pablomattos/projeto-tcc-2026/AD5941/comparative-anaysis/comparative-analysis.md

Aqui está a documentação técnica estruturada e formatada de forma limpa em **Markdown**, seguida pelo código Python integrado para gerar automaticamente o arquivo correspondente em **Microsoft Word (.docx)** para download imediato.

---

# Documentação Técnica: Análise Comparativa — AD5940/AD5941 vs. ADuCM355

**Autor:** Engenharia de Desenvolvimento

**Contexto:** Avaliação de arquitetura para o desenvolvimento de sensores analógicos de precisão, espectroscopia de bioimpedância (EIS) e medições eletroquímicas.

---

## 1. Introdução

A escolha entre o arranjo AD5940/AD5941 (Front-End Analógico integrado operando com microcontrolador host externo via SPI) e o ADuCM355 (Microcontrolador analógico integrado de chip único) dita as diretrizes de custo, tamanho e complexidade de desenvolvimento de um sensor eletrônico. Ambas as plataformas são desenvolvidas pela Analog Devices e oferecem blocos analógicos avançados equivalentes para medições na faixa de 0.016 Hz a 200 kHz. Esta documentação estabelece os critérios técnicos e financeiros para a tomada de decisão de engenharia.

---

## 2. Especificações Técnicas e Comparativo Direto

Abaixo encontra-se a tabela comparativa estruturada com os parâmetros fundamentais de cada plataforma:

| Parâmetro Técnico | Plataforma AD5940 / AD5941 | Plataforma ADuCM355 |
| --- | --- | --- |
| **Tipo de Arquitetura** | Analog Front-End (AFE) Puro. Requer MCU externo. | System-on-Chip (SoC) Analógico + Digital Completo. |
| **Processador Integrado** | Não possui (Depende de Host externo via SPI). | ARM Cortex-M3 (32 bits) operando até 26 MHz. |
| **Memória Interna** | Apenas FIFO de dados de 6 kB. | 128 kB de Memória Flash / 32 kB de SRAM. |
| **Encapsulamento / Pins** | **AD5940:** WLCSP (56 esferas)<br>

<br>**AD5941:** LFCSP (48 terminais, 7mm x 7mm). | LGA (72 terminais, 6mm x 5mm). |
| **Conversor Analógico-Digital (ADC)** | 16 bits, SAR ADC progressivo até 800 kSPS / 1.6 MSPS. | 16 bits, SAR ADC progressivo até 400 kSPS. |
| **Canais Eletroquímicos (TIAs)** | 1x TIA de Alta Velocidade (Impedância)<br>

<br>1x Potenciostato/TIA de Baixa Potência. | 1x TIA de Alta Velocidade (Impedância)<br>

<br>2x Potenciostatos/TIAs de Baixa Potência dedicados. |
| **Periféricos Digitais** | SPI (Slave), GPIOs limitados, saídas de interrupção. | I2C, SPI, UART, PWM, Timers, GPIOs configuráveis. |

---

## 3. Análise de Complexidade de Hardware (Layout da PCB)

O impacto do encapsulamento no design físico da placa de circuito impresso é um fator crítico para o custo de fabricação industrial:

* **AD5941 (LFCSP-48):** Possui pinos expostos nas laterais do chip (passo de 0.5 mm). Permite o desenvolvimento de placas de circuito impresso de 2 ou 4 camadas comuns, com vias padrão. É totalmente viável para soldadura manual em ambiente de laboratório usando estações de ar quente convencionais.
* **ADuCM355 (LGA-72):** Possui uma matriz de pinos oculta sob o encapsulamento, concentrada em uma área de apenas 6mm x 5mm. Exige estritamente placas de circuito impresso de alta densidade (mínimo de 4 a 6 camadas), com trilhas de isolamento ultra-finas e vias metalizadas microscópicas. A soldadura exige precisão industrial por forno de refluxo e aplicação automatizada de pasta de solda por stencil.

---

## 4. Análise de Arquitetura e Complexidade de Software

O modelo de desenvolvimento de firmware divide-se entre soluções modulares e de chip único:

### Abordagem AD5941 + MCU Externo (Ex: ESP32)

O desenvolvedor programa o microcontrolador host principal (utilizando ecossistemas amigáveis como Arduino IDE ou ESP-IDF para o ESP32). A Analog Devices fornece a biblioteca de firmware em C chamada `AD5940-BIFH`, encarregada de empacotar os comandos de registradores analógicos enviados via barramento SPI. A curva de aprendizado é menor, visto que as tarefas de conectividade (Wi-Fi/Bluetooth do ESP32) e o processamento analógico rodam em núcleos isolados, reduzindo interferências mútuas de temporização.

### Abordagem ADuCM355 Autónoma

O desenvolvedor programa diretamente o núcleo ARM Cortex-M3 interno usando ferramentas profissionais como Keil MDK ou IAR Embedded Workbench. Toda a gestão de registros, buffers internos de medição, calibração matemática de fase por DFT e tratamento de protocolos de comunicação externa precisam compartilhar os recursos internos de memória do chip. A arquitetura de software é altamente integrada, exigindo sólidos conhecimentos em sistemas embarçados ARM puros.

---

## 5. Avaliação Financeira e de Implementação (BOM)

Em termos de custo de componentes e insumos secundários:

1. **Produção em Baixa Escala / Protótipos:** A solução AD5941 combinada com um DevKit comercial (ESP32) apresenta custos muito inferiores. O DevKit elimina custos com reguladores chaveados e circuitos de gravação USB-UART. Os componentes periféricos (resistores de precisão de 0.1% e capacitores C0G/NP0 para o cristal externo) são baratos e fáceis de dispor em layouts LFCSP menos restritivos.
2. **Produção em Massa:** Custo unitário do circuito integrado AD5941 isolado é consideravelmente menor que o do ADuCM355. Mesmo adicionando um microcontrolador externo de baixo custo na placa, o preço do conjunto de silício costuma manter-se mais competitivo no modelo AFE + MCU separado. O ADuCM355 apenas se torna financeiramente justificável se o custo de miniaturização extrema for o principal requisito comercial do produto.

---

## 6. Diretrizes de Decisão (Veredicto)

Com base nos dados analisados, as recomendações de engenharia para o projeto são:

* **Escolha o AD5941 se:** O objetivo for flexibilidade de processamento, facilidade de soldadura e prototipagem rápida, menor custo de fabricação de PCB e se for necessária conectividade sem fios nativa através do uso conjunto com o ESP32.
* **Escolha o ADuCM355 se:** O espaço físico final do dispositivo for o parâmetro mais crítico (dispositivos médicos implantáveis ou vestíveis minúsculos - *wearables*) onde não há espaço mecânico para acomodar dois circuitos integrados na mesma face da placa.

---
