pablomattos/projeto-tcc-2026/AD5933/AD5933-projects/docs-TCC/inicio-TCC.md

---

# ANÁLISE DE PROJETOS BASEADOS NO CI AD5933 E A NECESSIDADE DE CIRCUITOS DE FRONT-END ANALÓGICO

## 1. Introdução

O circuito integrado AD5933, desenvolvido pela Analog Devices, é amplamente utilizado em sistemas de medição de impedância devido à sua alta integração, baixo custo e capacidade de realizar análise espectral por meio da Transformada Discreta de Fourier (DFT). Apesar dessas vantagens, diversos estudos demonstram que o uso direto desse componente apresenta limitações significativas, tornando necessário o desenvolvimento de circuitos auxiliares, conhecidos como front-end analógico (AFE).

Este trabalho tem como objetivo analisar diferentes projetos baseados no AD5933, destacando seus principais aspectos e, sobretudo, justificando a necessidade da utilização de circuitos de front-end analógico.

---

## 2. Revisão dos Projetos

### 2.1 Projeto AD5933-based spectrometer for electrical bioimpedance

Este projeto tem como objetivo o desenvolvimento de um espectrômetro de bioimpedância elétrica voltado a aplicações biomédicas, incluindo monitoramento fisiológico e dispositivos vestíveis. O sistema realiza medições de impedância em tecidos biológicos utilizando modelos equivalentes do tipo 2R1C, com varredura em frequência e análise dos parâmetros resistivos e capacitivos.

**Principais parâmetros:**

* **Faixa de frequência:** 5 kHz a 100 kHz
* **Modelo elétrico:** 2R1C (Re, Ri, Cm)
* **Número de medições:** 100 por ensaio

Entretanto, o AD5933 apresenta limitações relevantes nesse contexto, como a possibilidade de medição apenas em configuração de dois eletrodos, elevada sensibilidade à impedância de contato, restrições de frequência e menor acurácia quando comparado a equipamentos comerciais.
Diante disso, o front-end analógico foi desenvolvido para implementar a técnica de quatro eletrodos, eliminando a influência da impedância de contato entre eletrodo e pele. Essa adaptação possibilitou medições mais precisas e confiáveis, adequadas para aplicações biomédicas.

### 2.2 Projeto FruitMeter (Agricultura Inteligente)

O projeto Design and Validation of a Portable AD5933–Based Impedance Analyzer for Smart Agriculture propõe o desenvolvimento de um analisador portátil de impedância para monitoramento da qualidade de frutas ao longo da cadeia produtiva. O sistema realiza medições em diferentes frequências, com controle por microcontrolador e comunicação sem fio, permitindo análises diretamente em campo.

**Principais parâmetros:**

* **Faixa de frequência:** 10 Hz a 100 kHz
* **Ajustes:** Tensão de excitação, ganho e resistor de feedback (RFB)
* **Erro:** Aproximadamente 7% em amostras reais

As limitações observadas no AD5933 incluem faixa limitada de impedância, necessidade de calibração específica, sensibilidade a variações de ganho e dificuldades na medição de impedâncias muito baixas.
Nesse contexto, o front-end foi desenvolvido para adaptar o sistema às diferentes impedâncias das frutas, permitindo ajuste de ganho, controle da excitação e melhoria da relação sinal-ruído, o que garante medições mais estáveis em condições variáveis.

### 2.3 Projeto de Monitoramento Estrutural

O estudo Development of an AD5933-based impedance calibration and measurement technology tem como objetivo aplicar a técnica de impedância eletromecânica (EMI) para detecção de danos estruturais. O sistema utiliza sensores piezoelétricos excitados eletricamente, cujas respostas em frequência são analisadas para identificar alterações estruturais.

**Principais parâmetros:**

* **Ajuste do resistor de feedback (RFB)**
* **Fator de ganho (GF)**
* **Análise por DFT**
* **Faixa de frequência:** Até 100 kHz

As limitações do AD5933 nesse caso envolvem dependência crítica de calibração, necessidade de escolha adequada de parâmetros, sensibilidade a ruídos e variações, além da dependência de equipamentos externos.
O front-end analógico foi desenvolvido para permitir ajuste dinâmico de ganho e aprimorar a calibração, garantindo que pequenas variações de impedância, essenciais para a detecção de falhas estruturais, sejam corretamente capturadas.

### 2.4 Projeto Simple-Z

O projeto Simple-Z: A Low-Cost Portable Impedance Analyzer tem como objetivo a criação de um analisador de impedância portátil de baixo custo, com desempenho comparável ao de equipamentos comerciais. O sistema utiliza o AD5933 em conjunto com circuitos externos de amplificação e controle de sinal, além de uma interface gráfica para operação.

**Principais parâmetros:**

* **Faixa de impedância:** 100 Ω a 1MΩ
* **Frequência:** Até 100 kHz
* **Ajuste de amplitude:** 10 mV a 1 V

As limitações do AD5933 incluem amplitude de excitação limitada, presença de offset DC, faixa de impedância restrita e limitações do conversor analógico-digital (ADC) interno.
Nesse projeto, o front-end foi desenvolvido para expandir as capacidades do circuito, permitindo controle da amplitude do sinal, remoção de offset e ampliação da faixa de medição, transformando o sistema em um instrumento mais completo.

### 2.5 Projeto de Tomografia por Impedância

O projeto Portable impedance tomography system based on AD5933 tem como objetivo o desenvolvimento de um sistema de tomografia por impedância elétrica (EIT) para obtenção de imagens internas. O sistema realiza medições sequenciais entre múltiplos eletrodos e utiliza os dados coletados para reconstrução de imagens.

**Principais parâmetros:**

* **Sistema:** Multicanal
* **Operação:** Varredura em frequência e matrizes de impedância

As limitações do AD5933 nesse contexto incluem a capacidade de medir apenas um canal por vez, baixa velocidade para aplicações multicanais e sensibilidade a ruídos.
O front-end foi desenvolvido para implementar a multiplexação de canais, permitindo a aquisição das múltiplas medições necessárias para a reconstrução das imagens.

---

## 3. Discussão Geral

A análise dos projetos demonstra que, embora o AD5933 seja um componente versátil, ele não é suficiente para aplicações práticas sem suporte adicional. O front-end analógico atua como um elemento essencial de adaptação entre o sistema de medição e o ambiente físico.

**As principais funções do front-end incluem:**

1. Ajuste de ganho e da faixa de medição.
2. Controle da excitação do sinal.
3. Redução de ruído e aumento da precisão.
4. Adaptação a diferentes tipos de sensores.
5. Implementação de arquiteturas específicas (quatro eletrodos, multicanais, etc.).

---

## 4. Conclusão

Conclui-se que o desenvolvimento de circuitos de front-end analógico é indispensável em sistemas baseados no AD5933. Esses circuitos não apenas compensam as limitações do componente, mas também ampliam significativamente suas capacidades, viabilizando sua aplicação em diferentes áreas, como biomédica, agrícola, estrutural e de imageamento.
Em síntese, o front-end analógico não deve ser considerado um complemento opcional, mas sim um elemento fundamental para garantir medições confiáveis, precisas e compatíveis com condições reais de operação.
