pablomattos/projeto-tcc-2026/AD5933/AD5933-projects/AD933-projects-docs/AD5933-projects-table/tabela-projetos.md

| Artigo / Aplicação | Objetivo do Projeto | Modo de Operação | Parâmetros Utilizados | Limitações do AD5933 |
| --- | --- | --- | --- | --- |
| **AD5933-based spectrometer for electrical bioimpedance applications** | Desenvolver espectrômetro de bioimpedância com front-end de 4 eletrodos | Medição em modelos biológicos (2R1C), comparação com equipamento comercial, análise espectral | Frequência: 5–100 kHz; parâmetros: Re, Ri, Cm; 100 medições por teste | Menor acurácia que equipamentos profissionais; distorções em alta frequência; depende de front-end externo; faixa de frequência limitada |
| **Design and Validation of a Portable AD5933–Based Impedance Analyzer for Smart Agriculture** | Criar analisador portátil para monitorar qualidade de frutas | Sistema embarcado com STM32, comunicação Bluetooth/USB, medições programadas e calibração por faixa | Frequência: 10 Hz–100 kHz; ajuste de tensão, ganho (PGA), RFB e settling time; erro: ~1–7% | Calibração complexa; necessidade de múltiplas faixas; ruído fora da faixa calibrada; limitação de impedâncias baixas |
| **Development of an AD5933-based impedance calibration and measurement technology** | Melhorar medição para monitoramento estrutural com auto-calibração | Técnica EMI com sensores piezoelétricos, seleção automática de parâmetros, análise por DFT | Ajuste automático de RFB, ganho e fator GF; uso de DFT interno; múltiplas frequências | Forte dependência de calibração; requer instrumento externo; sensível à escolha de parâmetros; descontinuidade de dados |
| **Simple-Z: A Low-Cost Portable Impedance Analyzer** | Desenvolver analisador portátil de baixo custo (~US$100) | AD5933 com circuitos externos (amplificação, multiplexação), GUI para controle, processamento digital | Frequência até ~100 kHz; impedância: ~100 Ω a 1MΩ; ajuste de amplitude (10 mV–1 V); múltiplos RFB | Limitações nativas (amplitude e faixa); necessidade de hardware adicional; limitação do ADC; calibração obrigatória |
| **Portable impedance tomography system based on AD5933** | Sistema de tomografia por impedância multicanal | Multiplexação de eletrodos, varredura de frequência, reconstrução de imagem | Sistema multi-canais (ex: 8); matrizes de impedância; aquisição sequencial | Não suporta multicanal nativo; baixa velocidade; sensível a ruído; resolução limitada para imagem |

---
