pablomattos/projeto-tcc-2026/AD5941/AD5941-projects/AD5941-projects-docs/AD5941-projects-table/tabelas-projetos.md

---

### Tabela Comparativa de Aplicações e Artigos com o AD5941

| Artigo / Aplicação Típica | Objetivo do Projeto | Modo de Operação | Parâmetros Utilizados | Limitações Críticas do AD5941 Identificadas |
| --- | --- | --- | --- | --- |
| **Espectroscopia de Bioimpedância Elétrica (EIS) Vestível** *(Ex: Patches de hidratação e wearables médicos)* | Monitorar parâmetros fisiológicos contínuos (edemas, composição tecidual ou variação volumétrica de fluidos) diretamente no corpo humano. | Excitação por corrente ou tensão senoidal multifrequencial utilizando a malha de 4 elétrodos para eliminar a impedância de contato pele-eletrodo. | • **Frequência:** 10 Hz a 200 kHz<br>

<br>• **Amostragem:** Até 800 kSPS<br>

<br>• **Processamento:** Motor interno de DFT (16-bit SAR ADC). | • **Limite de Frequência Superior (200 kHz):** Embora atenda à maioria das aplicações biológicas, é insuficiente para caracterizar fenômenos dielétricos celulares em frequências de MHz (frequências de transição de membrana). |
| **Biossensores de Afinidade e Dispositivos Point-of-Care** *(Ex: Diagnóstico rápido de vírus e patógenos)* | Detectar a hibridização de DNA ou ligações antígeno-anticorpo em microeletrodos através da variação da impedância da interface eletrodo-eletrólito. | Varredura ratiométrica de impedância combinada com técnicas eletroquímicas de pulso (Amperometria ou Voltametria Cíclica) para monitoramento de superfície. | • **Frequência:** 0.016 Hz a 200 kHz<br>

<br>• **Sinal:** Senoides de baixa amplitude (< 50 mV) para não danificar o biofilme. | • **Saturação do HSTIA em Altas Frequências:** O Amplificador de Transimpedância de Alta Velocidade (HSTIA) pode sofrer instabilidade ou saturação se a capacitância de dupla camada do sensor for muito elevada próximo ao limite de 200 kHz.<br>

<br>• Sensibilidade extrema a ruídos de layout na PCB devido à escala de nanoamperes medida. |
| **Espectroscopia de Impedância Eletroquímica (EIS) em Baterias** *(Ex: Sensores inteligentes de State of Health - SoH)* | Mapear a impedância complexa interna de células de íons de Lítio para prever o envelhecimento químico e variações térmicas. | Varredura de frequência ultrabaixa acoplada a uma malha de potência externa (visto que o chip opera em baixa potência), utilizando o gerador de ondas integrado. | • **Frequência:** 0.1 Hz a 10 kHz<br>

<br>• **Interface:** SPI síncrona com interrupção externa (IRQ). | • **Incapacidade de Corrente Direta (DC) Elevada:** O potenciostato interno do AD5941 é projetado para correntes na escala de miliamperes ($\pm6.5\text{ mA}$ máx). Para testar baterias reais sob carga, exige circuitos integrados de potência injetores e isoladores galvânicos externos robustos. |
| **Sensores de Gases Eletroquímicos e Amperométricos** *(Ex: Detectores industriais de CO, NOx ou O2)* | Monitorar a concentração de gases tóxicos através da corrente de oxirredução gerada em uma célula galvânica/potenciostática. | Modo Potenciostato de Baixa Potência (*Low Power Loop*). O circuito mantém o eletrodo de referência polarizado enquanto o amplificador lê correntes contínuas na escala de nanoamperes. | • **Modo:** Amperometria de Potência Ultra-Baixa<br>

<br>• **Consumo Local:** < 100 $\mu$A em modo de hibernação ativa. | • **Limitação de Canais Simultâneos:** O AD5941 possui apenas **um** canal completo de TIA de Alta Velocidade e uma malha de baixa potência. Se o projeto exigir um nariz eletrônico (matriz com múltiplos sensores de gases diferentes medindo ao mesmo tempo), é necessário duplicar os chips ou criar matrizes de chaveamento complexas. |

---

### Principais Desafios de Engenharia com o AD5941:

* **Gestão da FIFO em Firmware:** O barramento SPI precisa ser gerenciado via interrupções externas ($IRQ$) de forma ultra-rápida. Se a MCU host (como o ESP32) atrasar a leitura devido a tarefas prioritárias do Wi-Fi ou Bluetooth, a FIFO de 6 kB estoura (*overflow*) e corrompe os dados da varredura.
* **Layout Crítico da PCB:** O encapsulamento LFCSP-48 possui um *pitch* de 0.5 mm. Devido à alta sensibilidade analógica (escala de pico/nanoamperes), qualquer fuga de corrente ou capacitância parasita próxima às trilhas dos elétrodos degrada a precisão das leituras de fase.
