pablomattos/projeto-tcc-2026/AD5933/codes/esp-code/teoric/Bioimpedance_Firmware_Blueprints.pptx

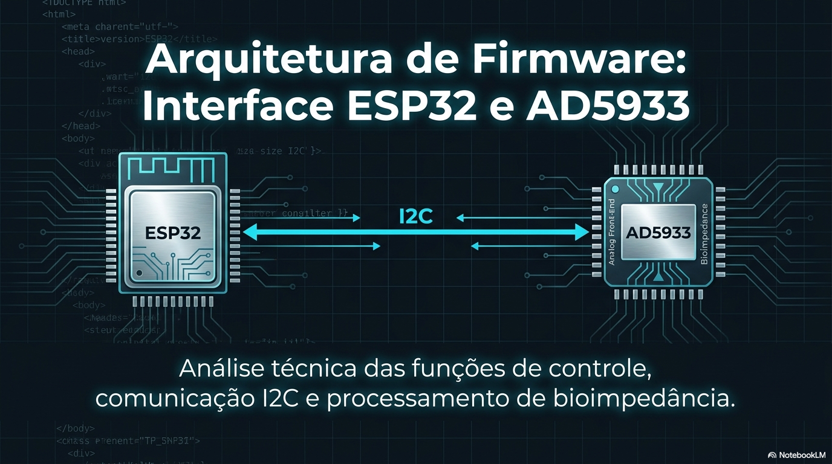
[picture p9: figure]

## Slide 2

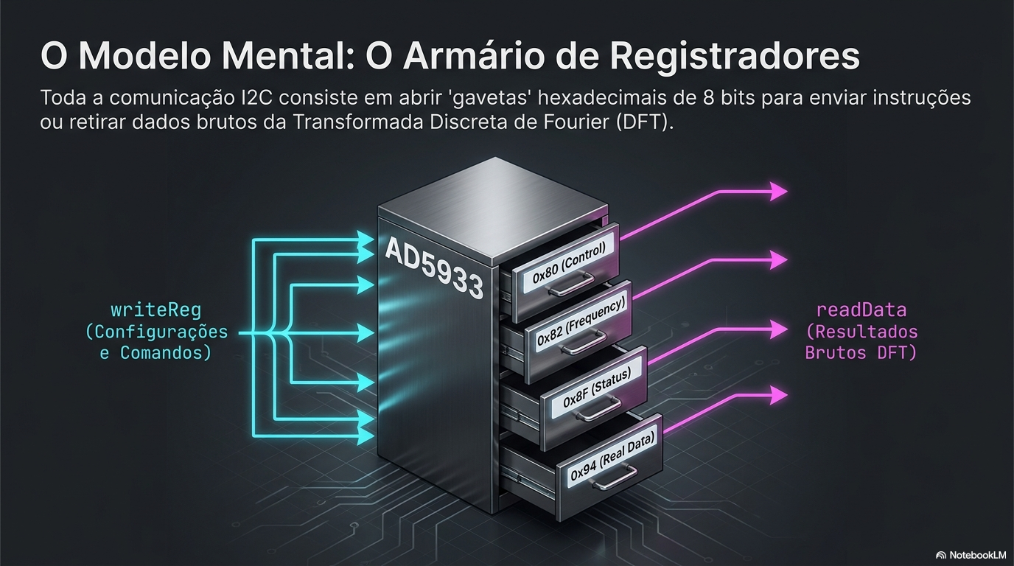
[picture p10: figure]

## Slide 3

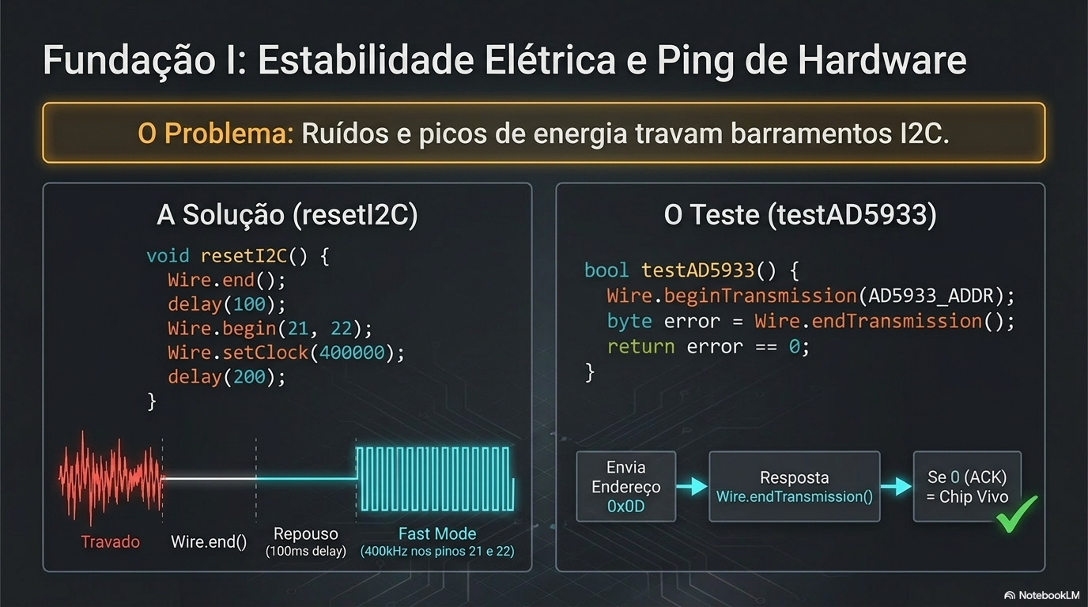
[picture p11: figure]

## Slide 4

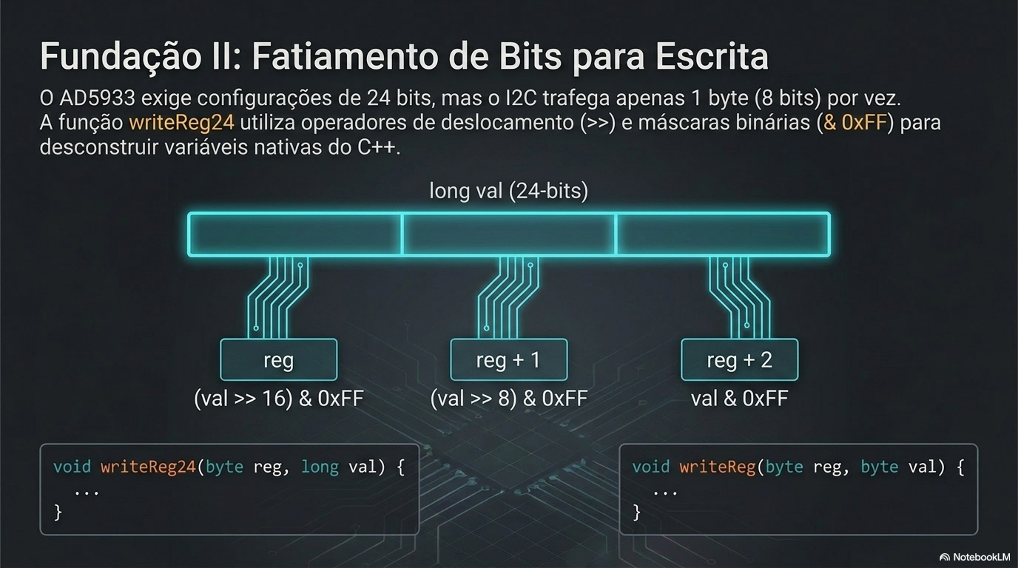
[picture p12: figure]

## Slide 5

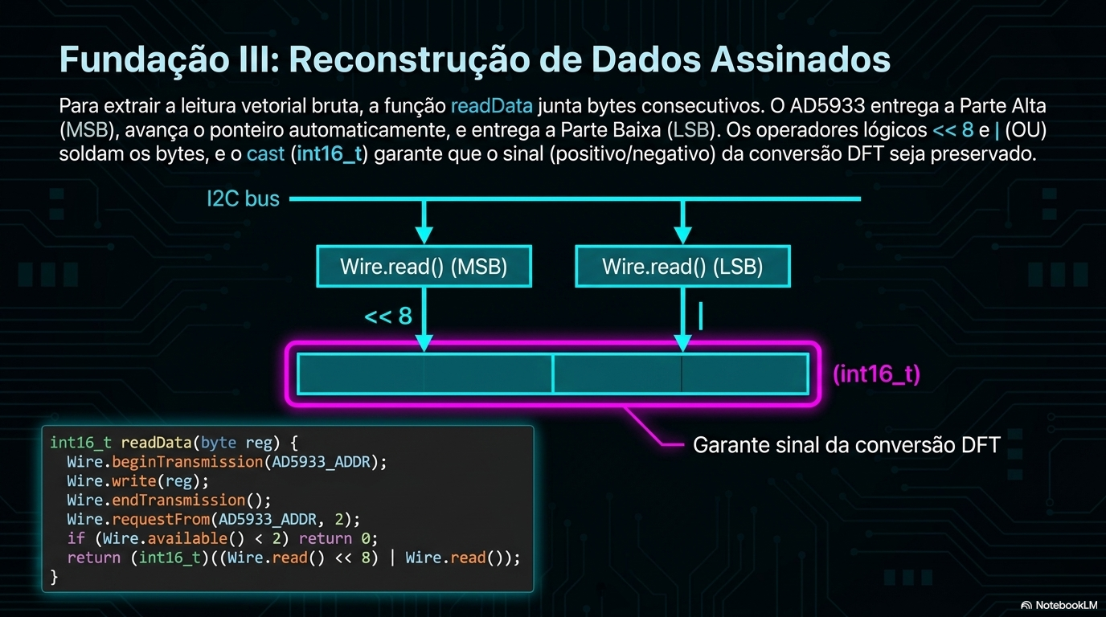
[picture p13: figure]

## Slide 6

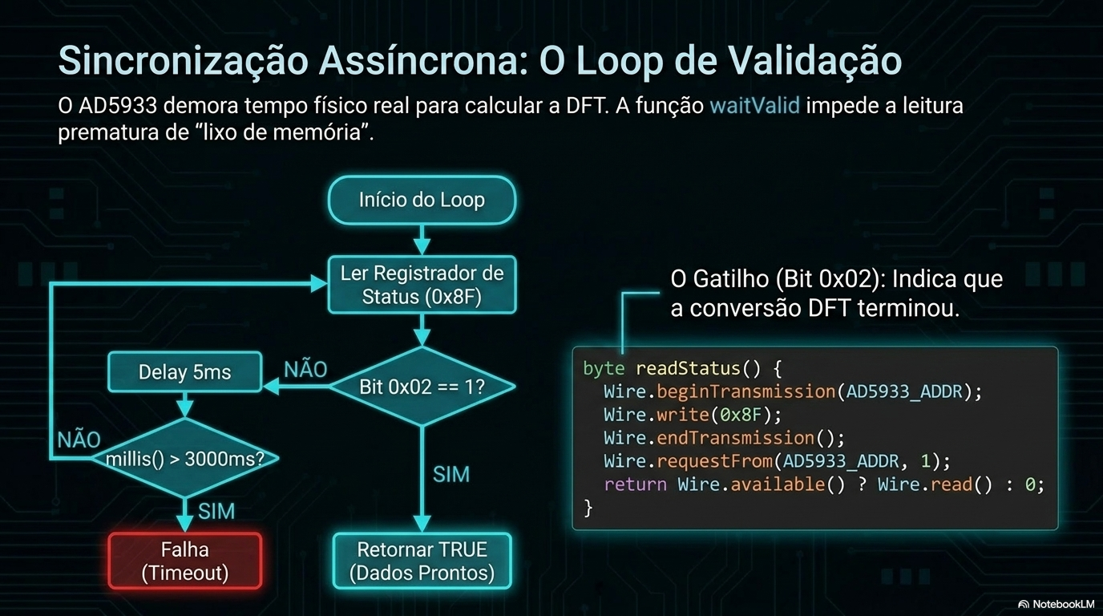
[picture p14: figure]

## Slide 7

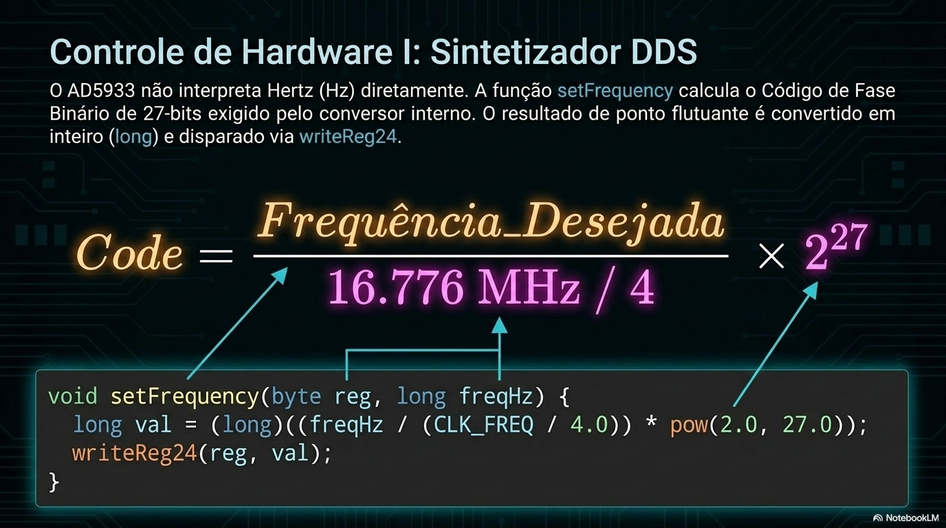
[picture p15: figure]

## Slide 8

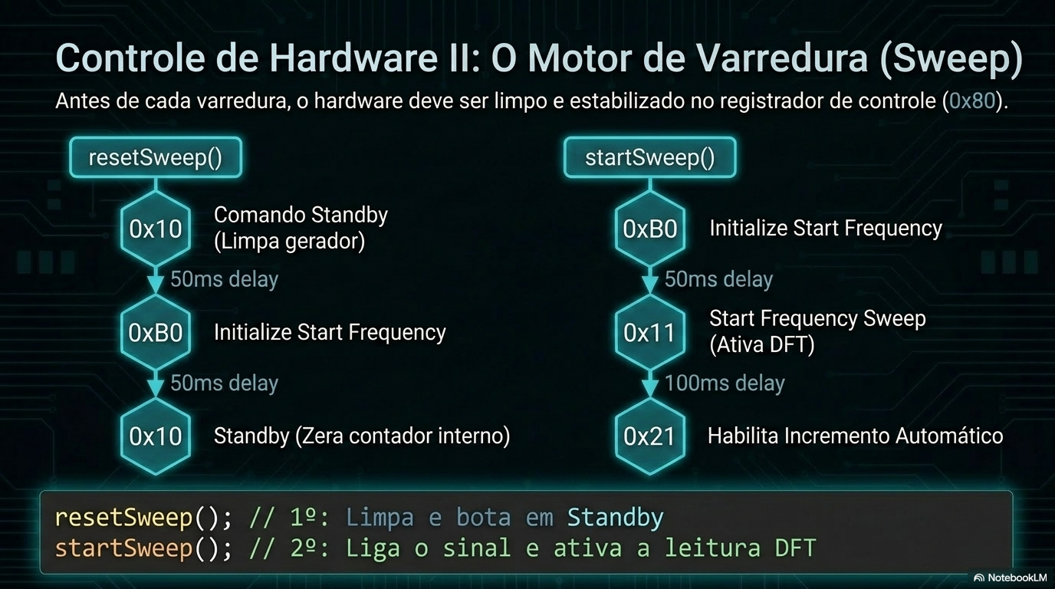
[picture p16: figure]

## Slide 9

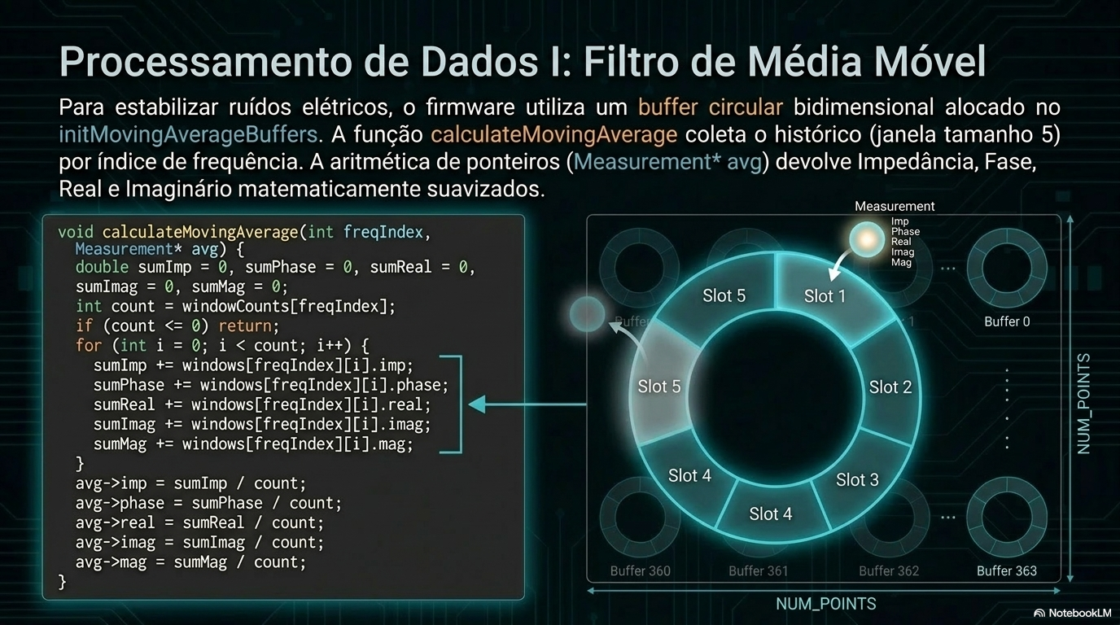
[picture p17: figure]

## Slide 10

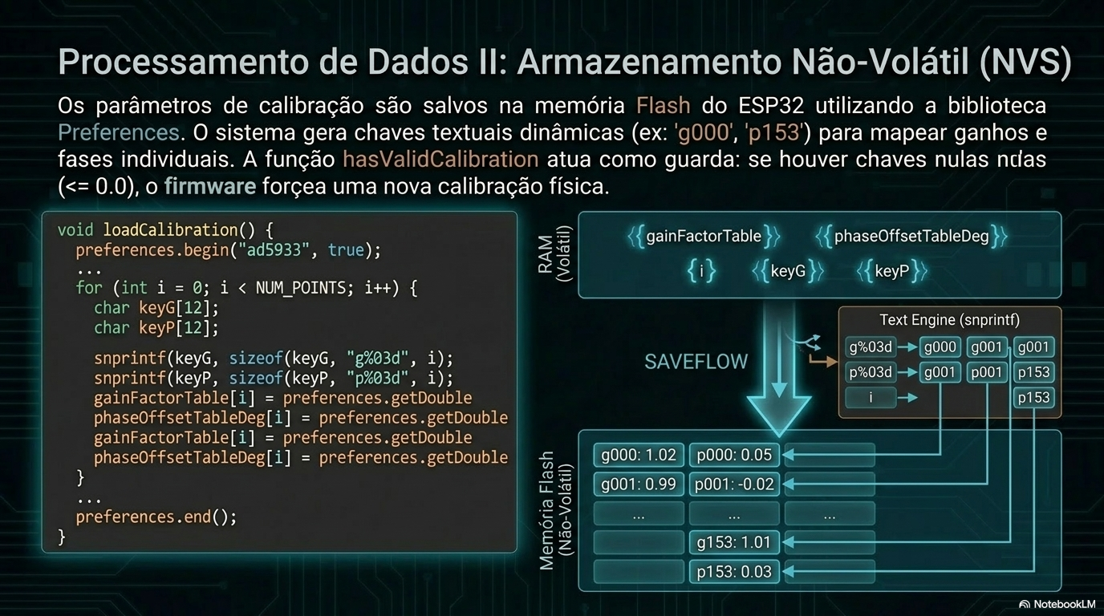
[picture p18: figure]

## Slide 11

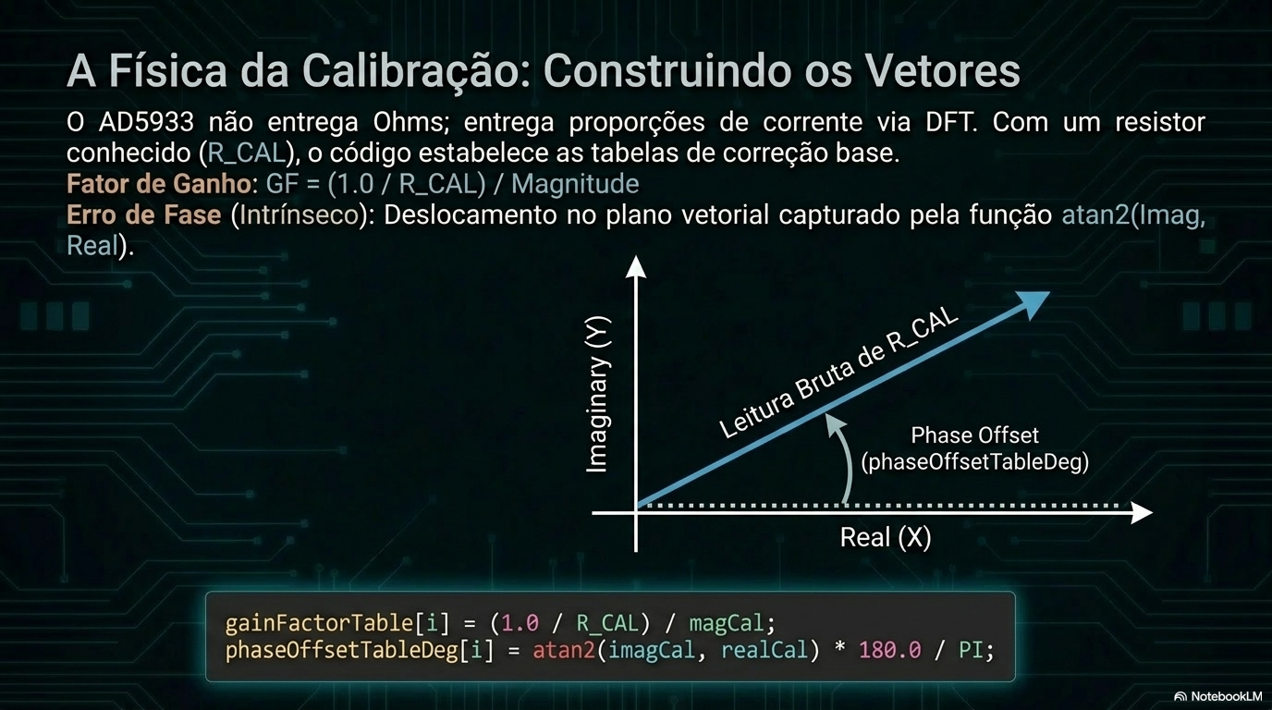
[picture p19: figure]

## Slide 12

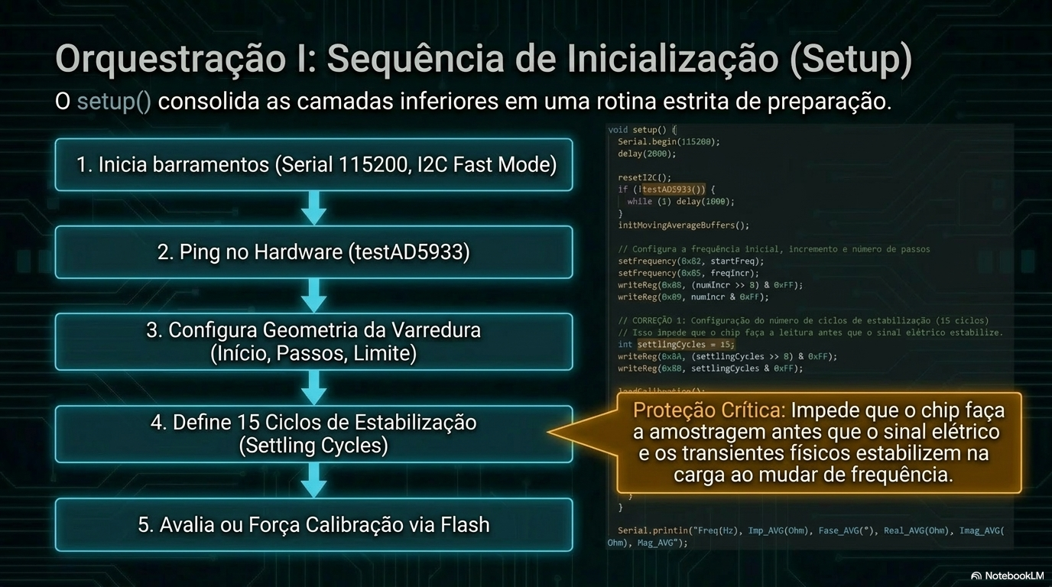
[picture p20: figure]

## Slide 13

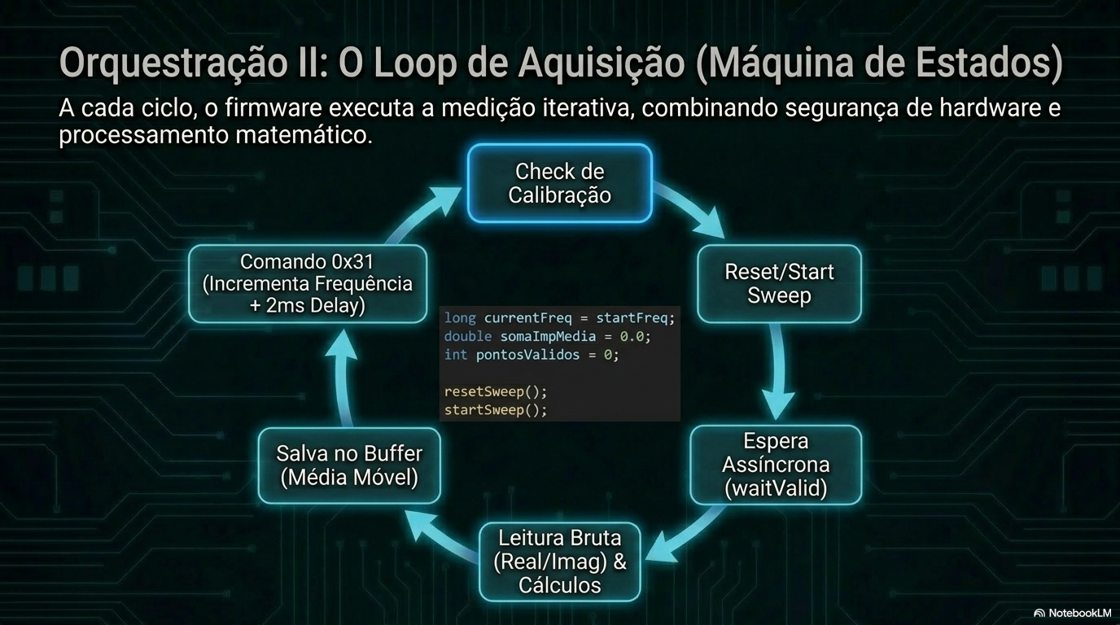
[picture p21: figure]

## Slide 14

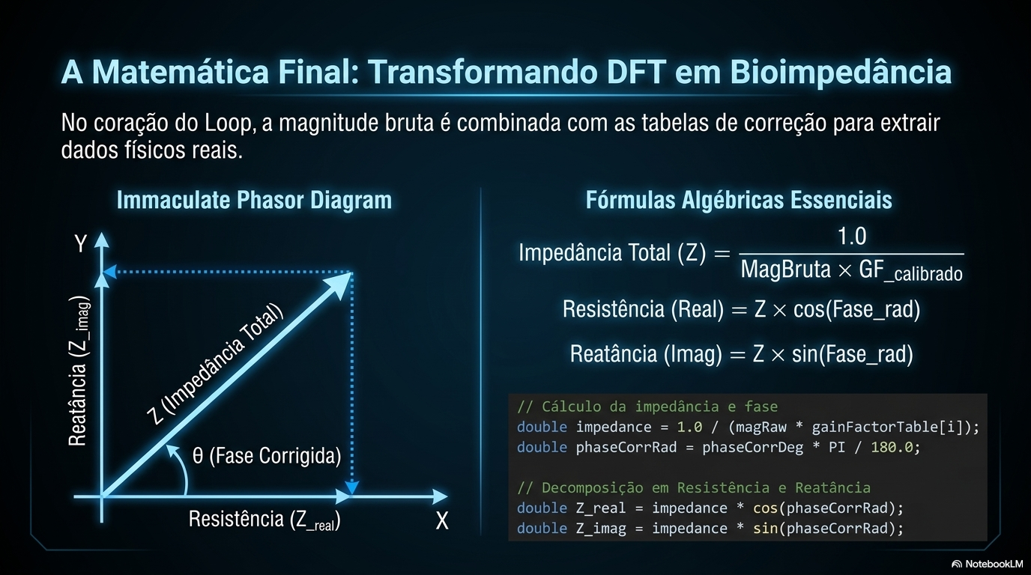
[picture p22: figure]
