pablomattos/projeto-tcc-2026/AD5933/electrical-diagrams/esquematico-com-front.pdf

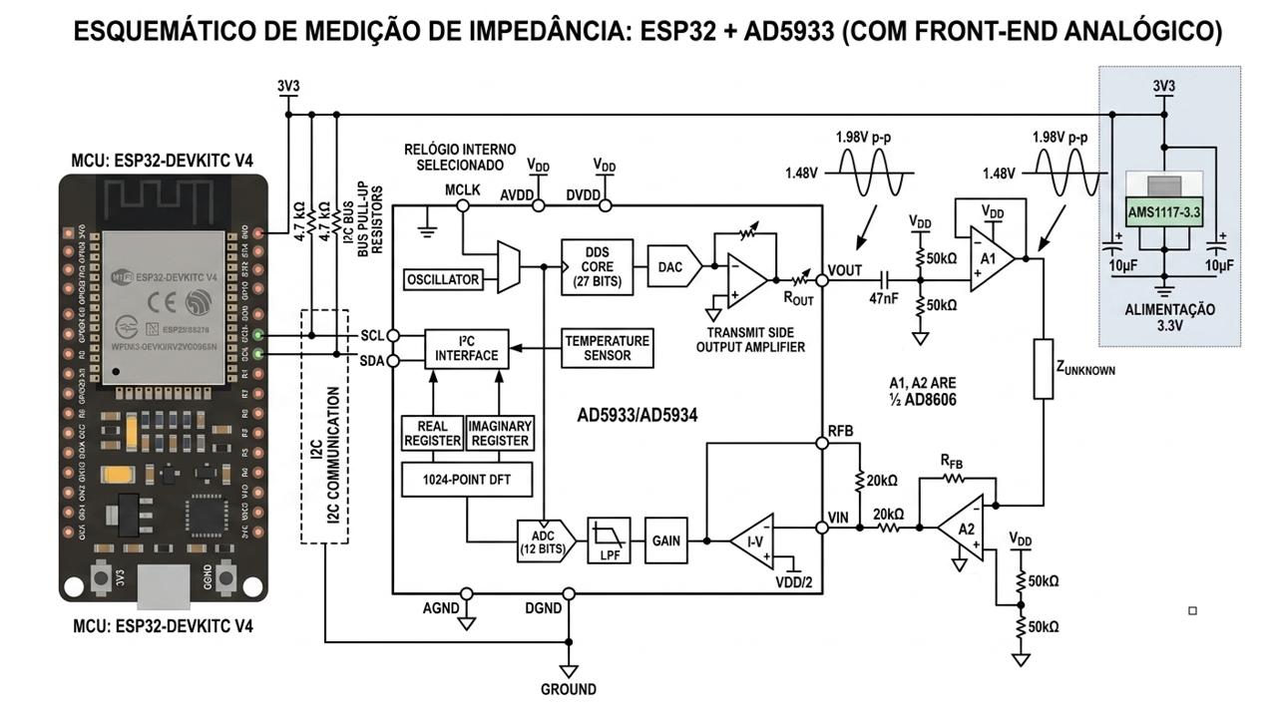
[picture p47: figure]
