pablomattos/projeto-tcc-2026/AD5933/AD5933-projects/AD933-projects-docs/AD5933-project-research/tomografia-8-canais/hardware/System_BIM/System_BIM/BIM_System_Desing/Instrumentation_amplifier.jpg

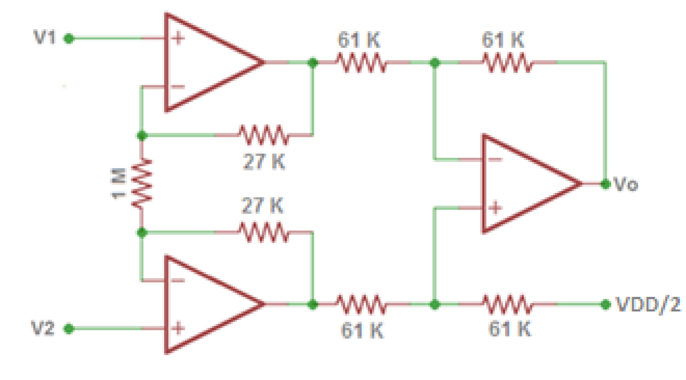
AD5933/AD5933-projects/AD933-projects-docs/AD5933-project-research/tomografia-8-canais/hardware/System_BIM/System_BIM/BIM_System_Desing/Instrumentation_amplifier.jpg
