pablomattos/projeto-tcc-2026/resumos-tcc/images/circuito-reativo.png

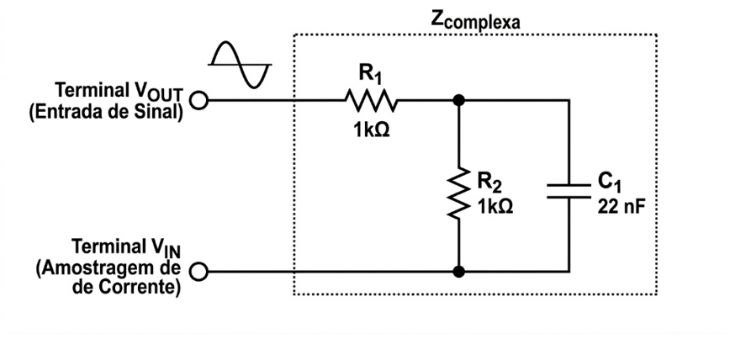
resumos-tcc/images/circuito-reativo.png
