pablomattos/projeto-tcc-2026/resumos-tcc/images/comparacao-teorico-versus-bancada-circuito-reativo.png

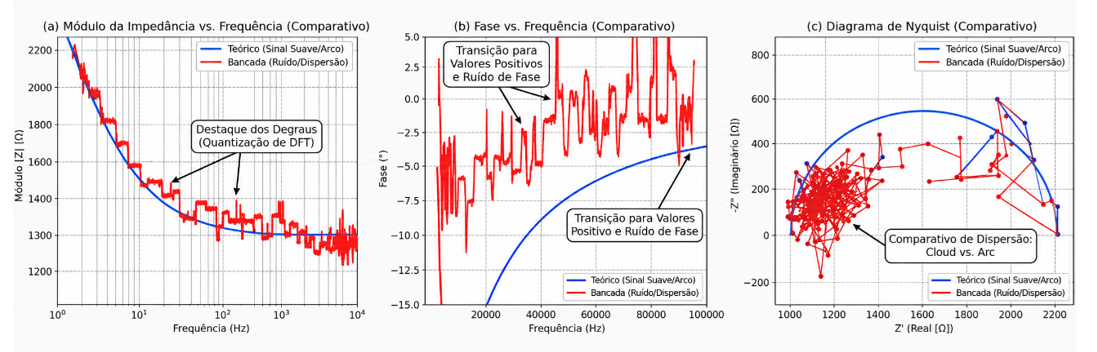
resumos-tcc/images/comparacao-teorico-versus-bancada-circuito-reativo.png
