pablomattos/projeto-tcc-2026/resumos-tcc/images/comparacao_impedancia_fase.png

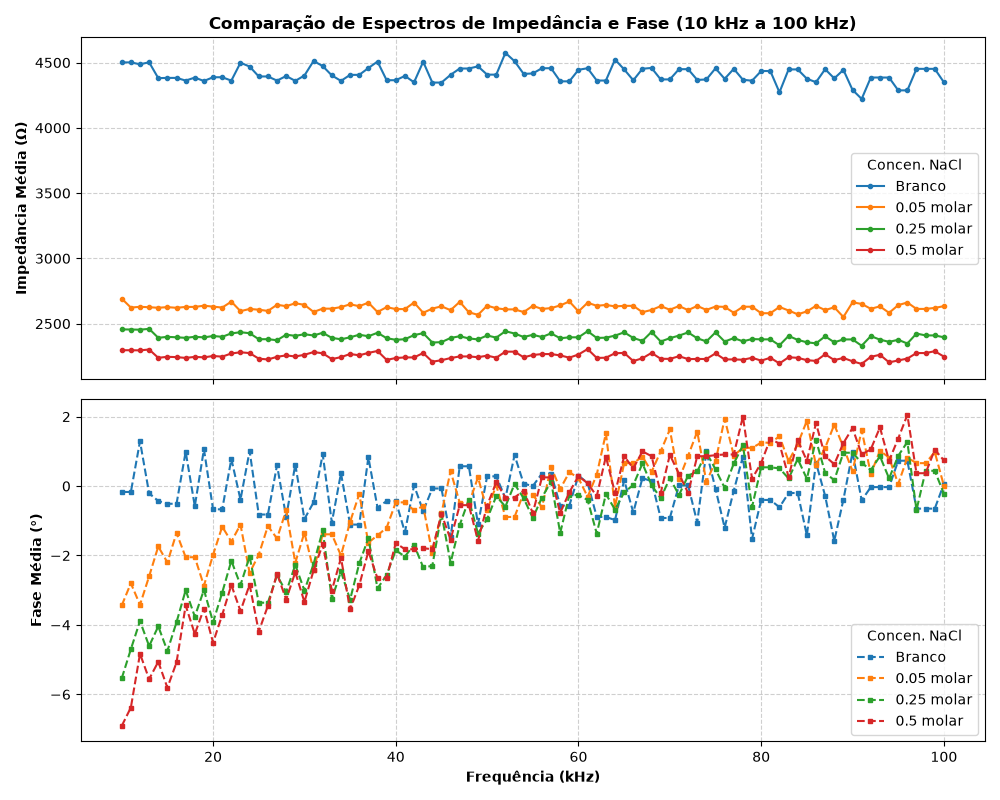
resumos-tcc/images/comparacao_impedancia_fase.png
