pablomattos/projeto-tcc-2026/AD5933/AD5933-projects/AD933-projects-docs/AD5933-project-research/tomografia-8-canais/hardware/System_BIM/System_BIM/BIM_System_Components/BIM_System_Components.xlsx

Designator | Component | Number | Cost per unit -currency | Total cost - | Source of materials | Material type
 |  |  |  | currency
Impedance converter | AD5933, 1MSPS, 12 bits | 1 | $35.96 USD | $35.96 USD | digikey | Other
Operational amplifier | TL084 JFET-Input | 1 | $0.64 USD | $0.64 USD | sigmaelectronica (https://www.sigmaelectronica.net/producto/tl084/) | Other
Multiplexer | 74HC4067, High-Speed CMOS Logic 16 Channel Analog Multiplexer-Demultiplexer | 4 | $1.09 USD | $4.36 USD | mercadolibre (https://articulo.mercadolibre.com.co/MCO-473185236-modulo-multiplexor-analogo-16-canales-cd74hc4067-arduino-_JM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) | Other
Arduino | Arduino Mega 2560, 16 MHz crystal oscillator | 1 | $12.07 USD | $12.07 USD | electrotekmega (http://electrotekmega.com/producto/arduino-mega-compatible/) | Other
Bluetooth | Module bluetooth HC-05 v2.0 | 1 | $4.83 USD | $4.83 USD | electrotekmega (http://electrotekmega.com/producto/arduino-mega-compatible/) | Other
Lithium battery | Battery LiPo Turnigy Nano-Tech 7.4 V (2S) 300 mAh 35-70C | 1 | $9.12 USD | $9.12 USD | demosspro (https://demosspro.com/cb/busqueda?s=bateria+lipo+7.4v) | Compound
Dual source DC | Source DC-DC output +/- 5V 300 mA | 1 | $13.52 USD | $13.52 USD | digikey | Other
