pablomattos/projeto-tcc-2026/AD5933/codes/graphics/bode/teste-01-005molar.csv

Timestamp,Sweep_ID,Freq(Hz),Imp_AVG(Ohm),Fase_AVG(°),Real_AVG(Ohm),Imag_AVG(Ohm),Mag_AVG
2026-09-24 16:55:48.274,16,10000,2691.81,-3.44,2686.9598456048593,-161.51738051092326,2691.81
2026-09-24 16:55:48.274,16,11000,2623.39,-2.8,2620.258032640145,-128.15199758411384,2623.39
2026-09-24 16:55:48.275,16,12000,2629.08,-3.42,2624.397780141641,-156.83729782046998,2629.08
2026-09-24 16:55:48.275,16,13000,2625.87,-2.6,2623.166850096344,-119.11730963896362,2625.87
2026-09-24 16:55:48.393,16,14000,2621.88,-1.74,2620.671065785584,-79.61092484233866,2621.88
2026-09-24 16:55:48.394,16,15000,2626.64,-2.2,2624.7039467607938,-100.83095486164338,2626.64
2026-09-24 16:55:48.394,16,16000,2621.49,-1.35,2620.762353592186,-61.76168791366067,2621.49
2026-09-24 16:55:48.395,16,17000,2628.29,-2.05,2626.6078705533387,-94.01818147175307,2628.29
2026-09-24 16:55:48.395,16,18000,2628.29,-2.05,2626.6078705533387,-94.01818147175307,2628.29
2026-09-24 16:55:48.503,16,19000,2637.71,-2.87,2634.401548523456,-132.07015271142402,2637.71
2026-09-24 16:55:48.503,16,20000,2630.47,-1.98,2628.8994735593055,-90.88442561630808,2630.47
2026-09-24 16:55:48.504,16,21000,2623.35,-1.17,2622.8030626168947,-53.566008134244775,2623.35
2026-09-24 16:55:48.504,16,22000,2668.68,-1.6,2667.639521805893,-74.5139188288138,2668.68
2026-09-24 16:55:48.609,16,23000,2595.74,-1.11,2595.2528998050575,-50.284526978383234,2595.74
2026-09-24 16:55:48.610,16,24000,2612.67,-2.5,2610.1833170802724,-113.9630647877924,2612.67
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
2026-09-24 16:55:50.083,16,99000,2620.66,0.98,2620.2766663159787,44.822177100421214,2620.66
2026-09-24 16:55:50.083,16,100000,2634.26,0.01,2634.259959877926,0.45976510120165065,2634.26
 | Timestamp,Sweep_ID,Freq(Hz),Imp_AVG(Ohm),Fase_AVG(°),Real_AVG(Ohm),Imag_AVG(Ohm),Mag_AVG
