pablomattos/projeto-tcc-2026/AD5933/codes/graphics/bode/teste-01-025molar.csv

Timestamp | Sweep_ID | Freq(Hz) | Imp_AVG(Ohm) | Fase_AVG(°) | Real_AVG(Ohm) | Imag_AVG(Ohm) | Mag_AVG
2026-09-24 17:21:24.556 | 28 | 10000 | 2456.19 | -5.54 | 2444.7172417390393 | -237.1221711351863 | 2456.19
2026-09-24 17:21:24.557 | 28 | 11000 | 2455.24 | -4.7 | 2446.9839776111157 | -201.17870392882168 | 2455.24
2026-09-24 17:21:24.672 | 28 | 12000 | 2453.82 | -3.89 | 2448.1667288755493 | -166.46999737728507 | 2453.82
2026-09-24 17:21:24.672 | 28 | 13000 | 2460.29 | -4.61 | 2452.3306319783683 | -197.74062698539265 | 2460.29
2026-09-24 17:21:24.672 | 28 | 14000 | 2391.69 | -4.04 | 2385.7469085516473 | -168.50146716351512 | 2391.69
2026-09-24 17:21:24.672 | 28 | 15000 | 2399.0 | -4.75 | 2390.76064049213 | -198.6568898217782 | 2399.0
2026-09-24 17:21:24.672 | 28 | 16000 | 2395.65 | -3.92 | 2390.0453199005465 | -163.77512424509325 | 2395.65
2026-09-24 17:21:24.781 | 28 | 17000 | 2391.36 | -3.0 | 2388.0827242306977 | -125.15411232112618 | 2391.36
2026-09-24 17:21:24.781 | 28 | 18000 | 2399.42 | -3.76 | 2394.2552317522905 | -157.34745510107888 | 2399.42
2026-09-24 17:21:24.782 | 28 | 19000 | 2394.85 | -2.99 | 2391.5897802734144 | -124.91935555293561 | 2394.85
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
