pablomattos/projeto-tcc-2026/AD5933/codes/graphics/bode/teste-01-050molar.csv

Timestamp,Sweep_ID,Freq(Hz),Imp_AVG(Ohm),Fase_AVG(°),Real_AVG(Ohm),Imag_AVG(Ohm),Mag_AVG
2026-09-24 17:31:47.174,13,10000,2296.57,-6.91,2279.888539931416,-276.3005797847667,2296.57
2026-09-24 17:31:47.174,13,11000,2296.57,-6.38,2282.3468105949737,-255.19953187055887,2296.57
2026-09-24 17:31:47.174,13,12000,2295.45,-4.83,2287.2986482515253,-193.27595868794316,2295.45
2026-09-24 17:31:47.174,13,13000,2302.04,-5.56,2291.209553648415,-223.04022702246326,2302.04
2026-09-24 17:31:47.284,13,14000,2238.54,-5.06,2229.8161468226417,-197.4367822089542,2238.54
2026-09-24 17:31:47.284,13,15000,2246.04,-5.81,2234.5022183539886,-227.3664833943283,2246.04
2026-09-24 17:31:47.285,13,16000,2243.83,-5.08,2235.0163136011092,-198.6835343880015,2243.83
2026-09-24 17:31:47.285,13,17000,2237.57,-3.44,2233.538303866196,-134.2614988092869,2237.57
2026-09-24 17:31:47.385,13,18000,2245.62,-4.26,2239.415880871059,-166.81036209570166,2245.62
2026-09-24 17:31:47.385,13,19000,2241.87,-3.53,2237.6164925625376,-138.03452145071327,2241.87
2026-09-24 17:31:47.385,13,20000,2252.37,-4.51,2245.395817511936,-177.1108116403493,2252.37
2026-09-24 17:31:47.385,13,21000,2247.37,-3.71,2242.660276721952,-145.41939386965183,2247.37
2026-09-24 17:31:47.386,13,22000,2271.67,-2.85,2268.860233992391,-112.95055337621399,2271.67
2026-09-24 17:31:47.495,13,23000,2280.82,-3.6,2276.3193227337706,-143.21387275284854,2280.82
2026-09-24 17:31:47.496,13,24000,2274.68,-2.84,2271.886216115066,-112.70369748312838,2274.68
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
2026-09-24 17:31:48.919,13,99000,2288.93,1.05,2288.545652823991,41.94448522048157,2288.93
2026-09-24 17:31:48.920,13,100000,2247.73,0.74,2247.5425323721415,29.02960692503072,2247.73
 | Timestamp,Sweep_ID,Freq(Hz),Imp_AVG(Ohm),Fase_AVG(°),Real_AVG(Ohm),Imag_AVG(Ohm),Mag_AVG
