pablomattos/projeto-tcc-2026/AD5933/codes/graphics/bode/teste-01-branco.csv

Timestamp | Sweep_ID | Freq(Hz) | Imp_AVG(Ohm) | Fase_AVG(°) | Real_AVG(Ohm) | Imag_AVG(Ohm) | Mag_AVG
2026-09-24 16:41:51.137 | 27 | 10000 | 4501.4 | -0.17 | 4501.380186104404 | -13.355903065033386 | 4501.4
2026-09-24 16:41:51.137 | 27 | 11000 | 4501.4 | -0.17 | 4501.380186104404 | -13.355903065033386 | 4501.4
2026-09-24 16:41:51.137 | 27 | 12000 | 4487.01 | 1.29 | 4485.87278428726 | 101.01536165781836 | 4487.01
2026-09-24 16:41:51.256 | 27 | 13000 | 4502.15 | -0.21 | 4502.119759929224 | -16.50120464768655 | 4502.15
2026-09-24 16:41:51.257 | 27 | 14000 | 4380.79 | -0.43 | 4380.666629294763 | -32.877151386033134 | 4380.79
2026-09-24 16:41:51.257 | 27 | 15000 | 4382.61 | -0.51 | 4382.436381879847 | -39.00988177202971 | 4382.61
2026-09-24 16:41:51.257 | 27 | 16000 | 4382.61 | -0.51 | 4382.436381879847 | -39.00988177202971 | 4382.61
2026-09-24 16:41:51.257 | 27 | 17000 | 4362.24 | 0.99 | 4361.588830756663 | 75.37034575164729 | 4362.24
2026-09-24 16:41:51.364 | 27 | 18000 | 4384.85 | -0.58 | 4384.62533689372 | -44.38668234549005 | 4384.85
2026-09-24 16:41:51.364 | 27 | 19000 | 4358.99 | 1.06 | 4358.244049592364 | 80.63885101334462 | 4358.99
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
