pablomattos/projeto-tcc-2026/AD5933/codes/graphics/bode/teste-02-branco.csv

Timestamp | Sweep_ID | Freq(Hz) | Imp_AVG(Ohm) | Fase_AVG(°) | Real_AVG(Ohm) | Imag_AVG(Ohm) | Mag_AVG
2026-09-25 08:50:31.640 | 1 | 10000 | 4618.0 | 0.0 | 4618.0 | 0.0 | 4618.0
2026-09-25 08:50:31.743 | 1 | 11000 | 4618.0 | 0.0 | 4618.0 | 0.0 | 4618.0
2026-09-25 08:50:31.744 | 1 | 12000 | 4618.0 | 0.0 | 4618.0 | 0.0 | 4618.0
2026-09-25 08:50:31.744 | 1 | 13000 | 4618.0 | 0.0 | 4618.0 | 0.0 | 4618.0
2026-09-25 08:50:31.744 | 1 | 14000 | 4618.0 | 0.0 | 4618.0 | 0.0 | 4618.0
2026-09-25 08:50:31.853 | 1 | 15000 | 4618.0 | 0.0 | 4618.0 | 0.0 | 4618.0
2026-09-25 08:50:31.853 | 1 | 16000 | 4618.0 | 0.0 | 4618.0 | 0.0 | 4618.0
2026-09-25 08:50:31.853 | 1 | 17000 | 4618.0 | 0.0 | 4618.0 | 0.0 | 4618.0
2026-09-25 08:50:31.854 | 1 | 18000 | 4618.0 | 0.0 | 4618.0 | 0.0 | 4618.0
2026-09-25 08:50:31.854 | 1 | 19000 | 4618.0 | 0.0 | 4618.0 | 0.0 | 4618.0
2026-09-25 08:50:31.972 | 1 | 20000 | 4618.0 | 0.0 | 4618.0 | 0.0 | 4618.0
2026-09-25 08:50:31.972 | 1 | 21000 | 4618.0 | 0.0 | 4618.0 | 0.0 | 4618.0
2026-09-25 08:50:31.973 | 1 | 22000 | 4618.0 | 0.0 | 4618.0 | 0.0 | 4618.0
2026-09-25 08:50:31.973 | 1 | 23000 | 4618.0 | 0.0 | 4618.0 | 0.0 | 4618.0
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
