pablomattos/projeto-tcc-2026/resumos-tcc/images/curva-erro-teste-resistivo.png

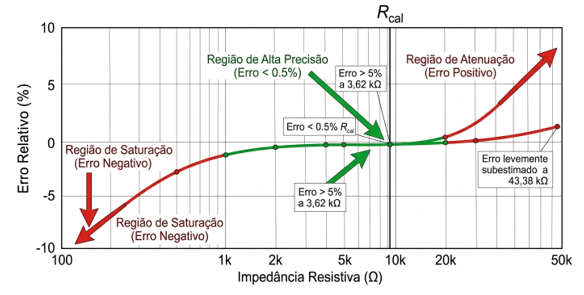
resumos-tcc/images/curva-erro-teste-resistivo.png
