pablomattos/projeto-tcc-2026/resumos-tcc/images/curvas-bancada-teste-circuito-reativo.png

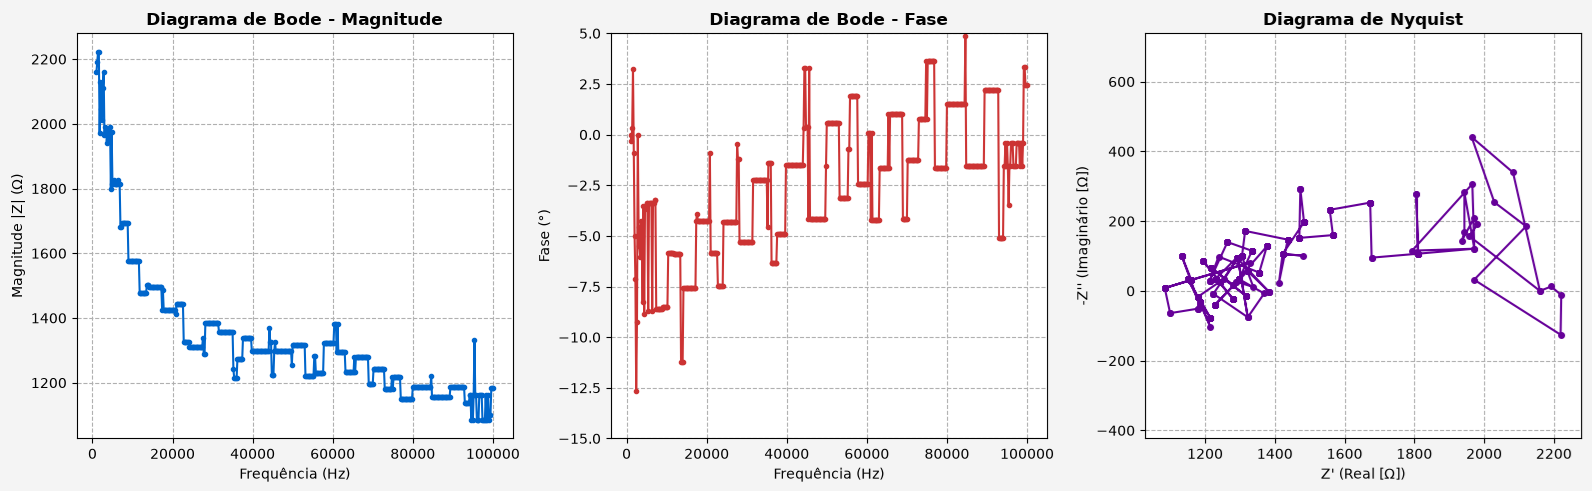
resumos-tcc/images/curvas-bancada-teste-circuito-reativo.png
