pablomattos/projeto-tcc-2026/resumos-tcc/images/curvas-teorico-teste-circuito-reativo.png

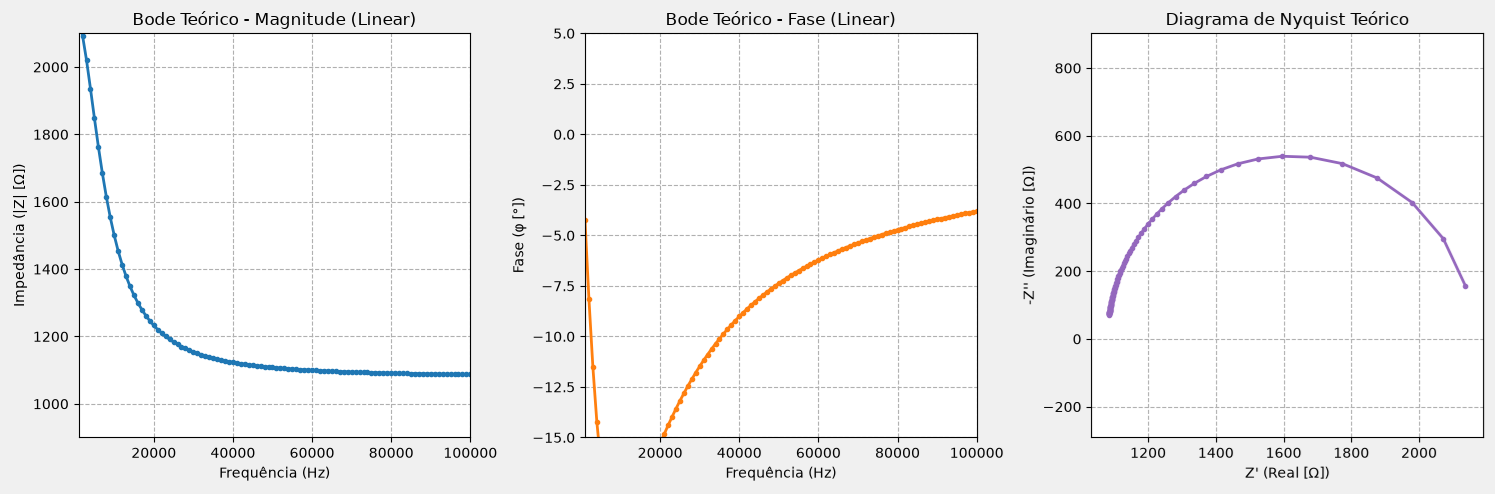
resumos-tcc/images/curvas-teorico-teste-circuito-reativo.png
