pablomattos/projeto-tcc-2026/AD5933/PCB/pcb-sensor-AD5933_2/pcb-sensor-AD5933_2/Project Outputs for pcb-sensor-AD5933_2/Job1.PDF

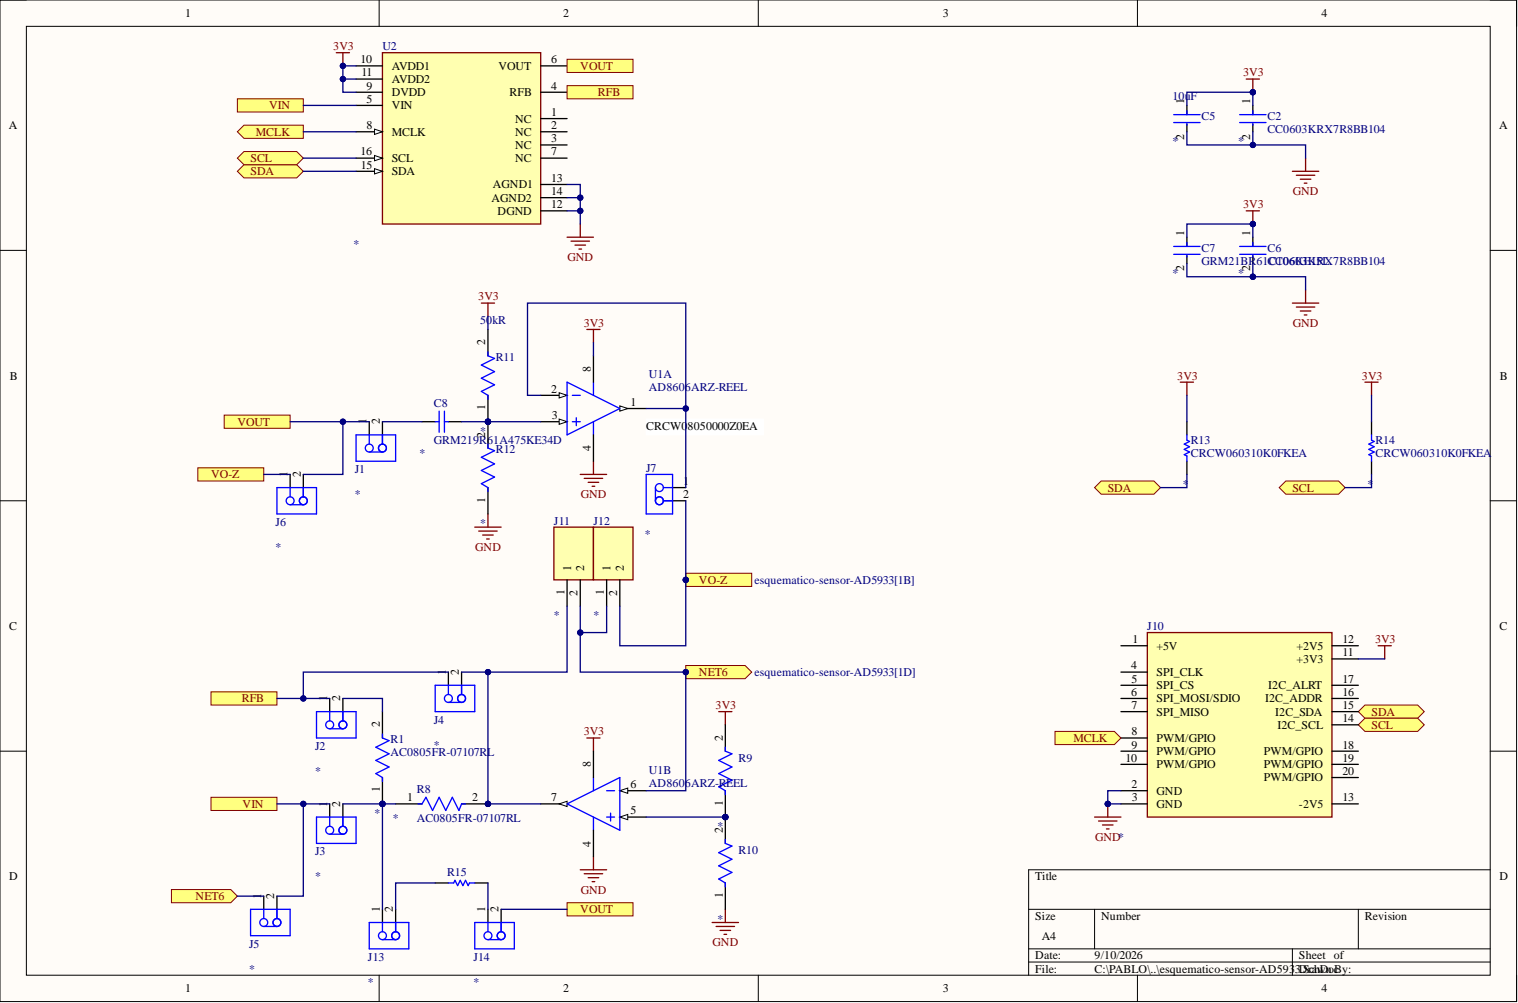
[picture p62: page 1]

1 1

1 4
1 2

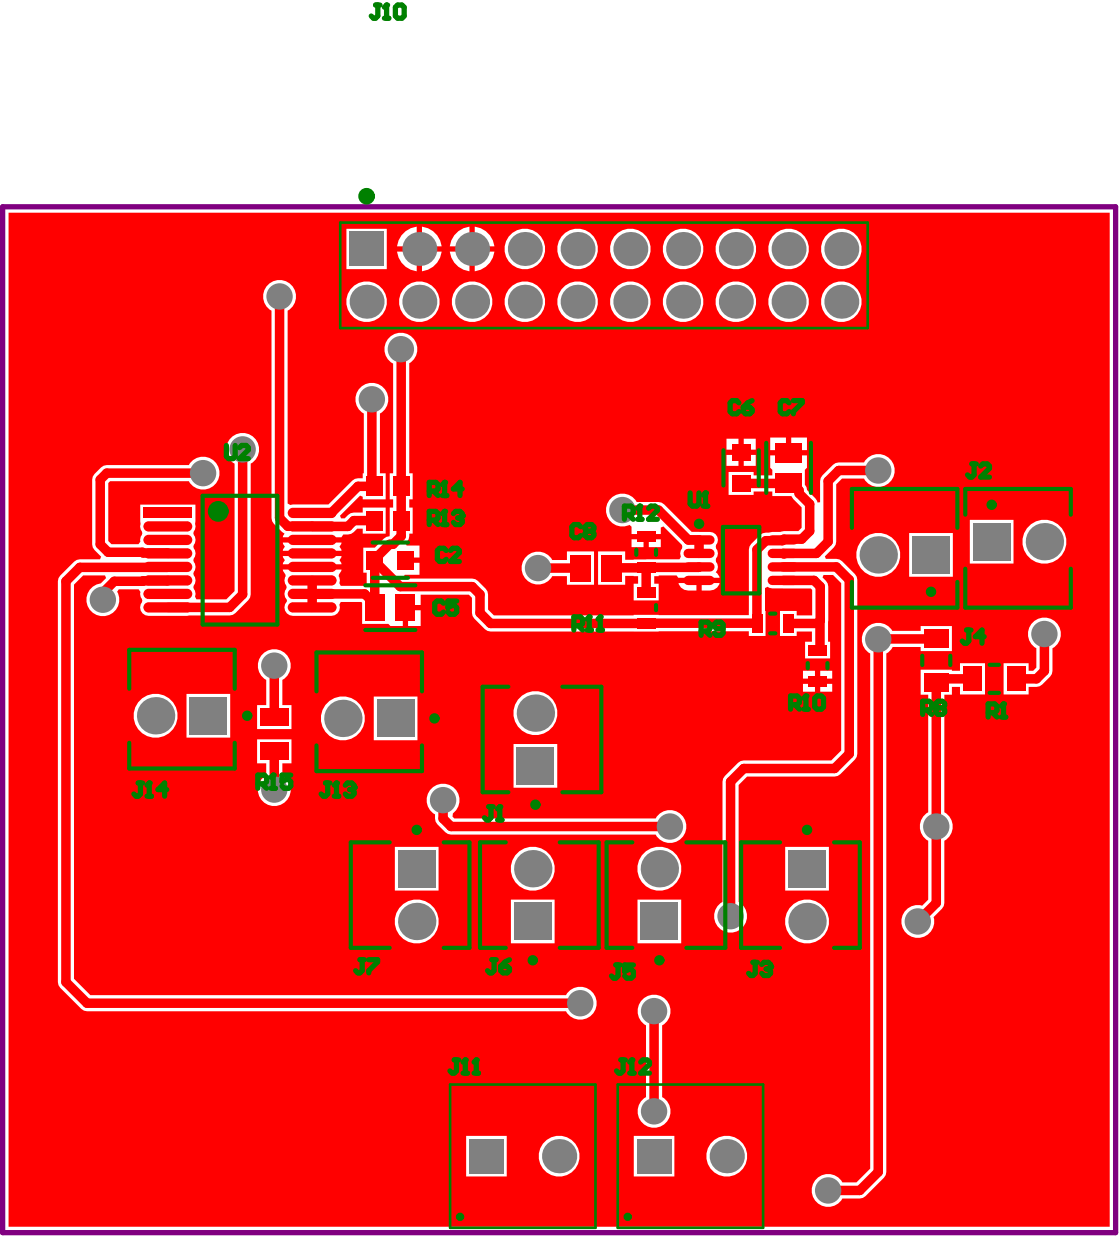
[picture p63: page 2]

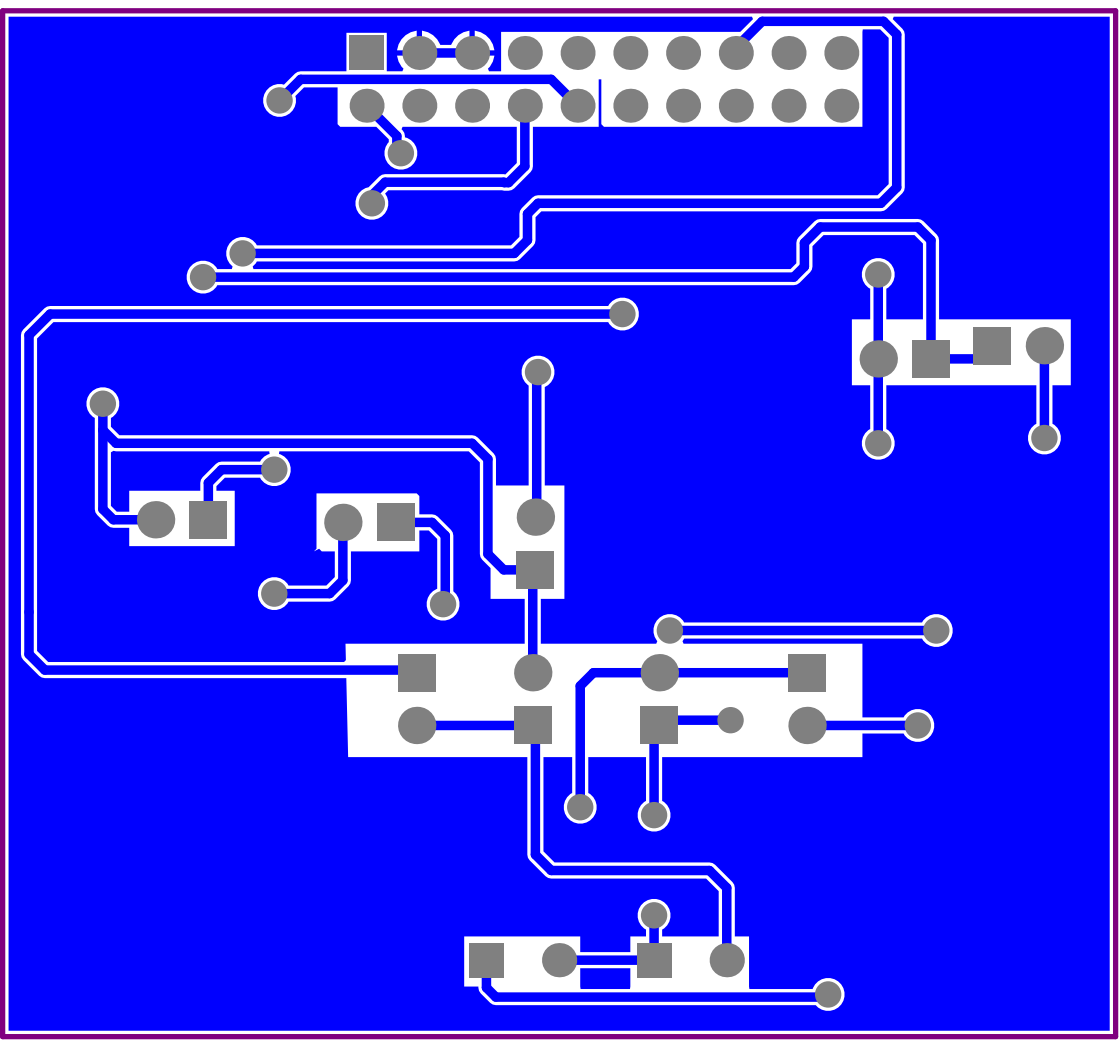
[picture p64: page 3]
