pablomattos/projeto-tcc-2026/AD5933/AD5933-projects/AD933-projects-docs/AD5933-project-research/tomografia-8-canais/docs/tomografia-8-canais.pdf

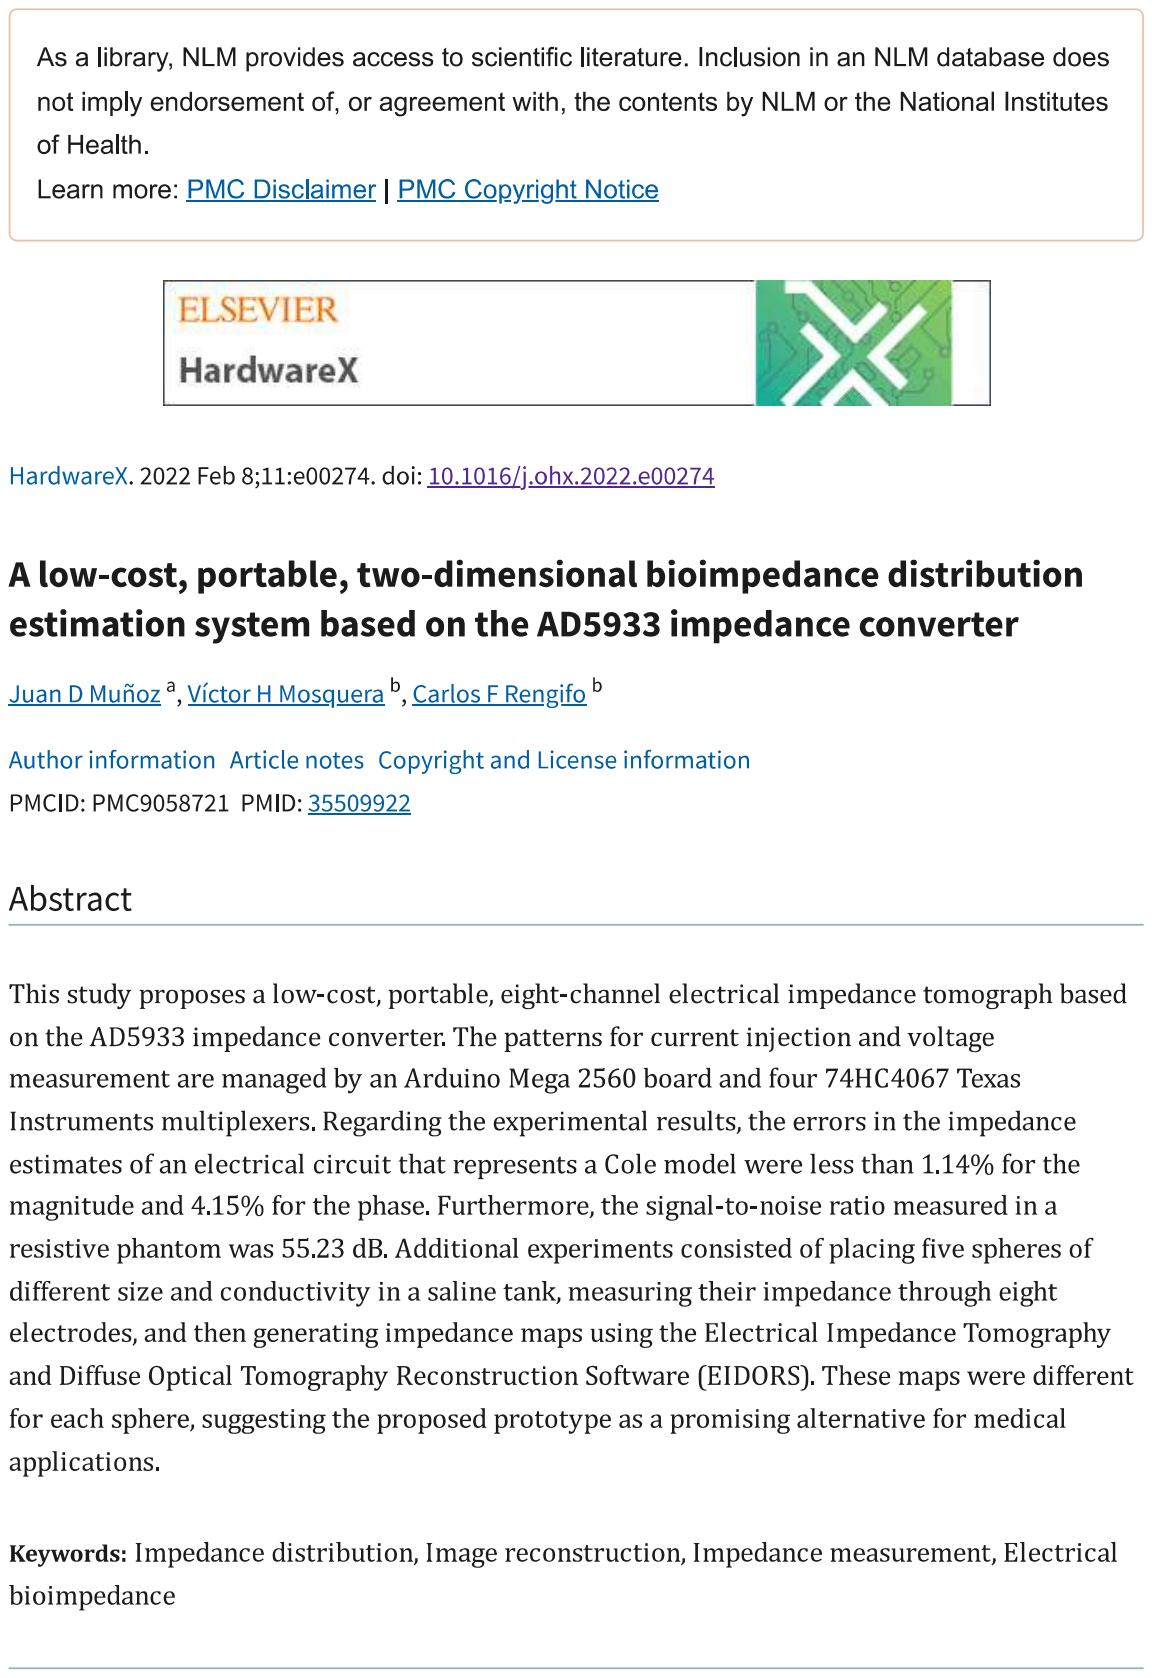
[picture p65: page 1]

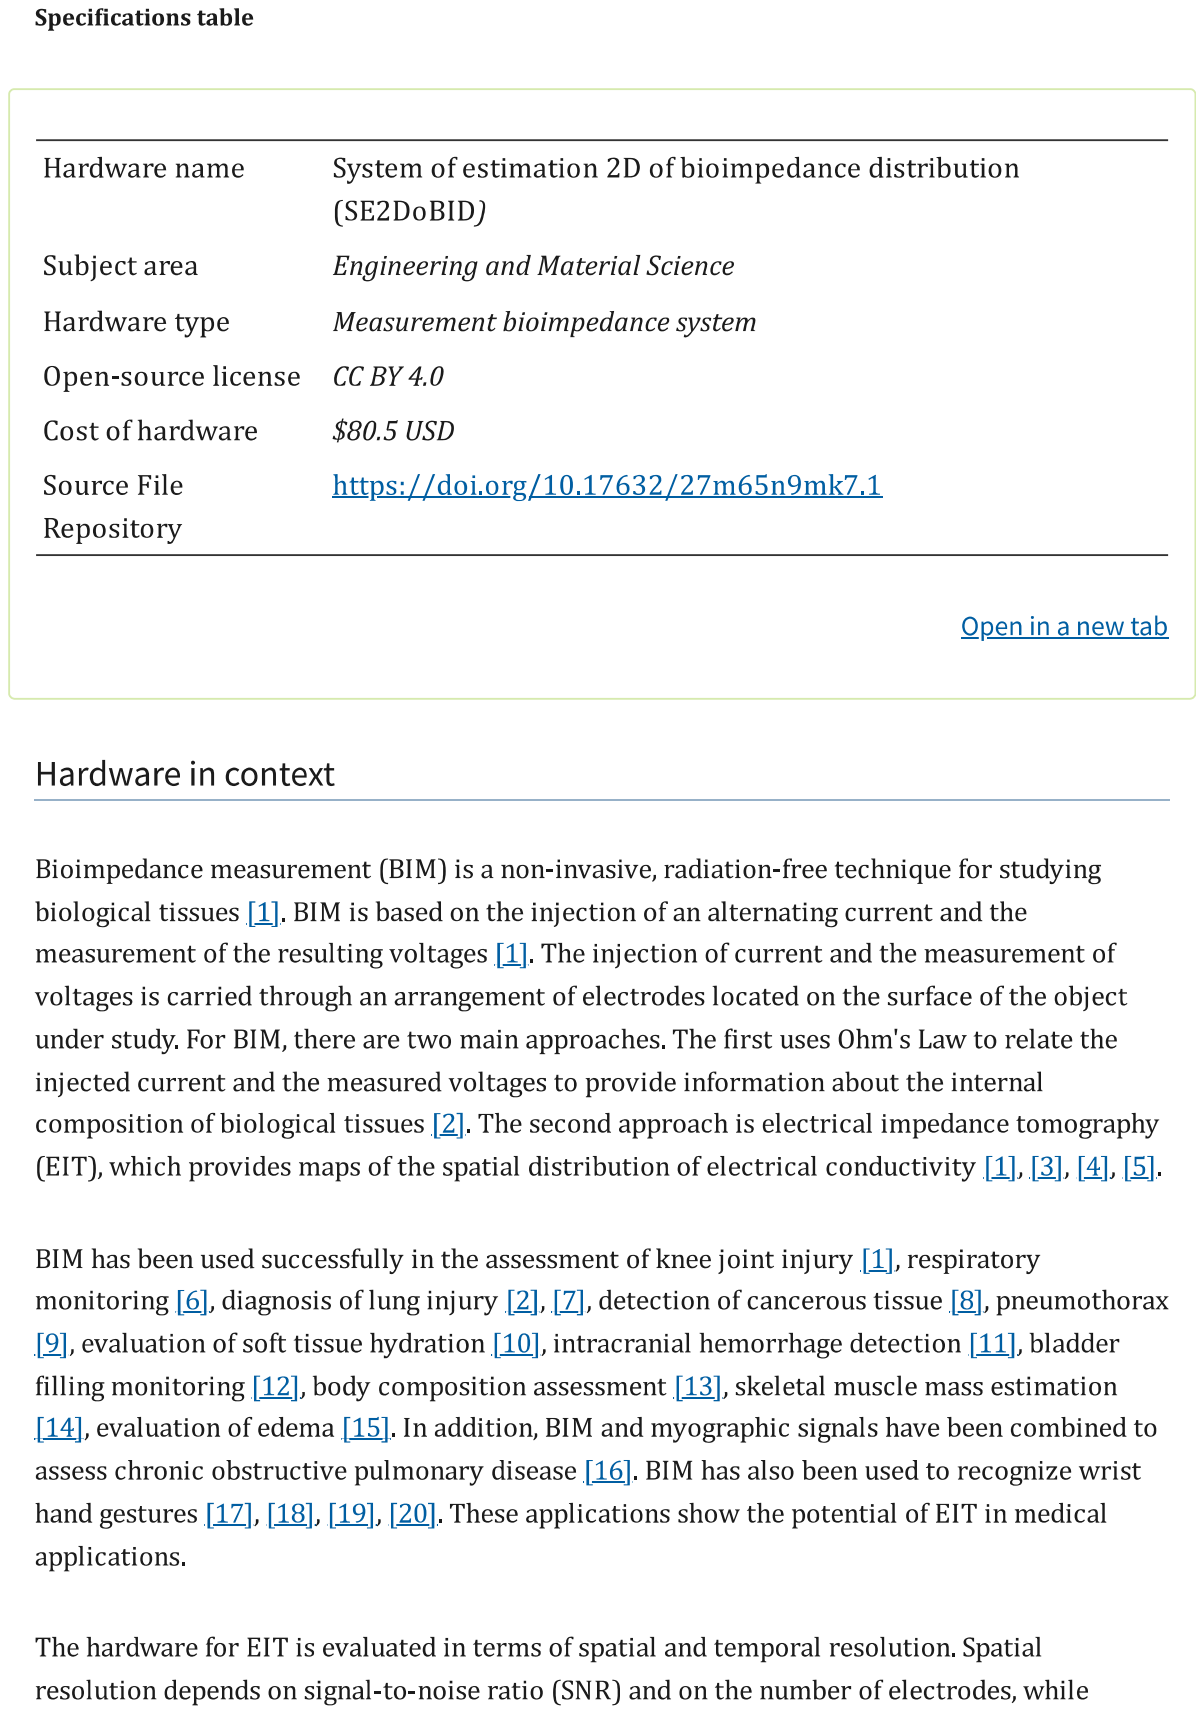
[picture p66: page 2]

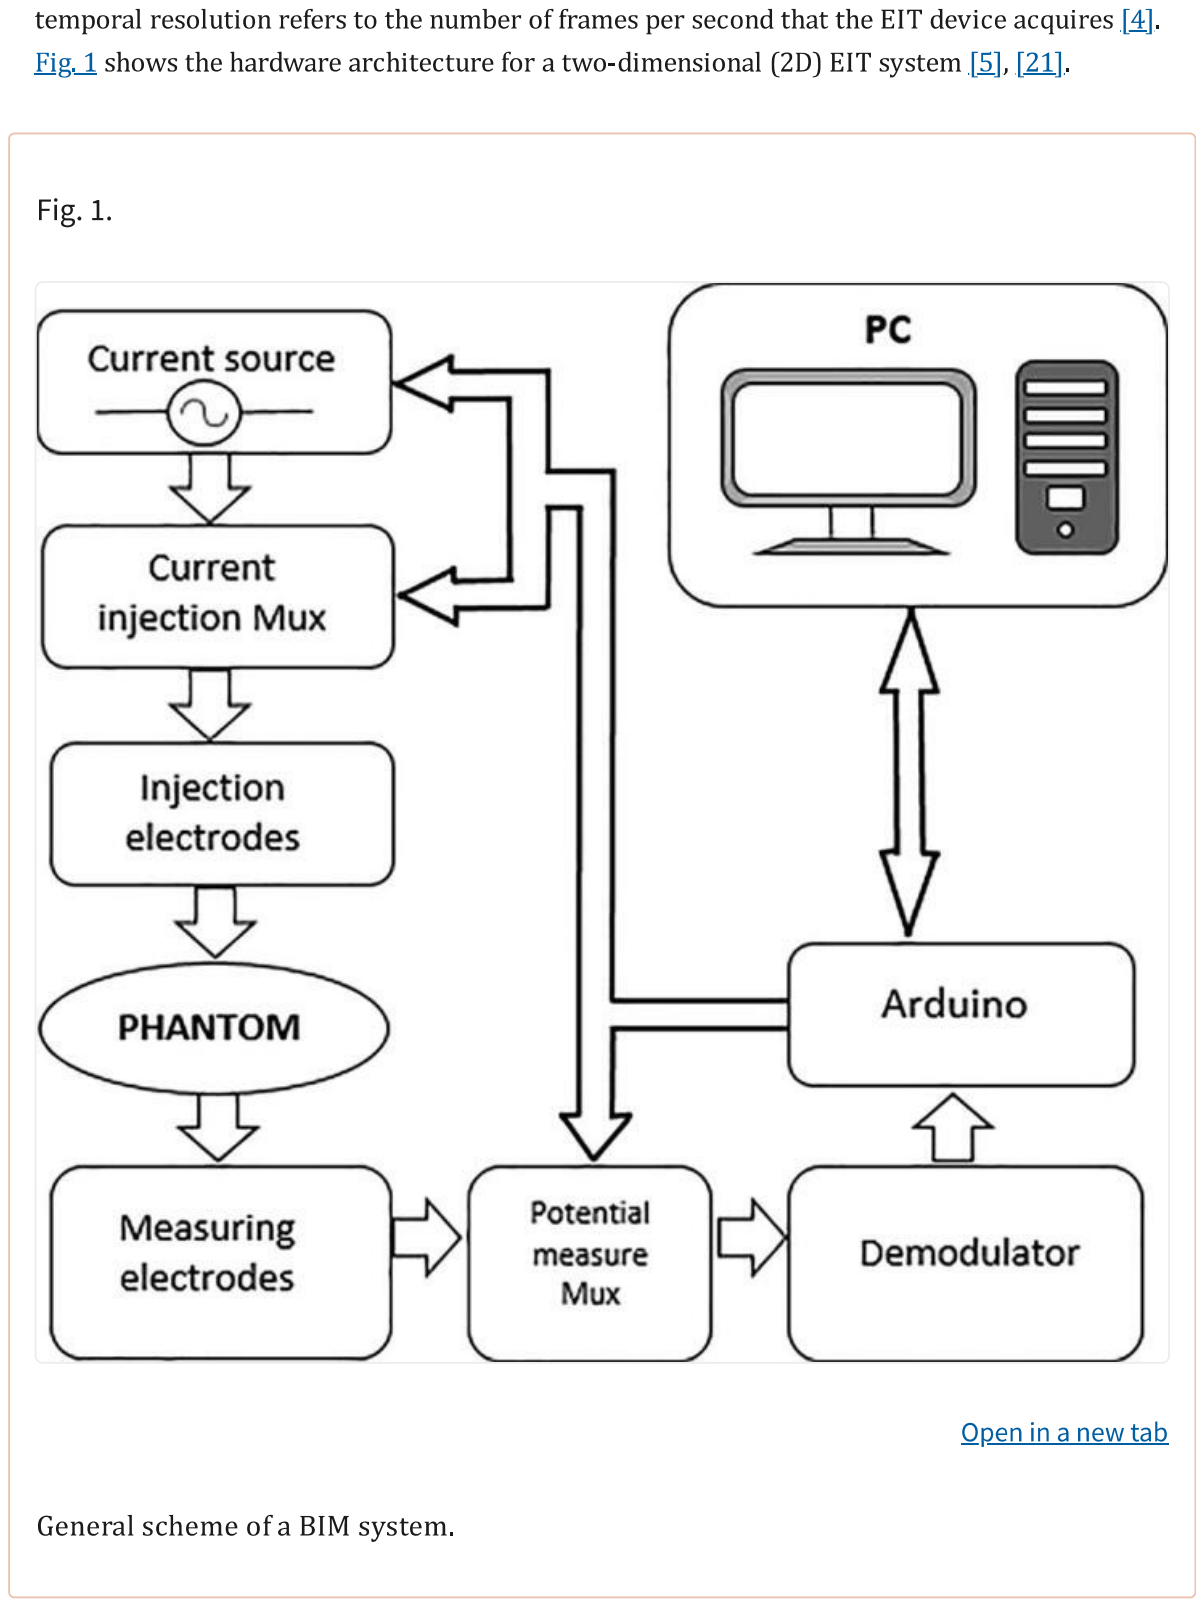
[picture p67: page 3]

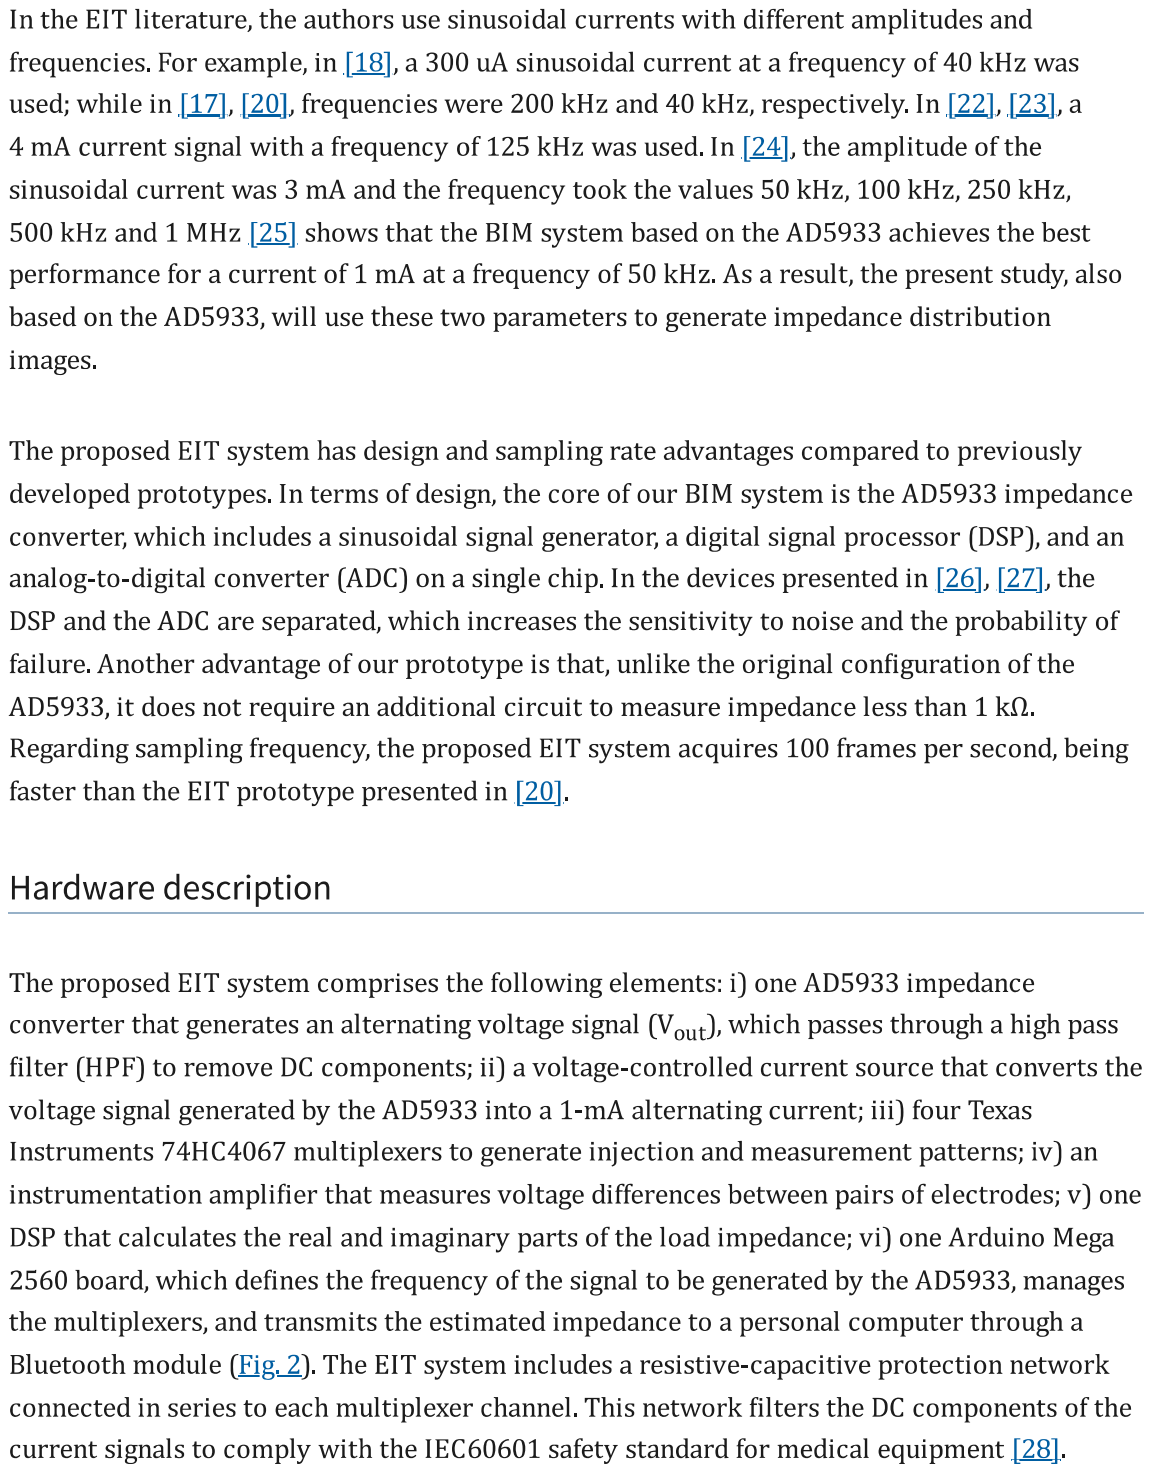
[picture p68: page 4]

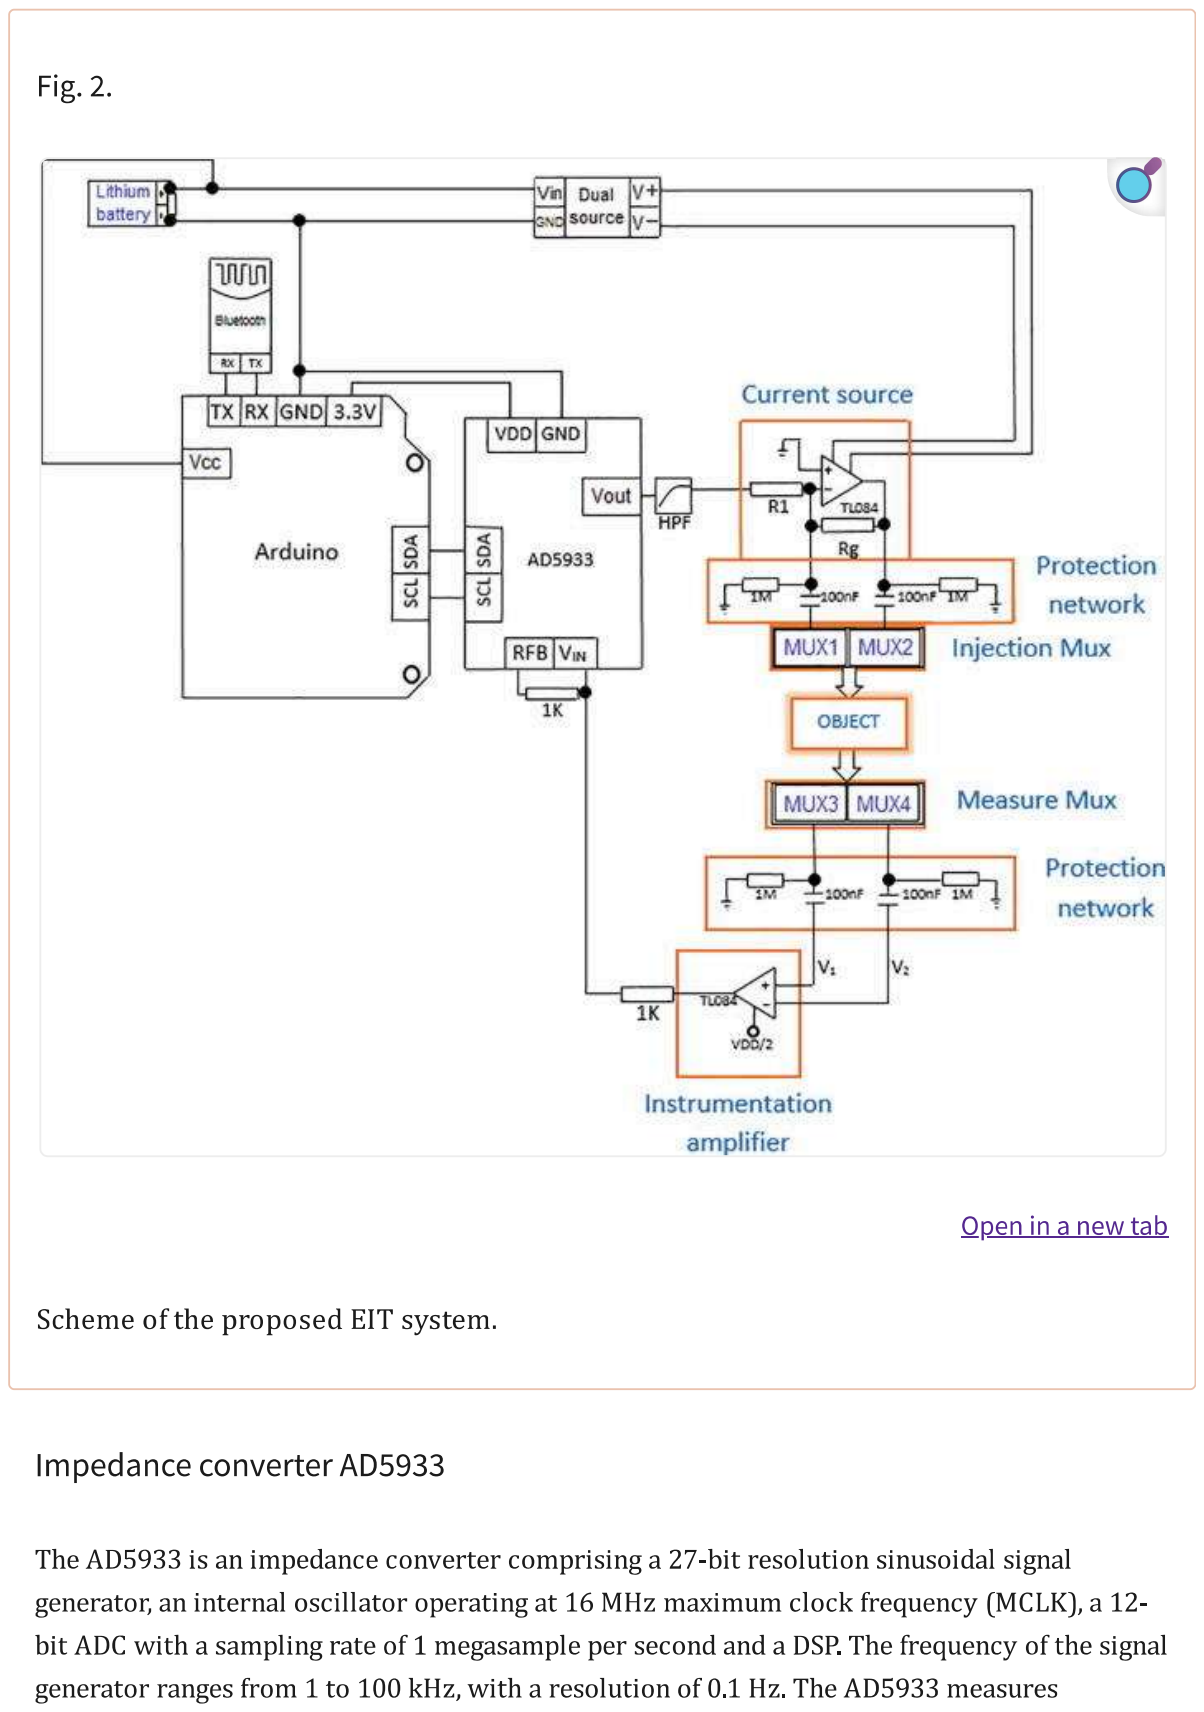
[picture p69: page 5]

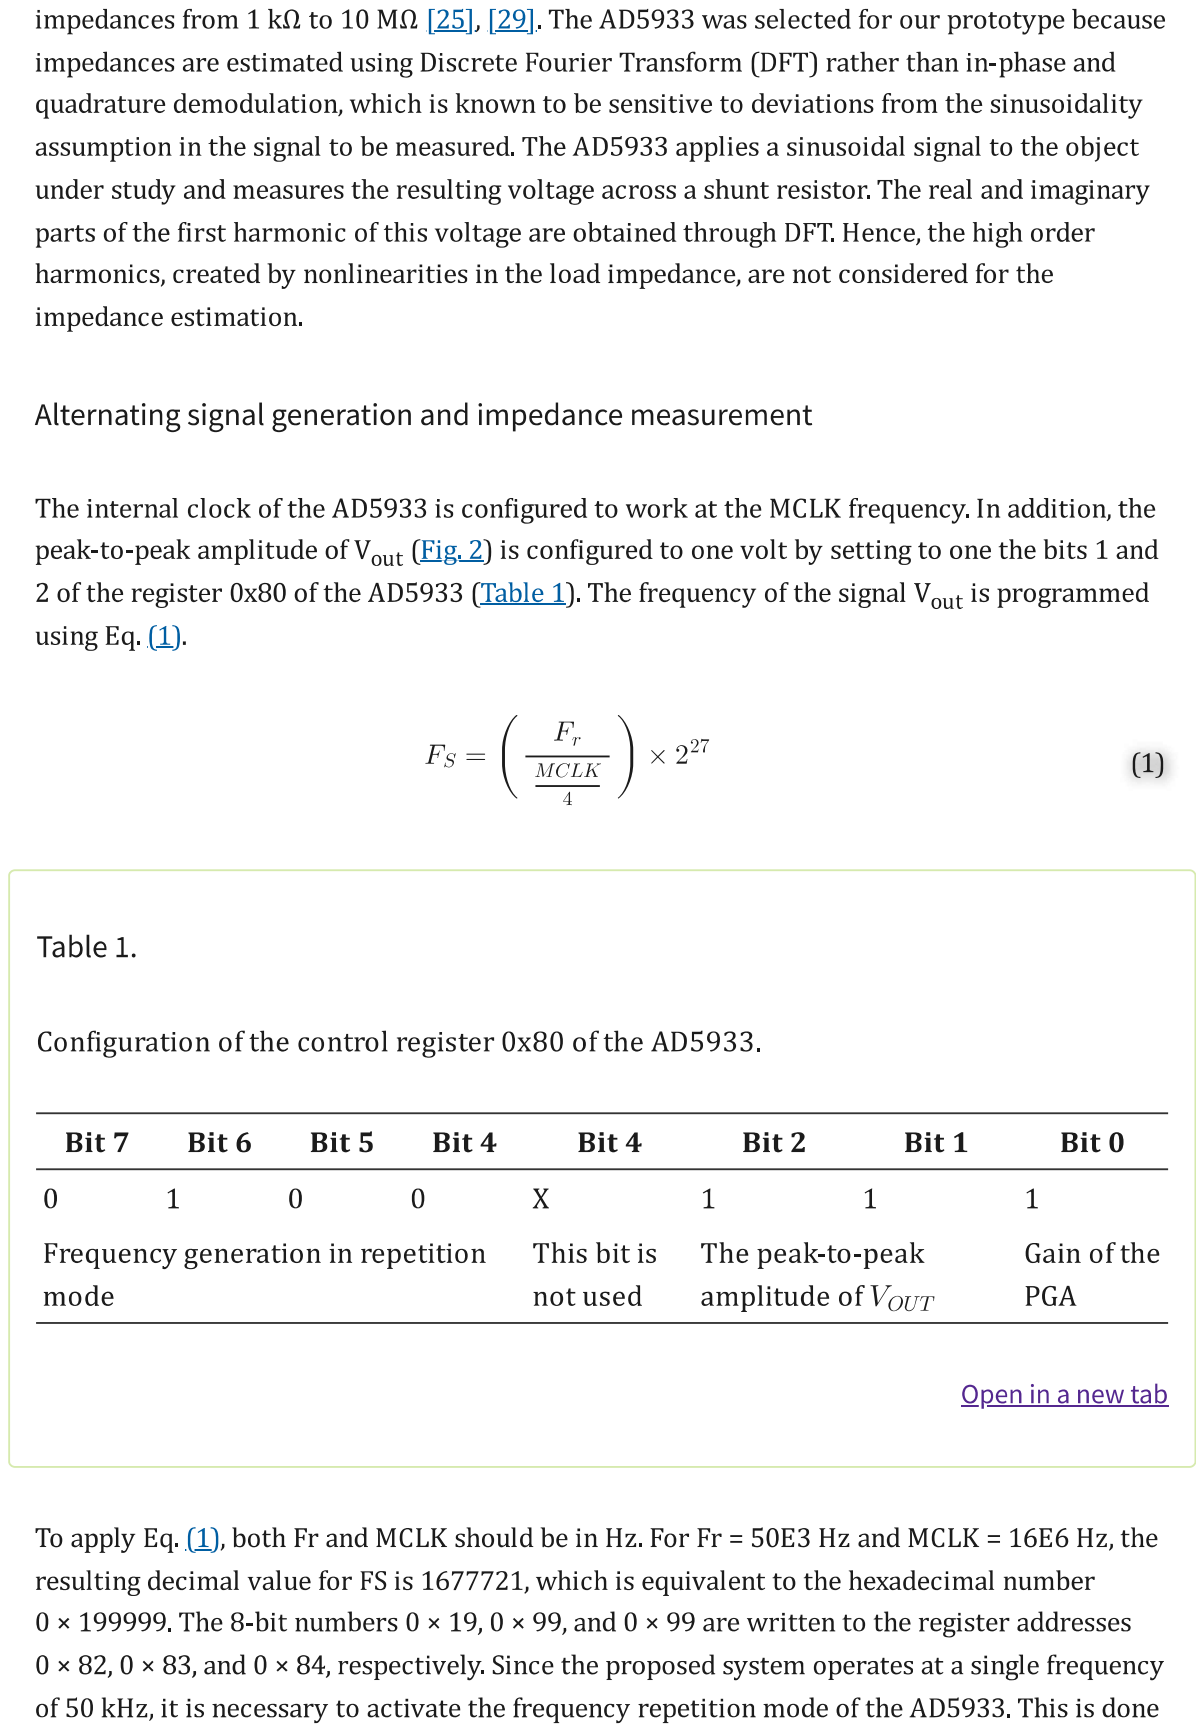
[picture p70: page 6]

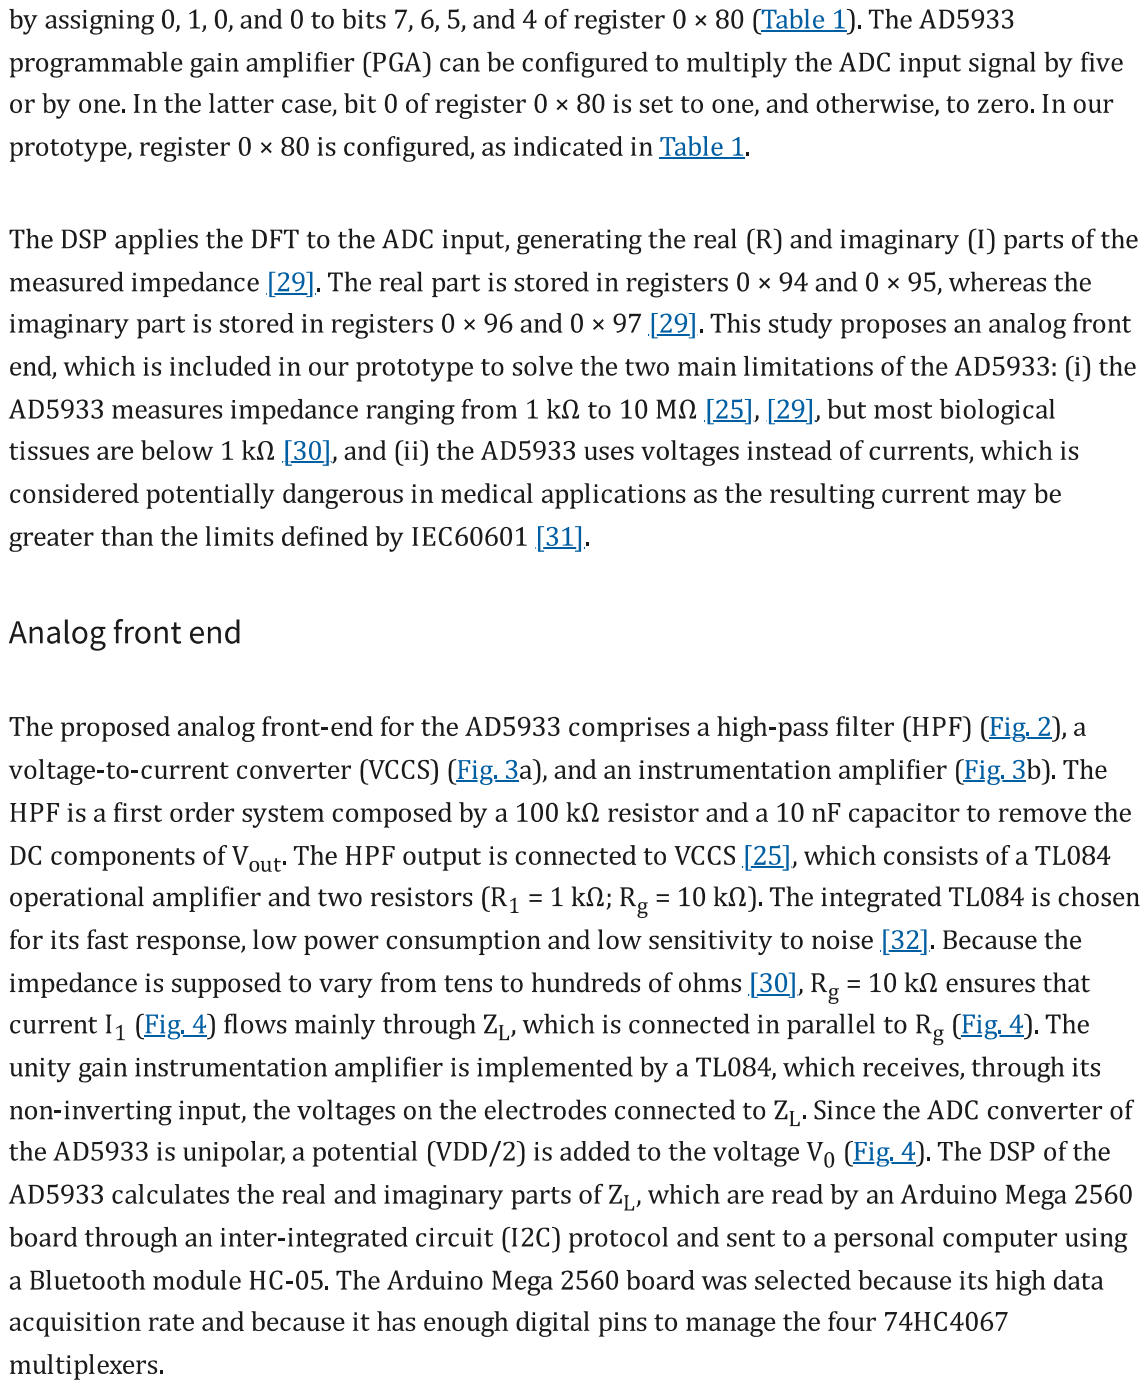
[picture p71: page 7]

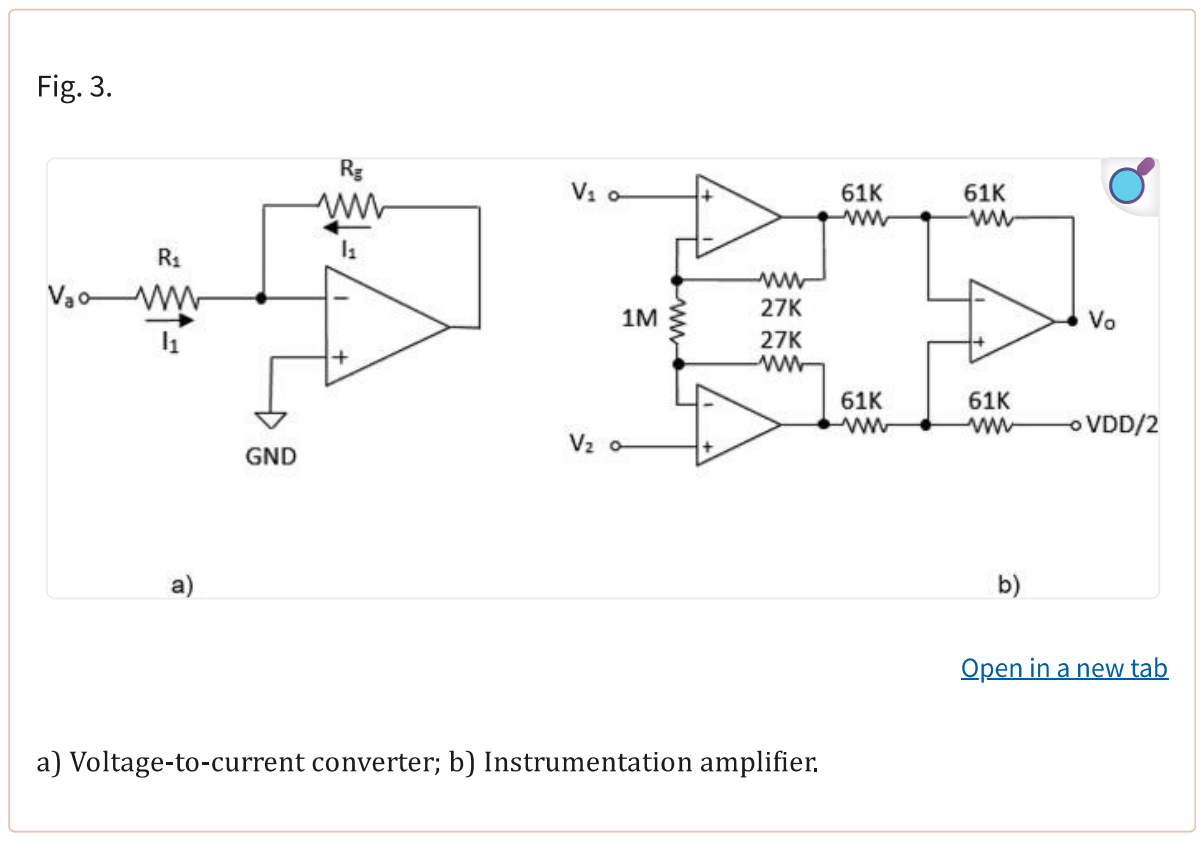
[picture p72: page 8]

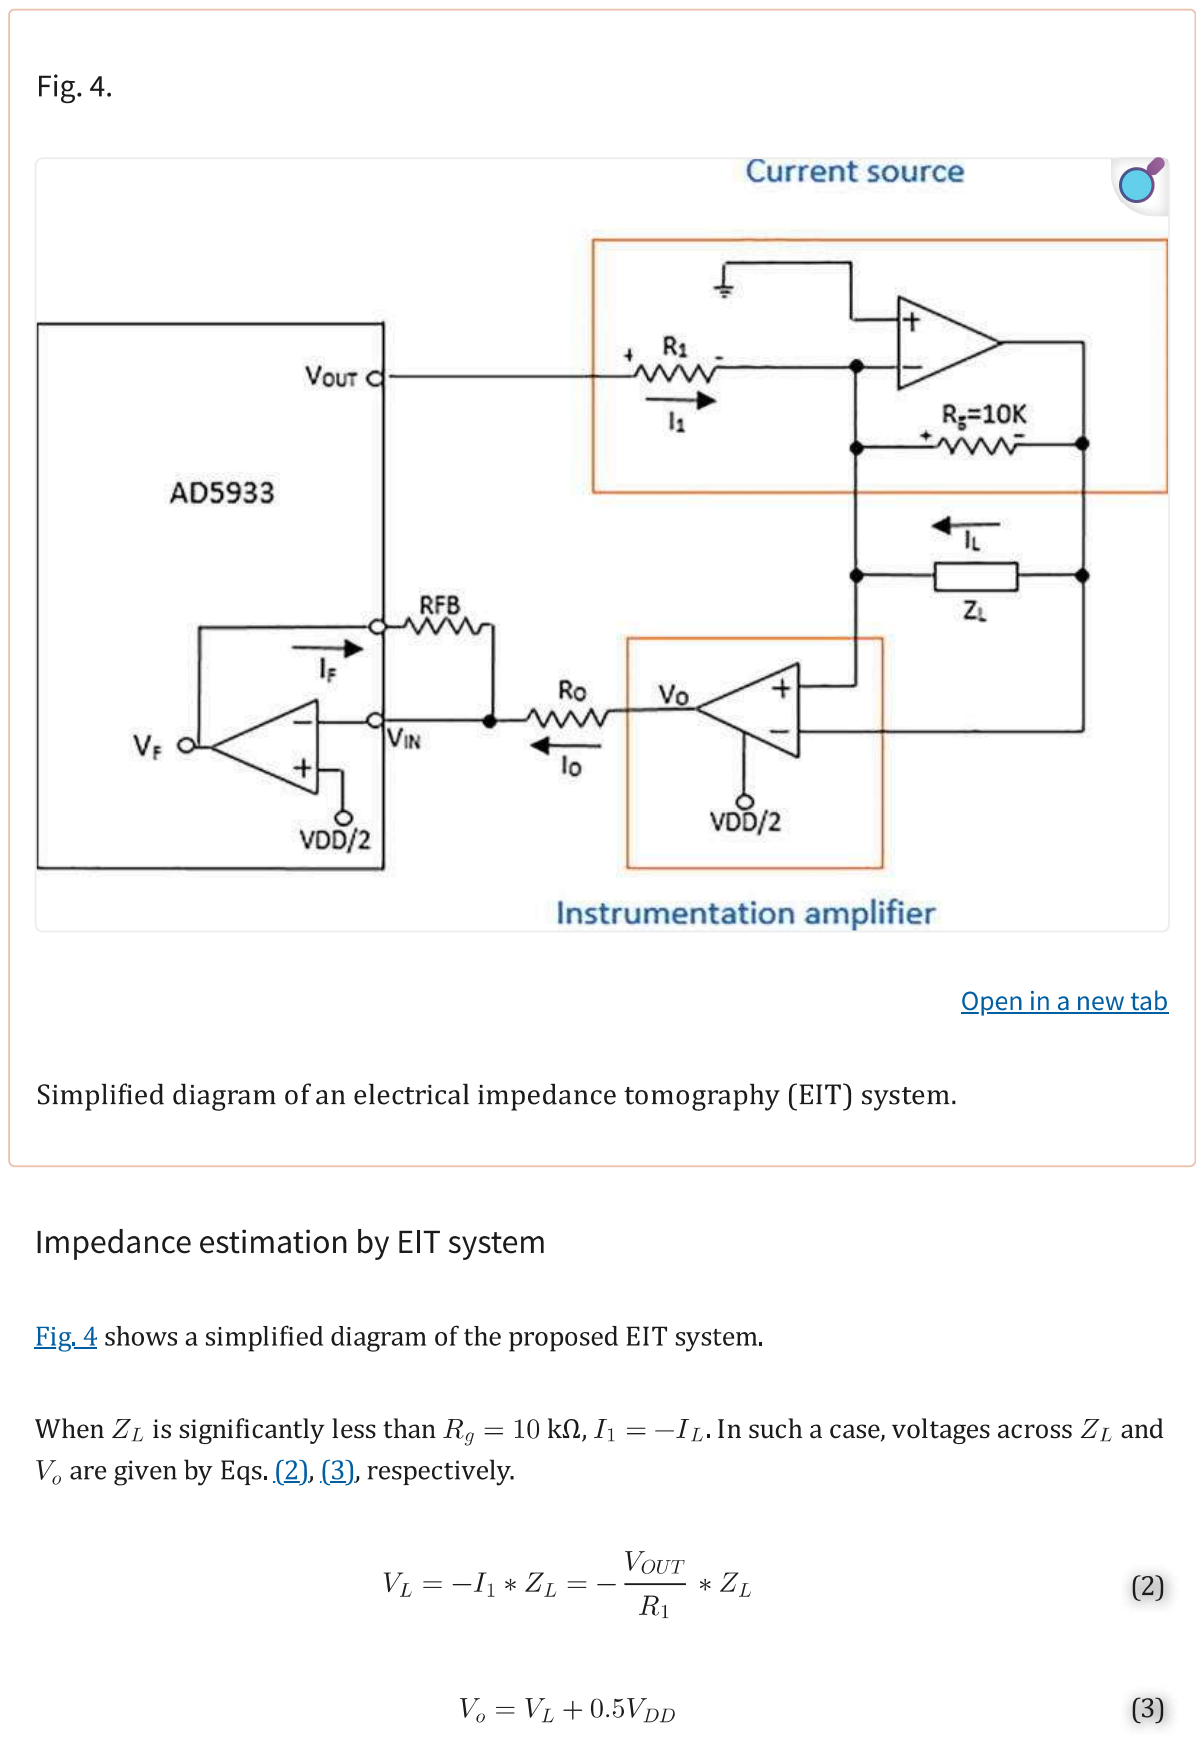
[picture p73: page 9]

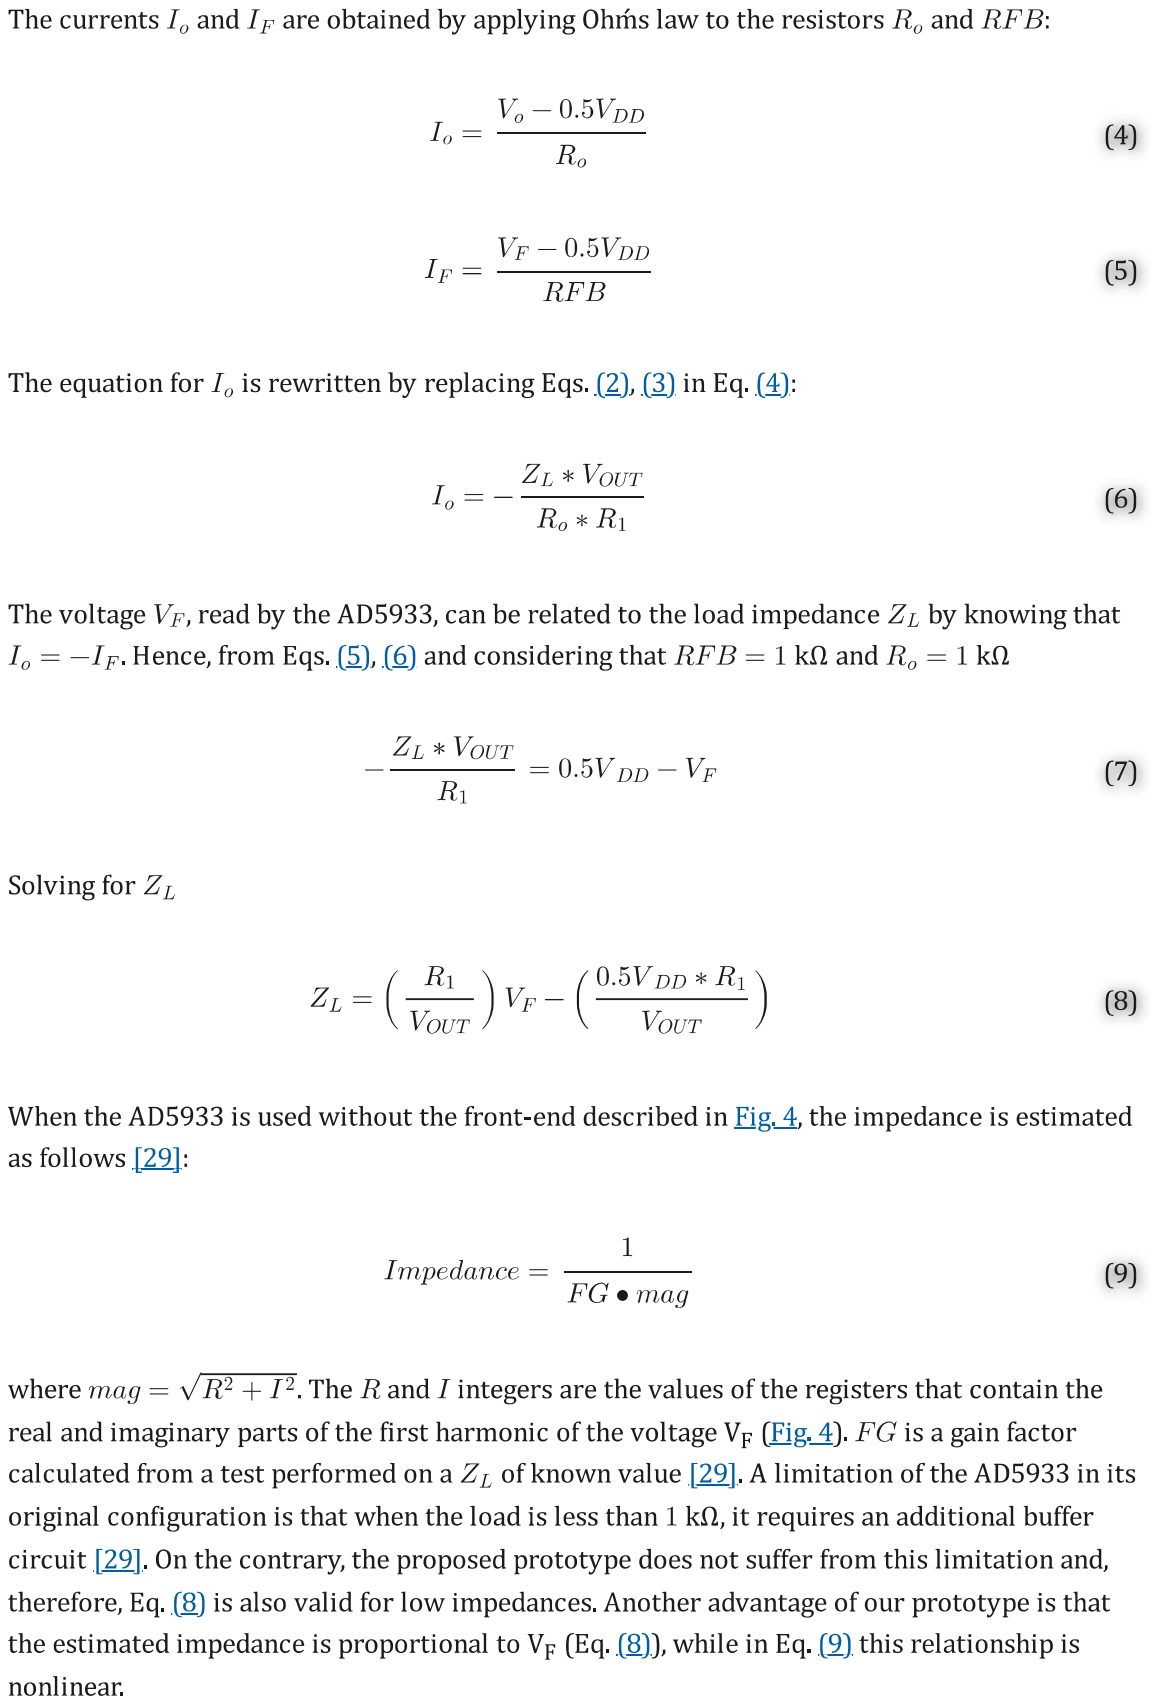
[picture p74: page 10]

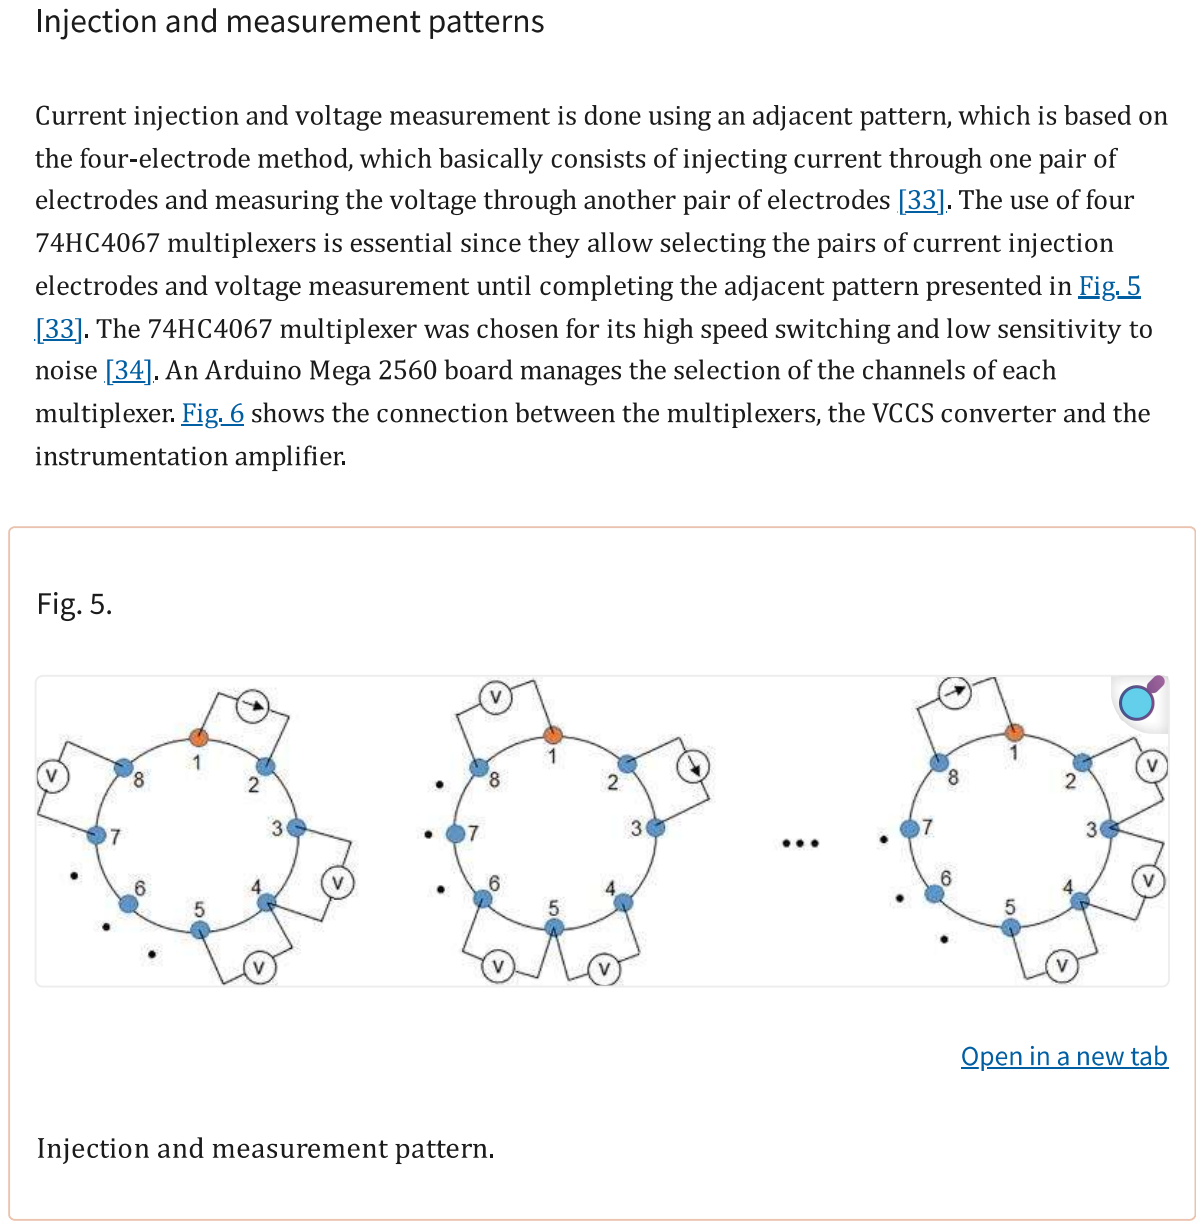
[picture p75: page 11]

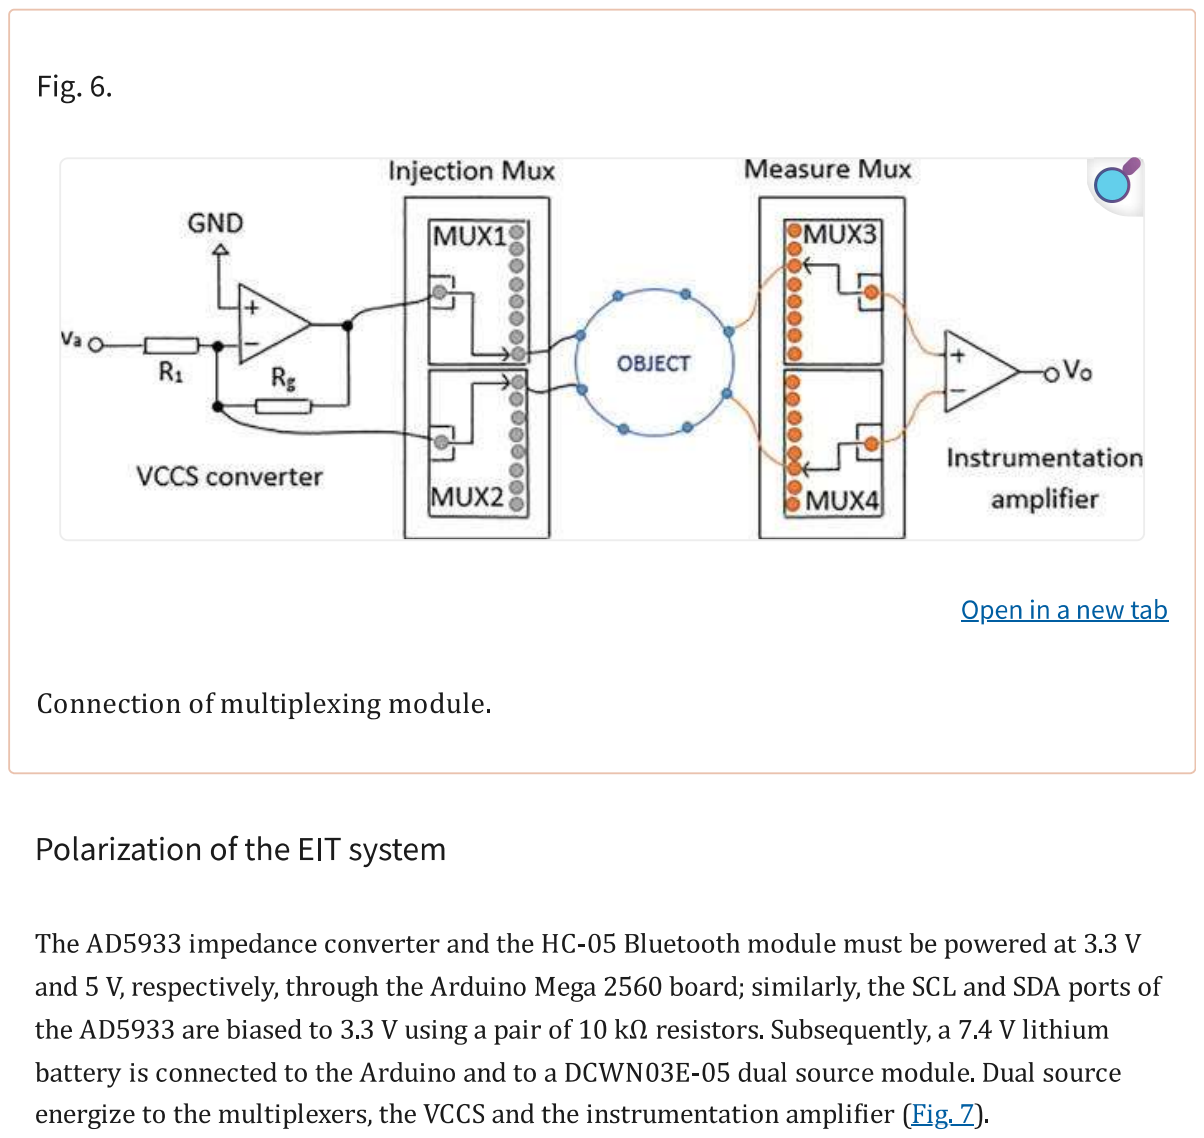
[picture p76: page 12]

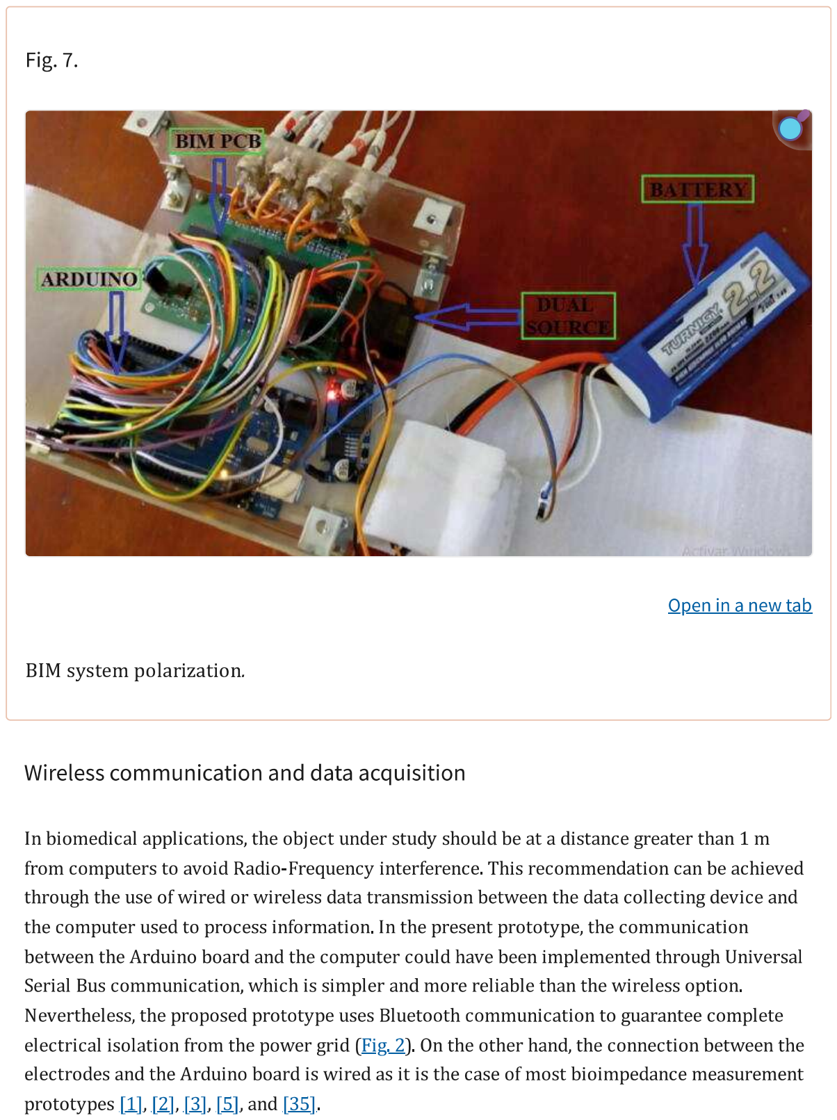
[picture p77: page 13]

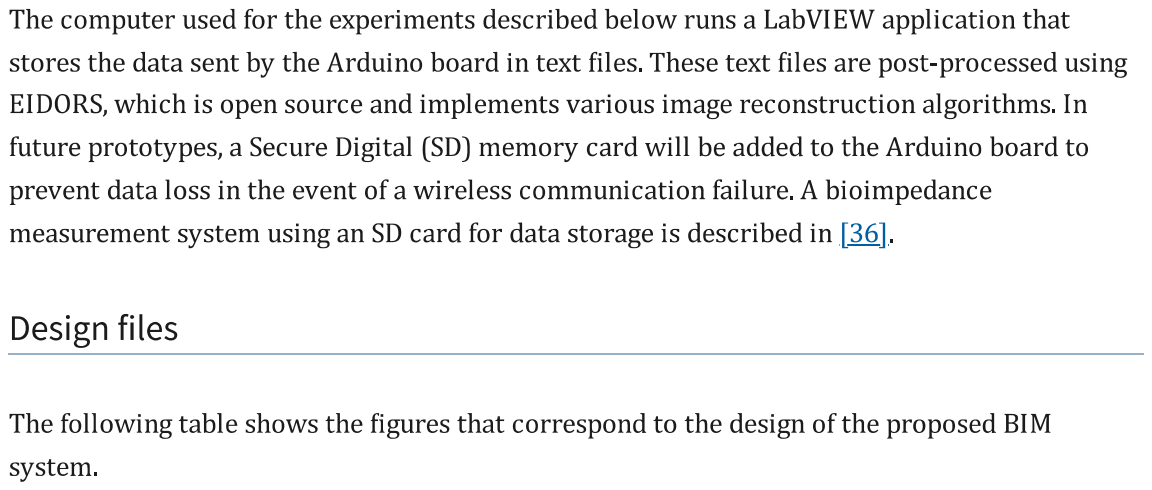
[picture p78: page 14]

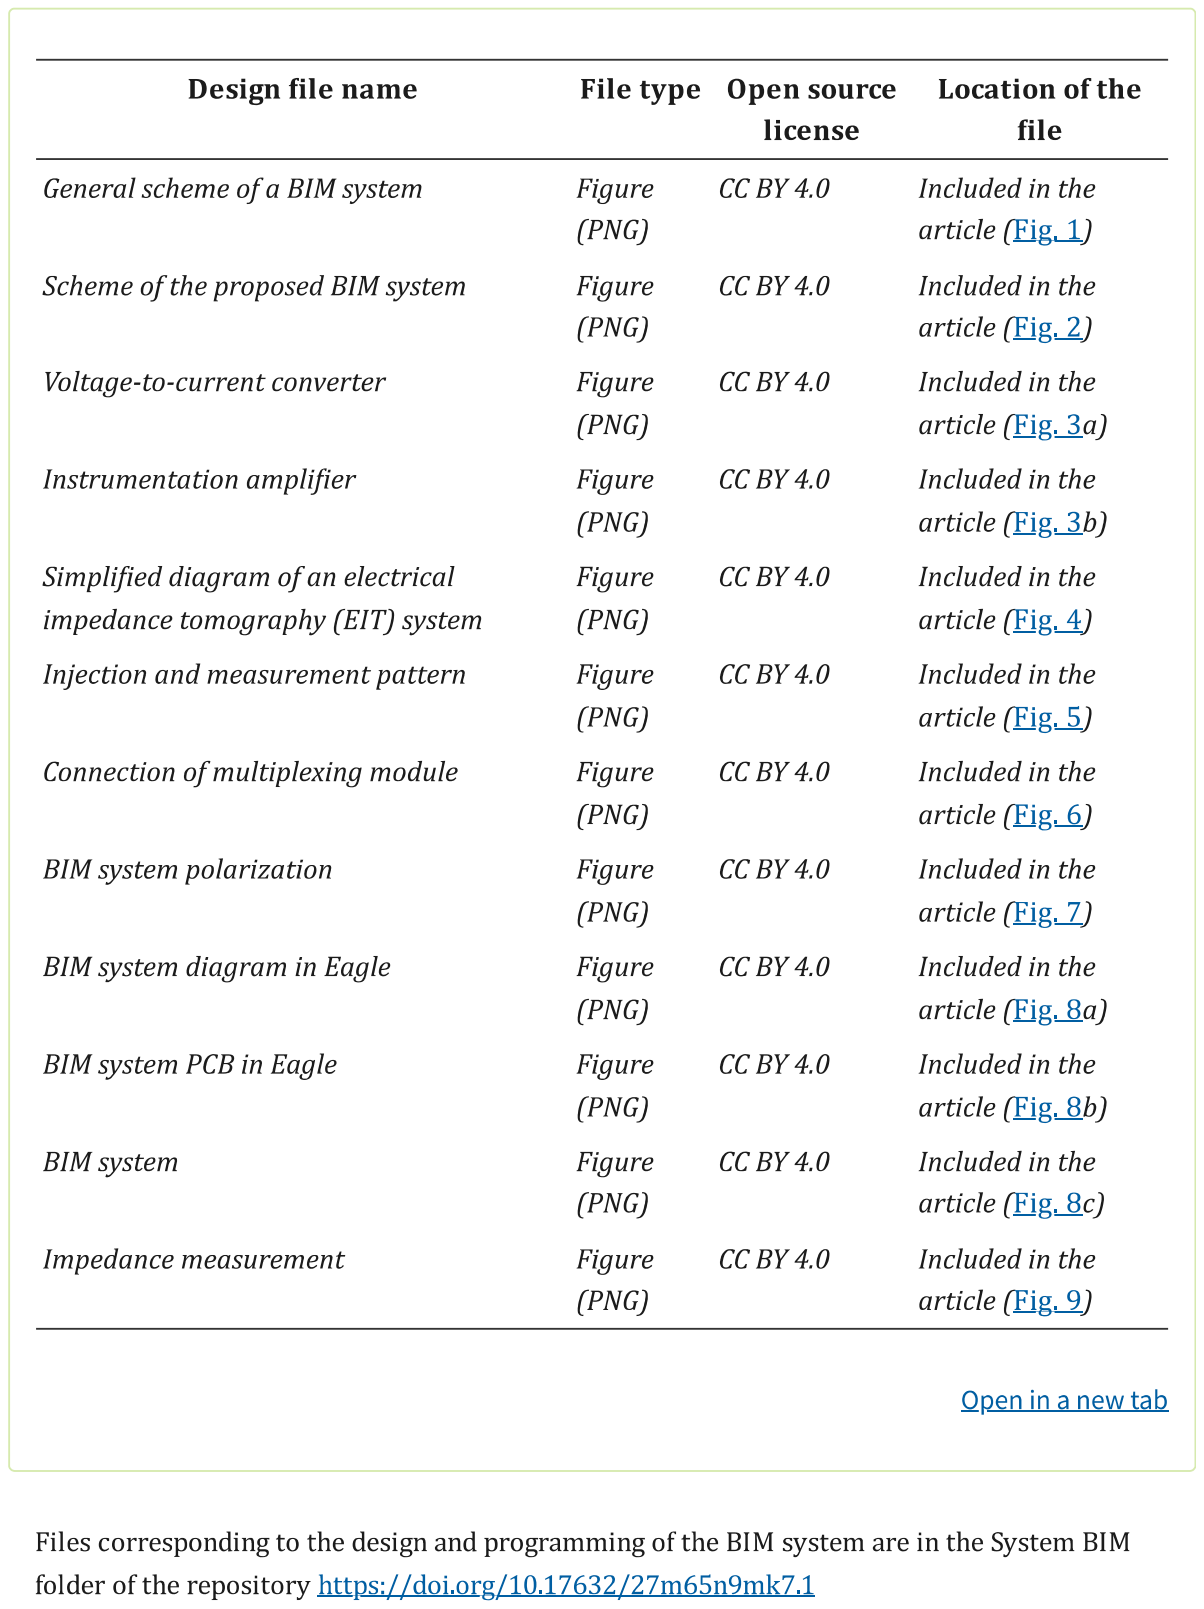
[picture p79: page 15]

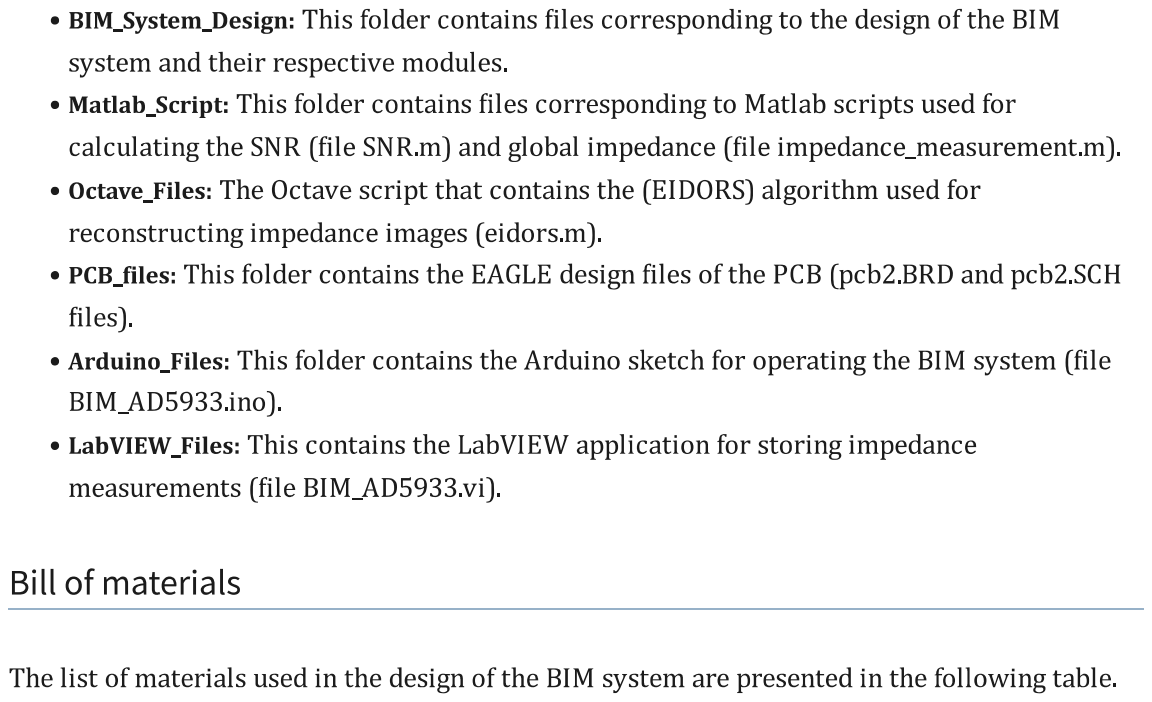
[picture p80: page 16]

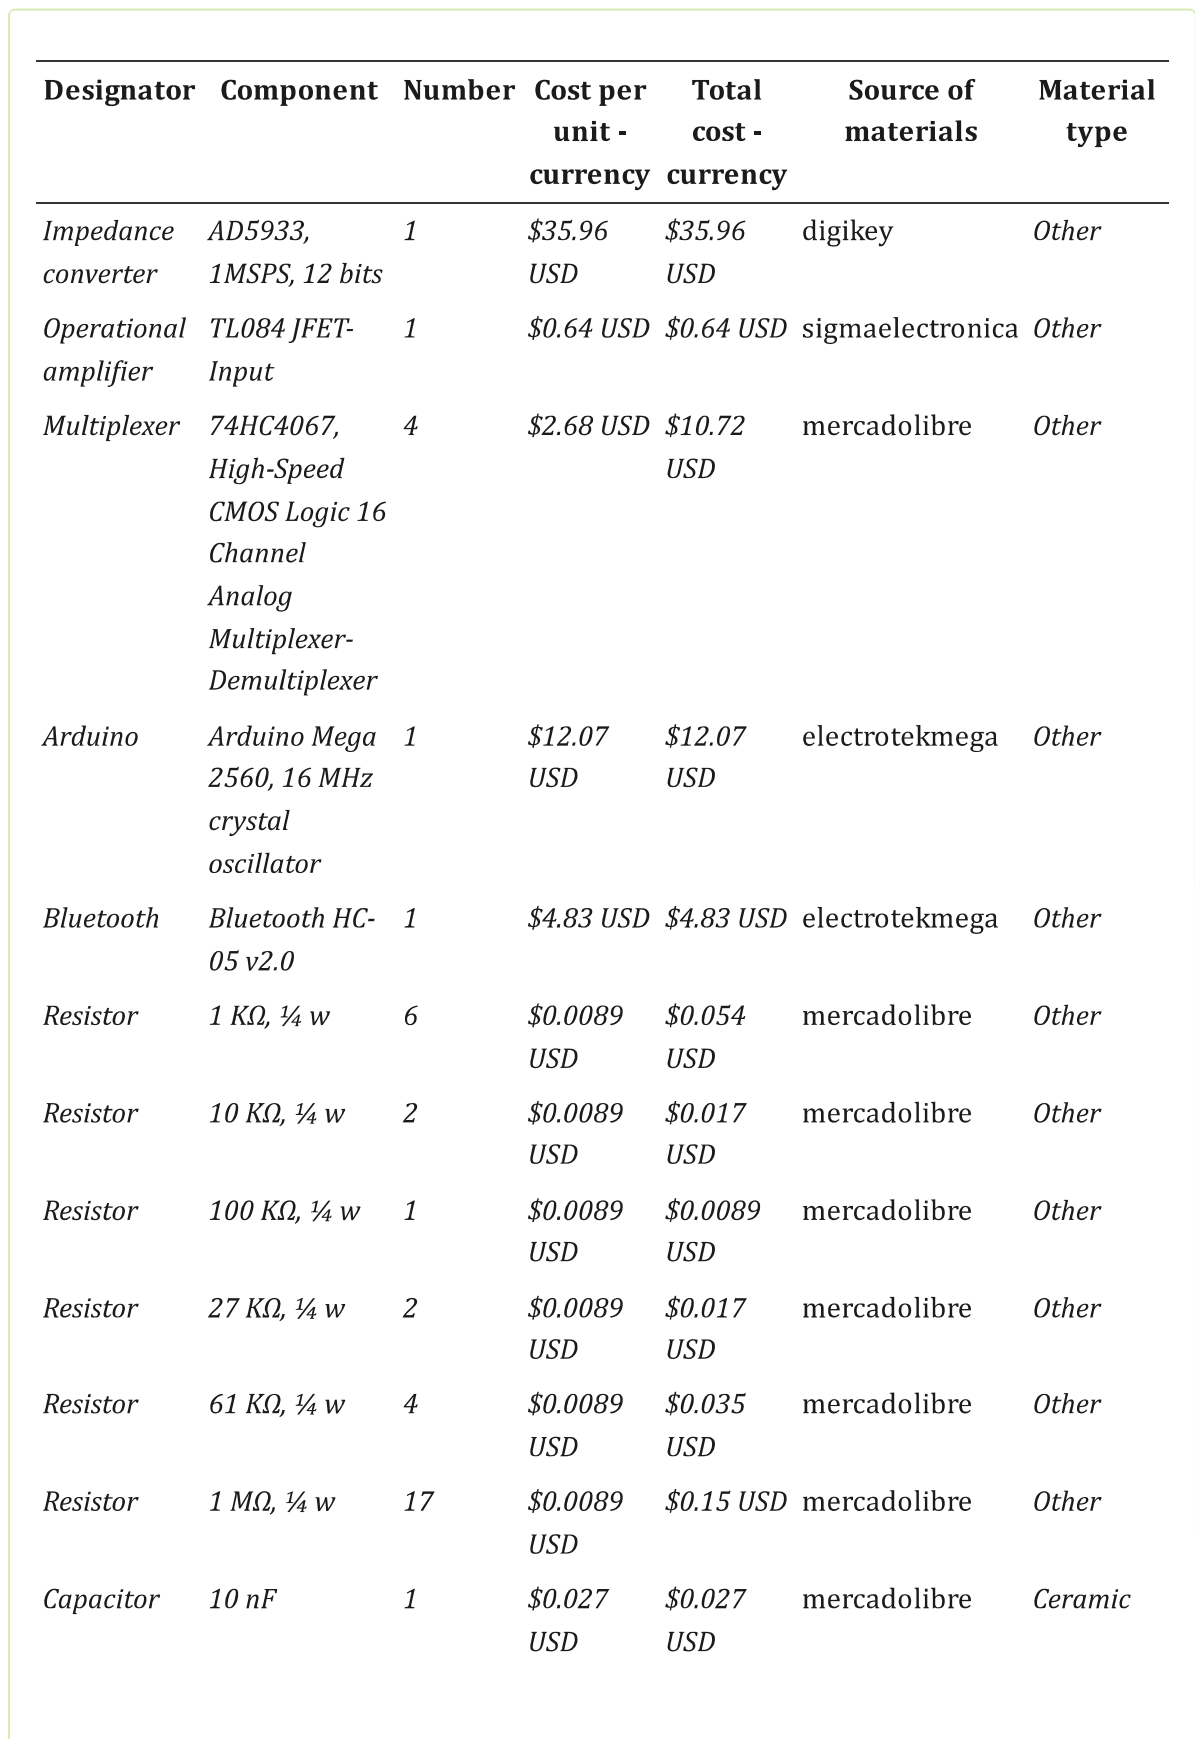
[picture p81: page 17]

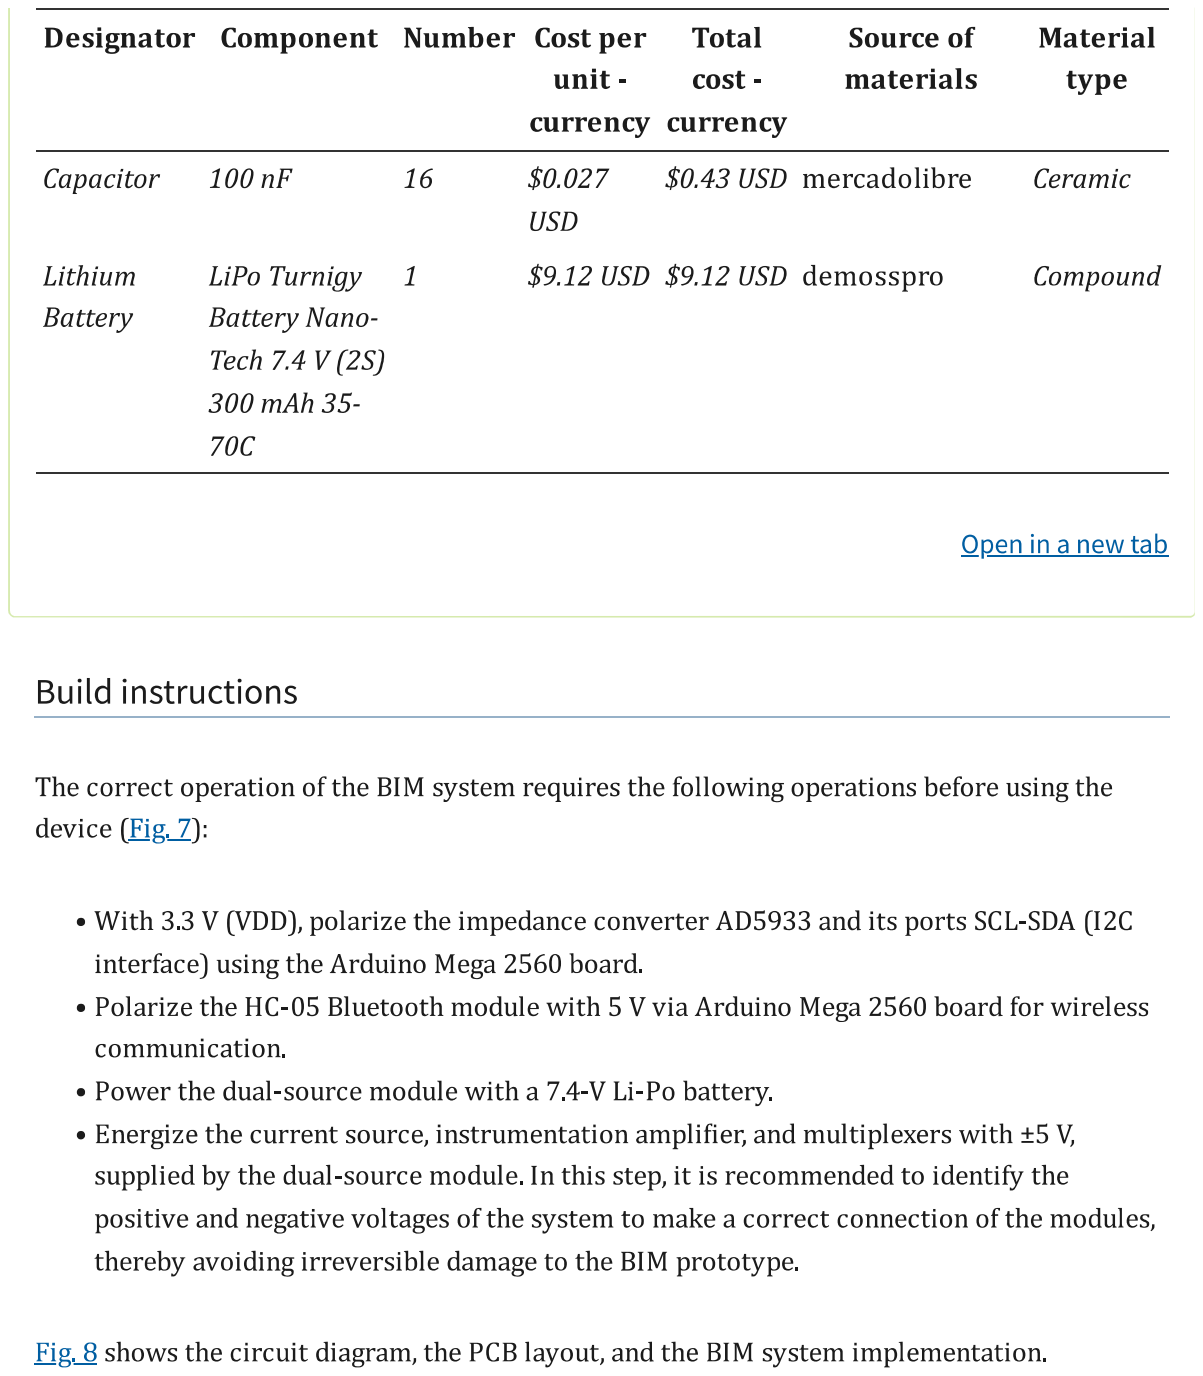
[picture p82: page 18]

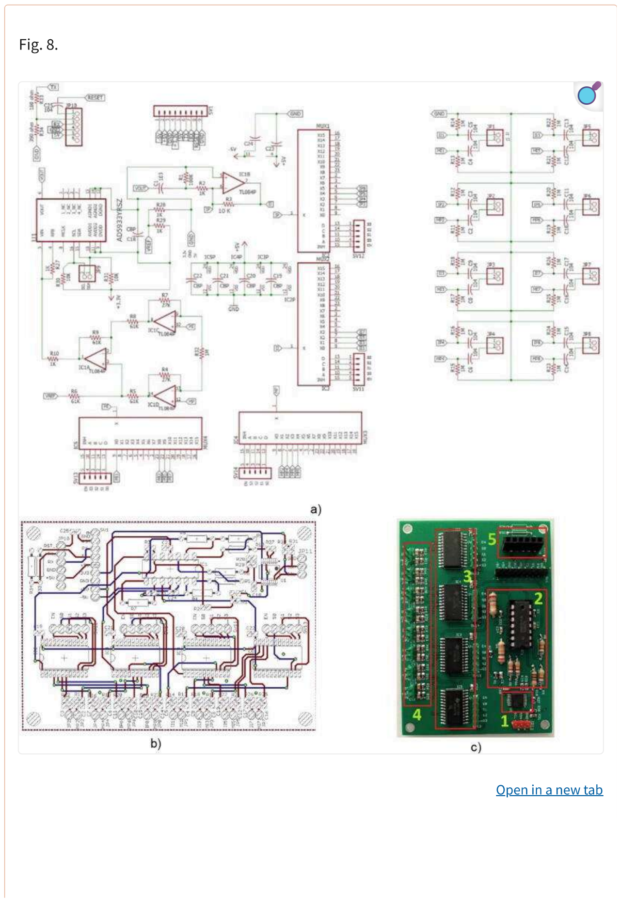
[picture p83: page 19]

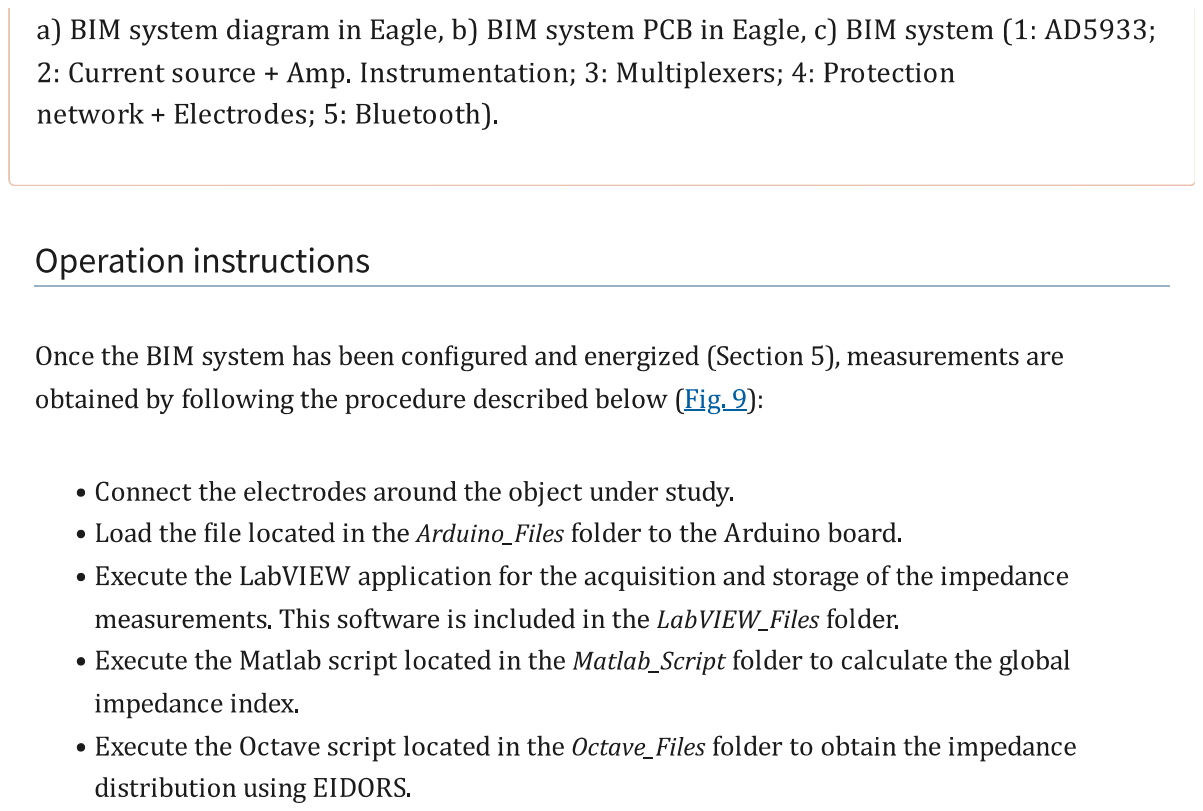
[picture p84: page 20]

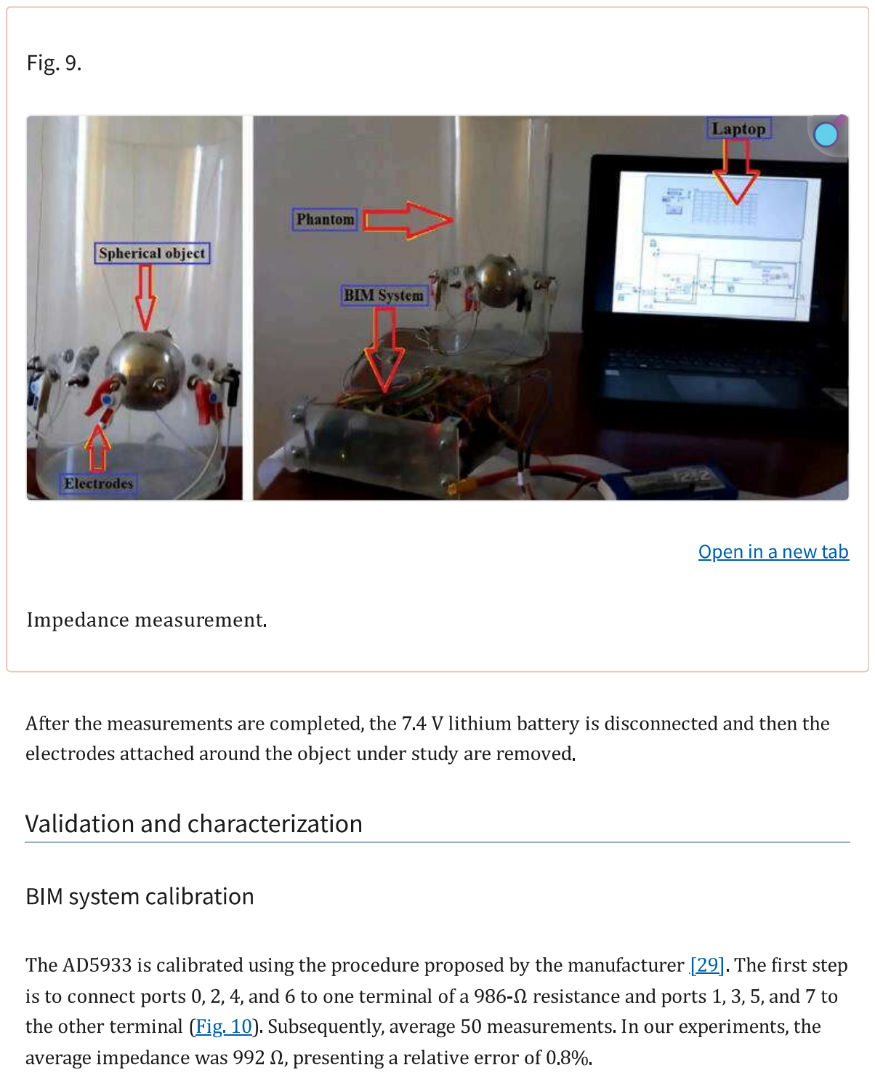
[picture p85: page 21]

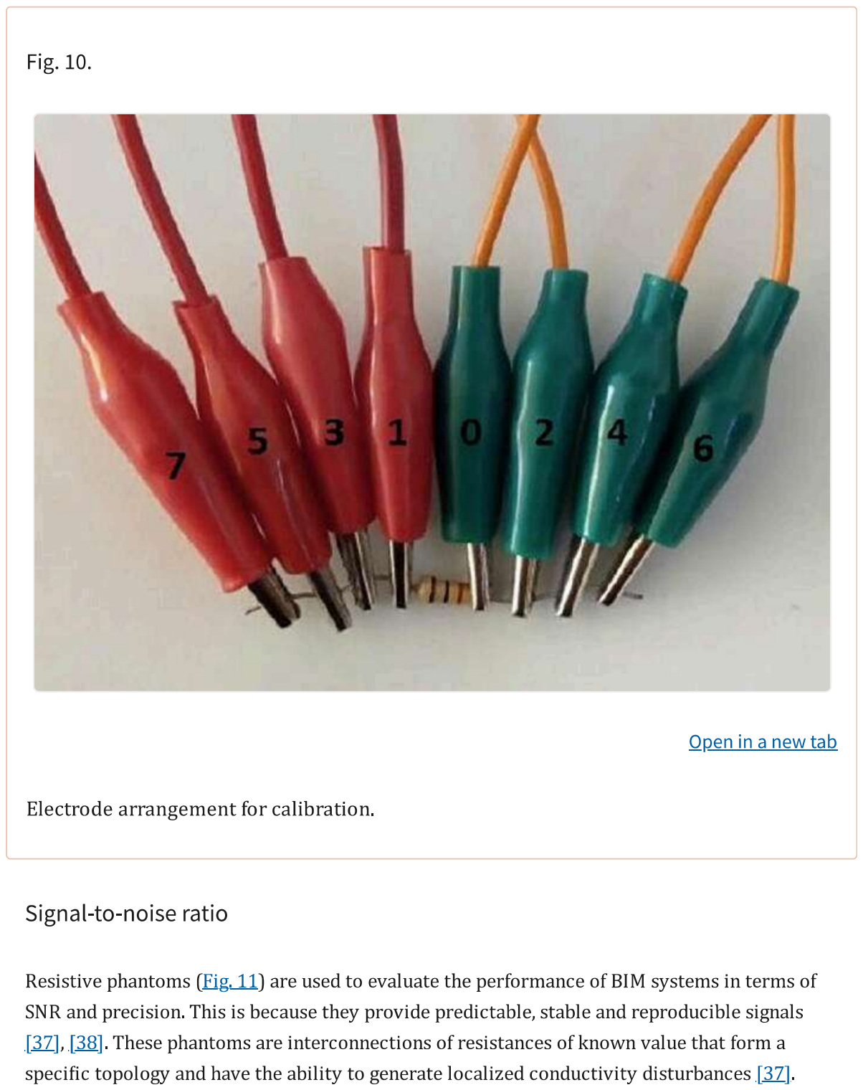
[picture p86: page 22]

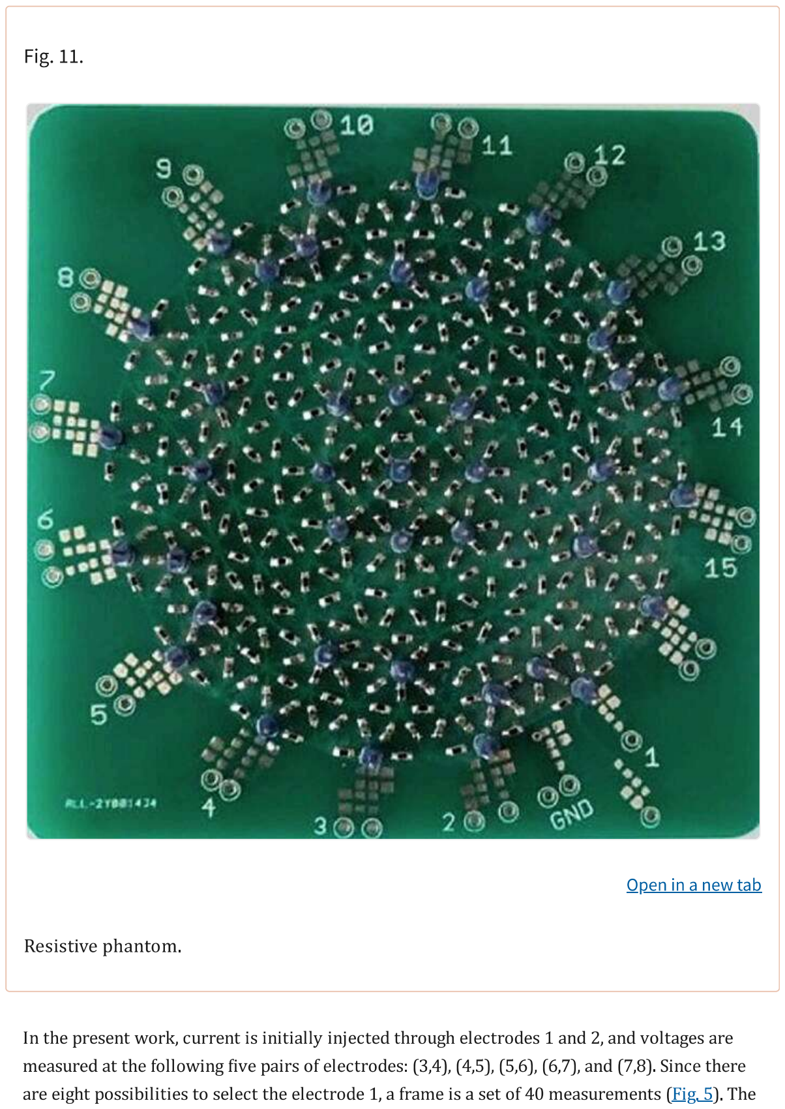
[picture p87: page 23]

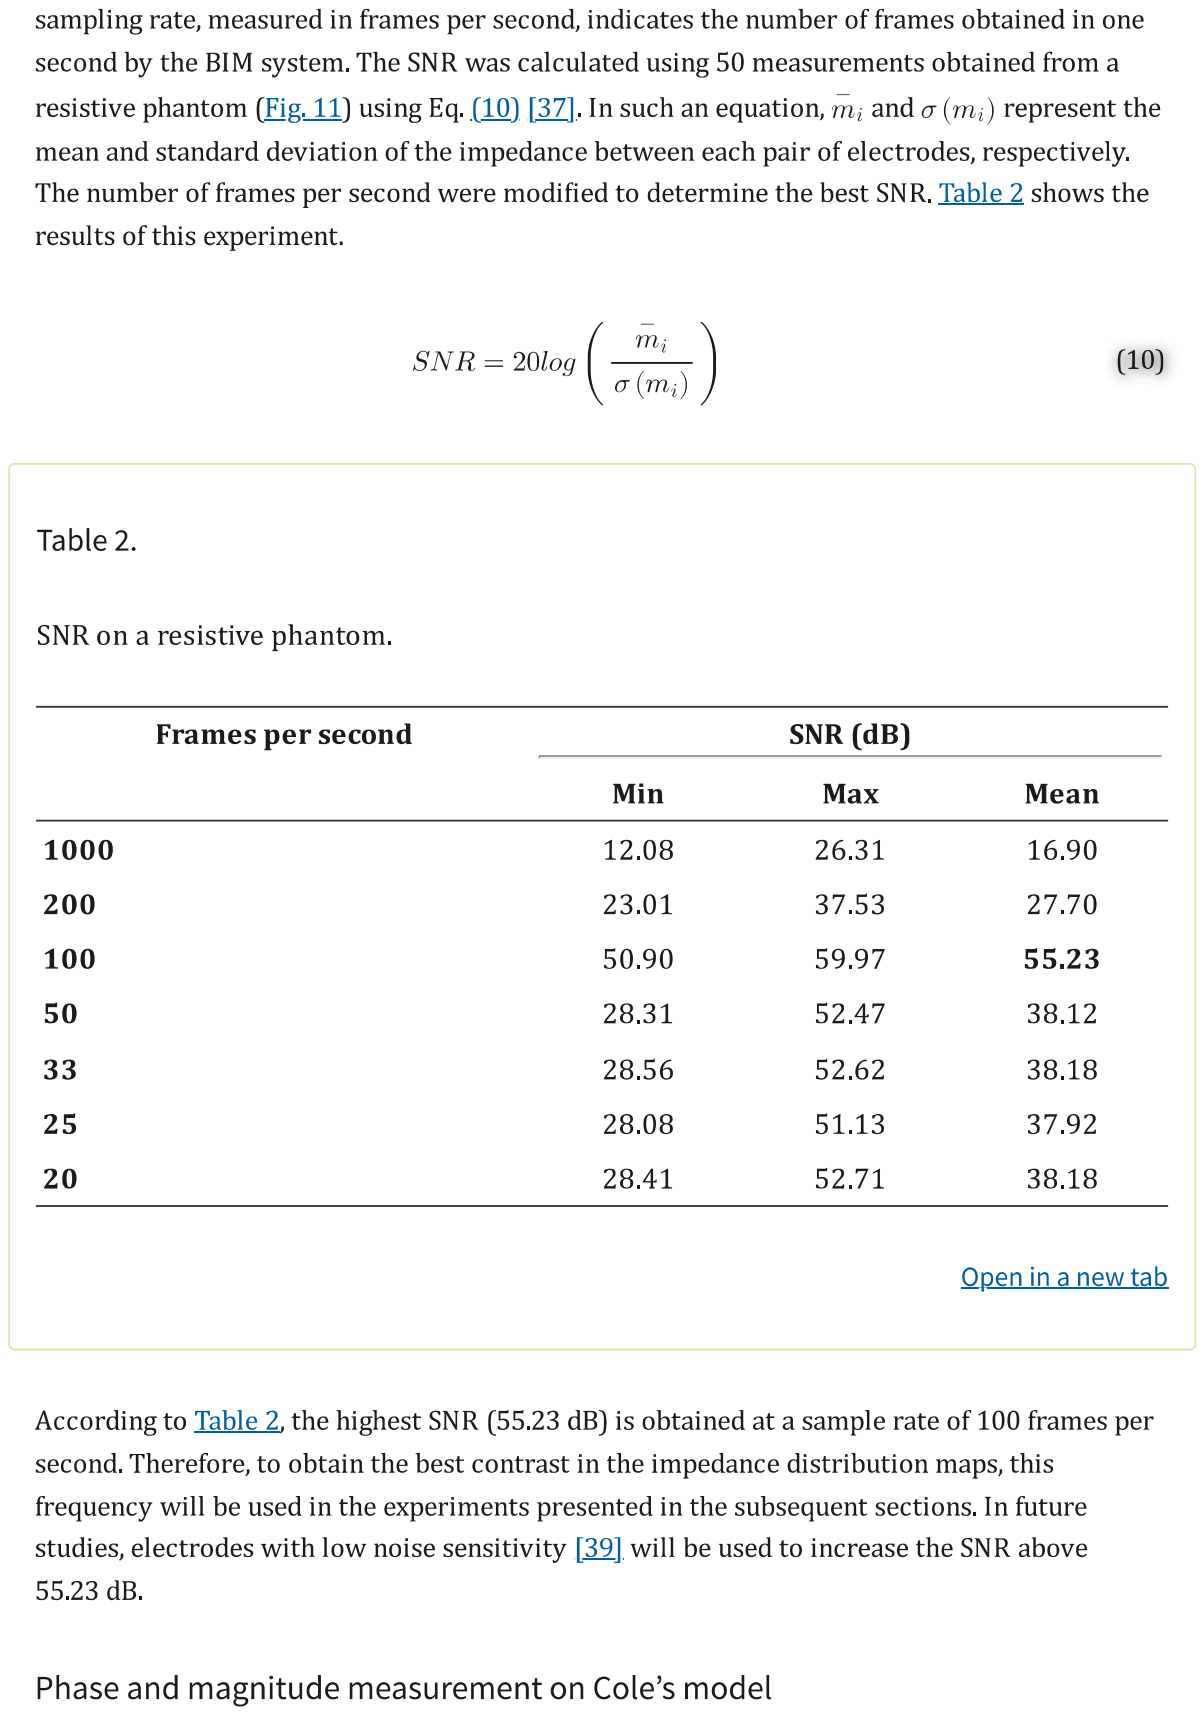
[picture p88: page 24]

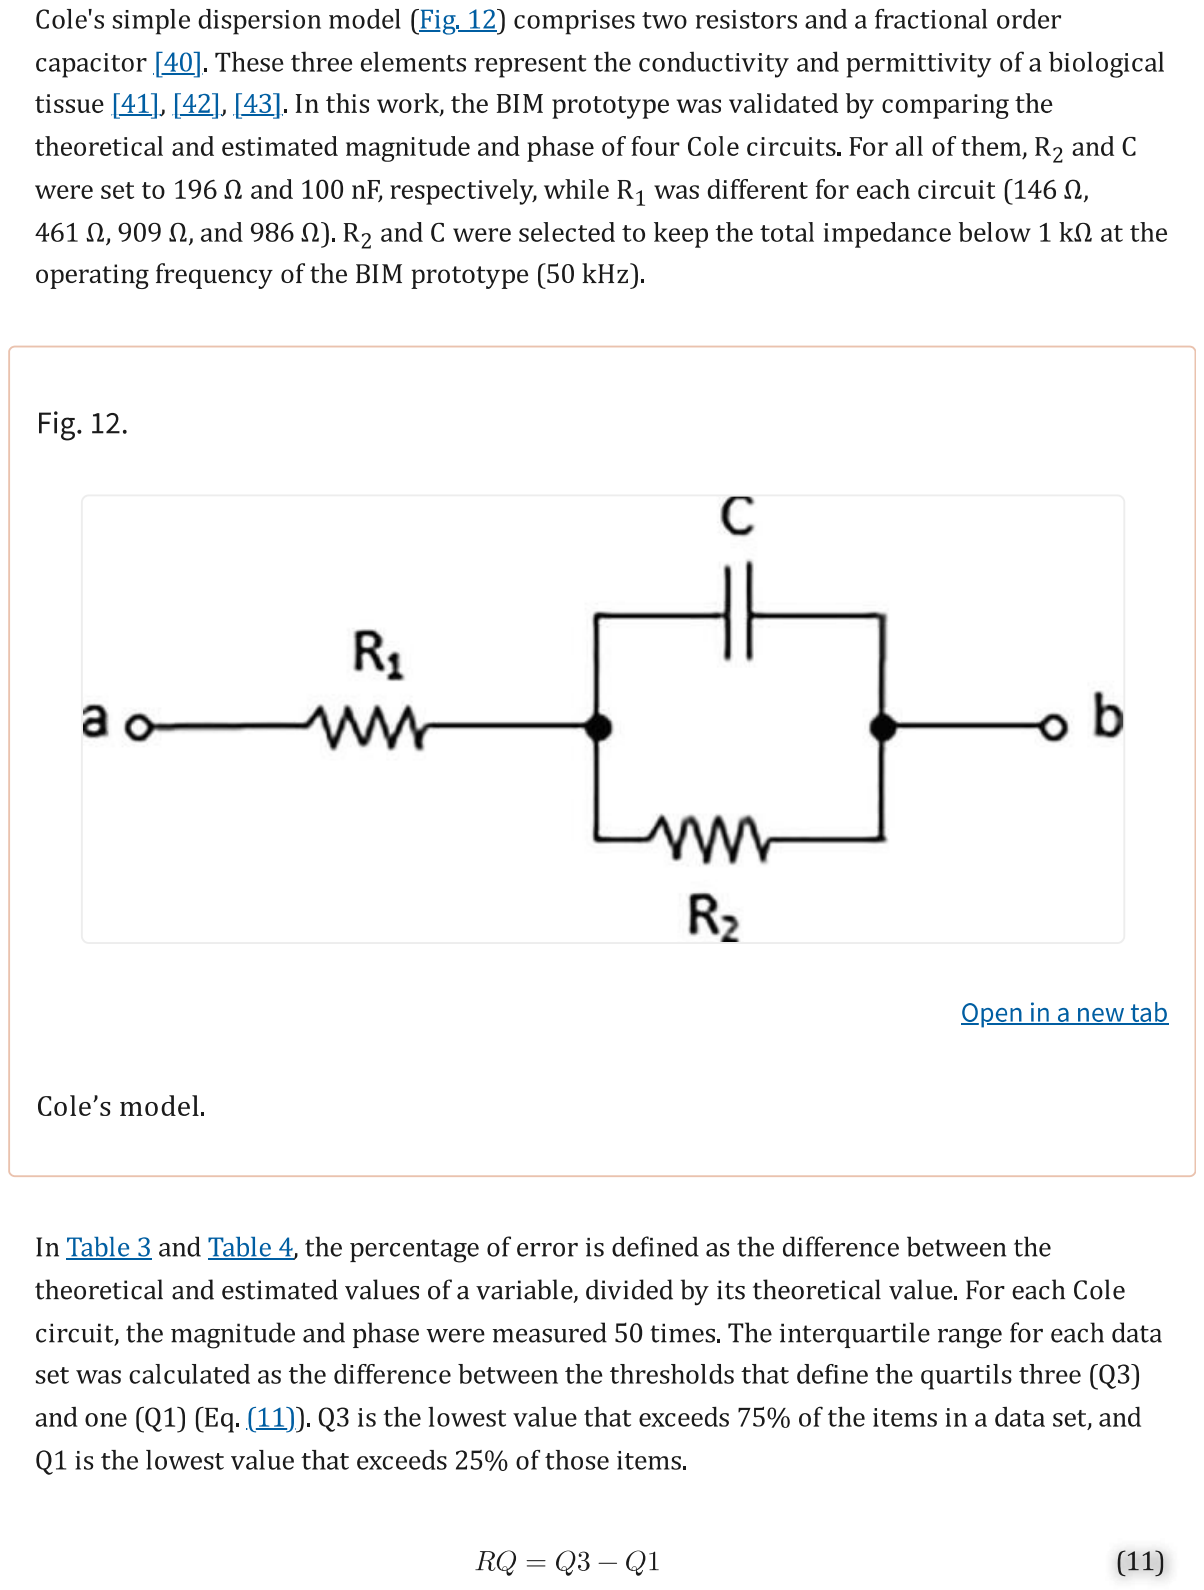
[picture p89: page 25]

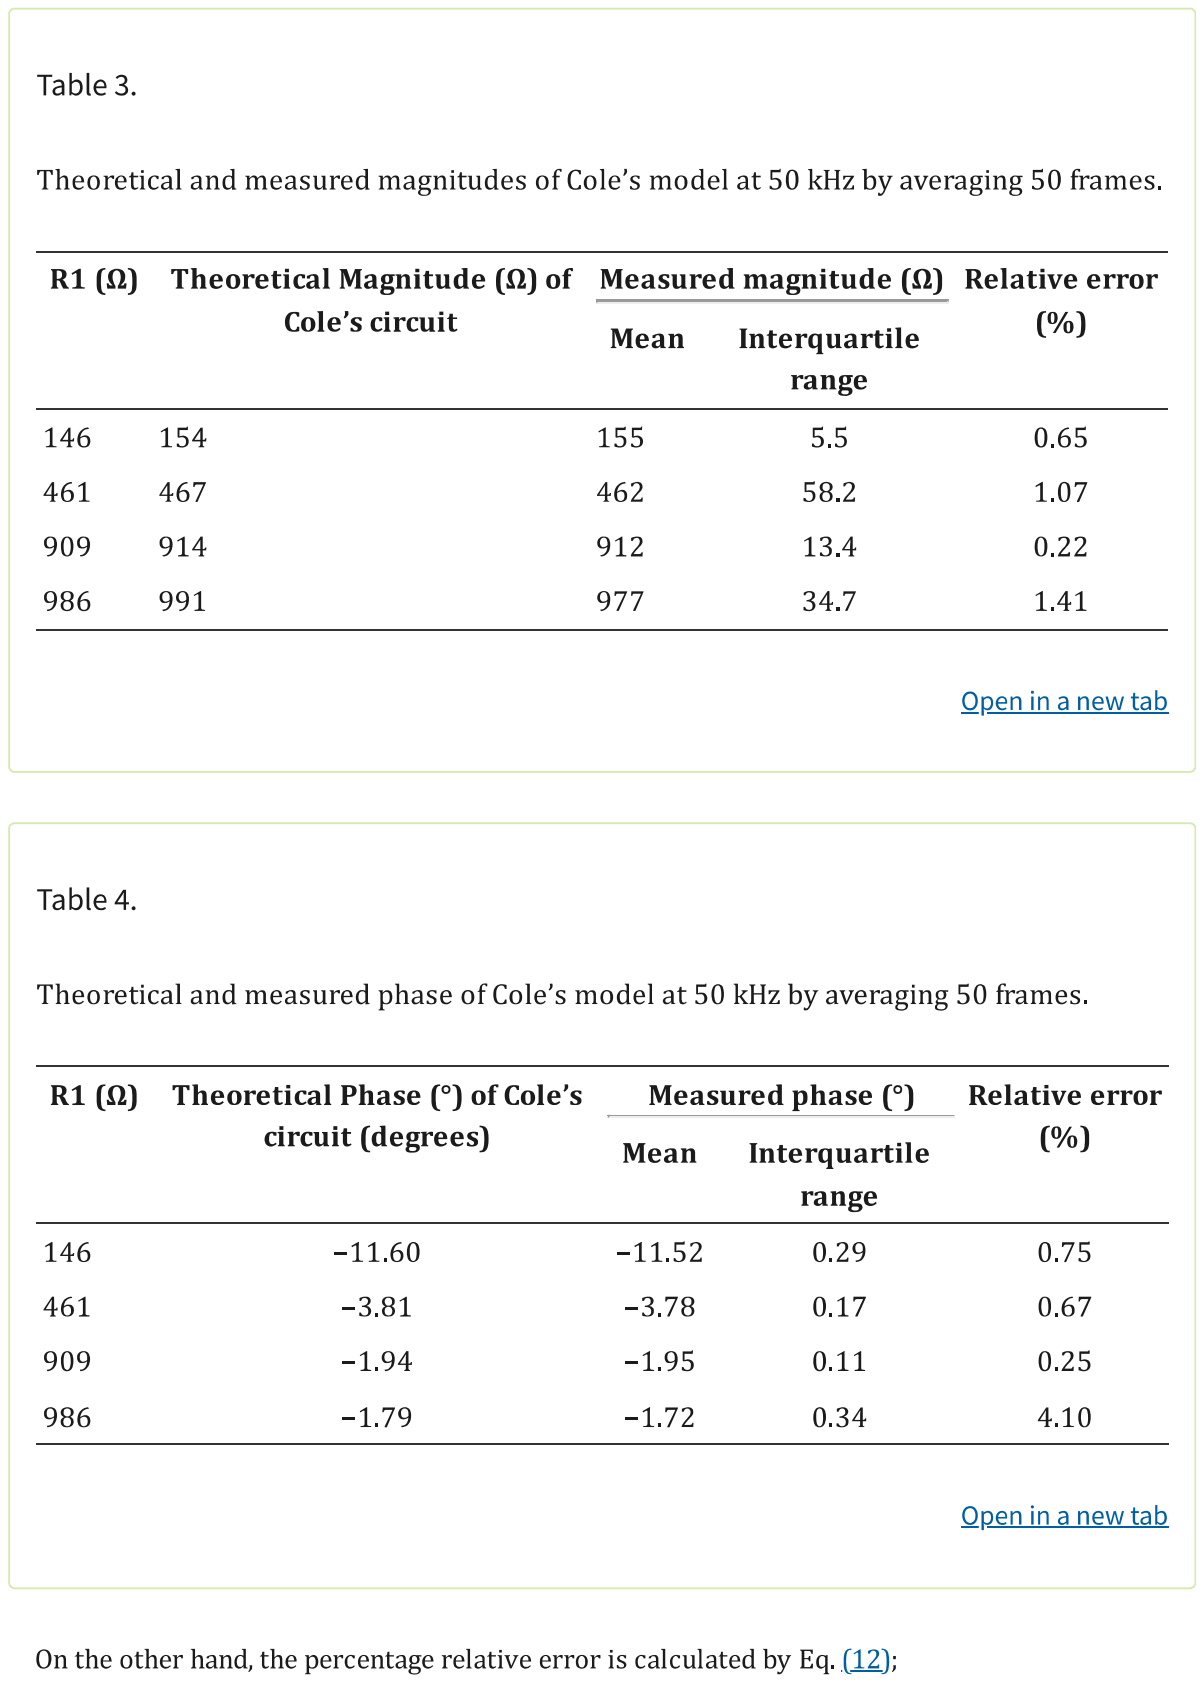
[picture p90: page 26]

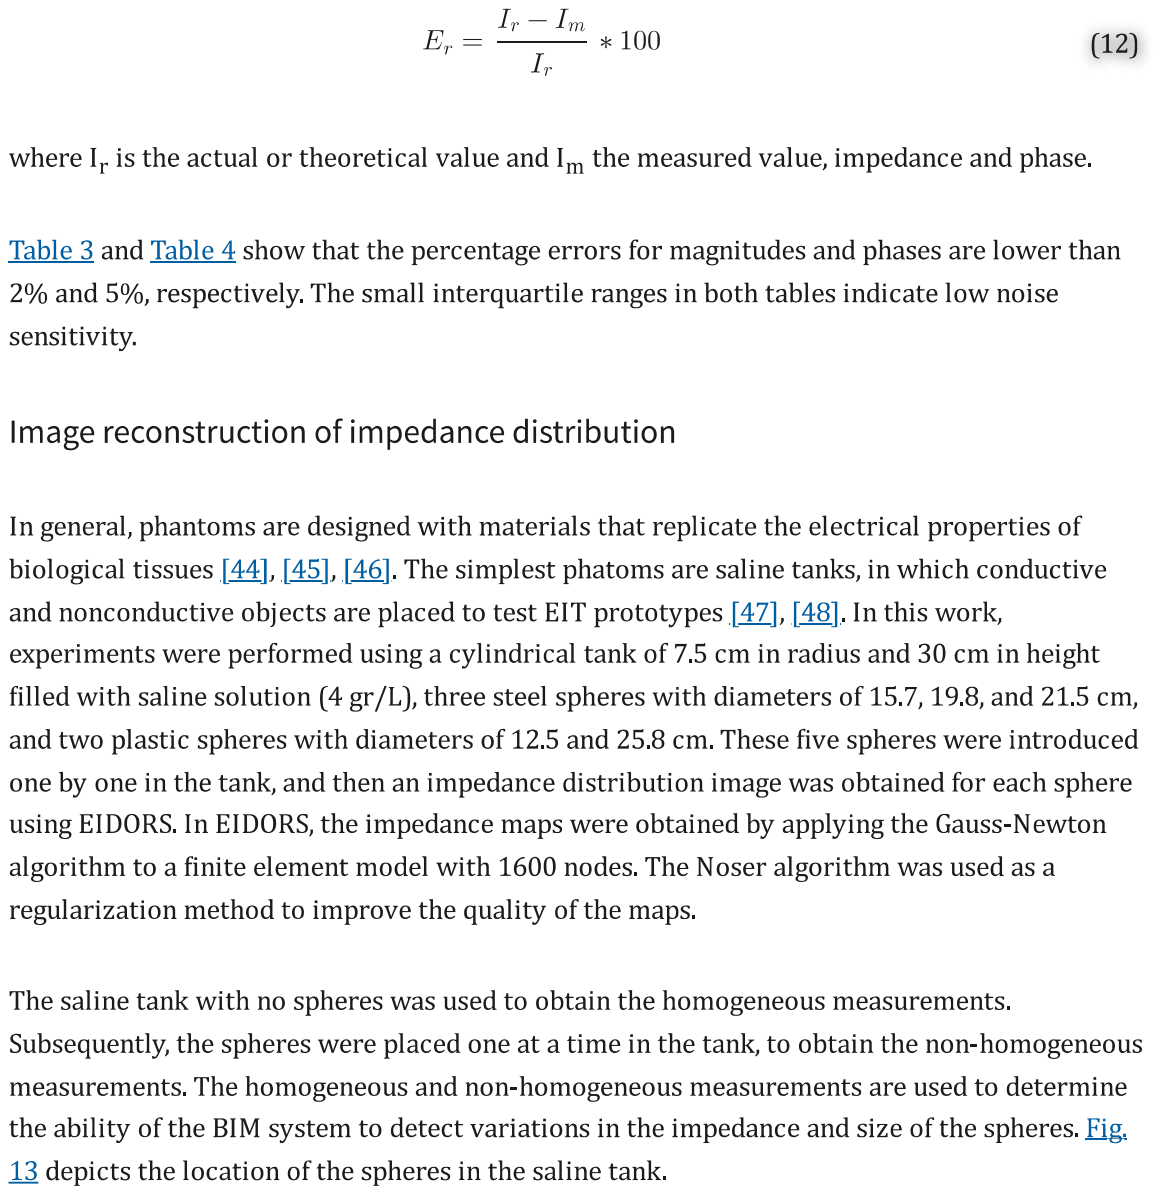
[picture p91: page 27]

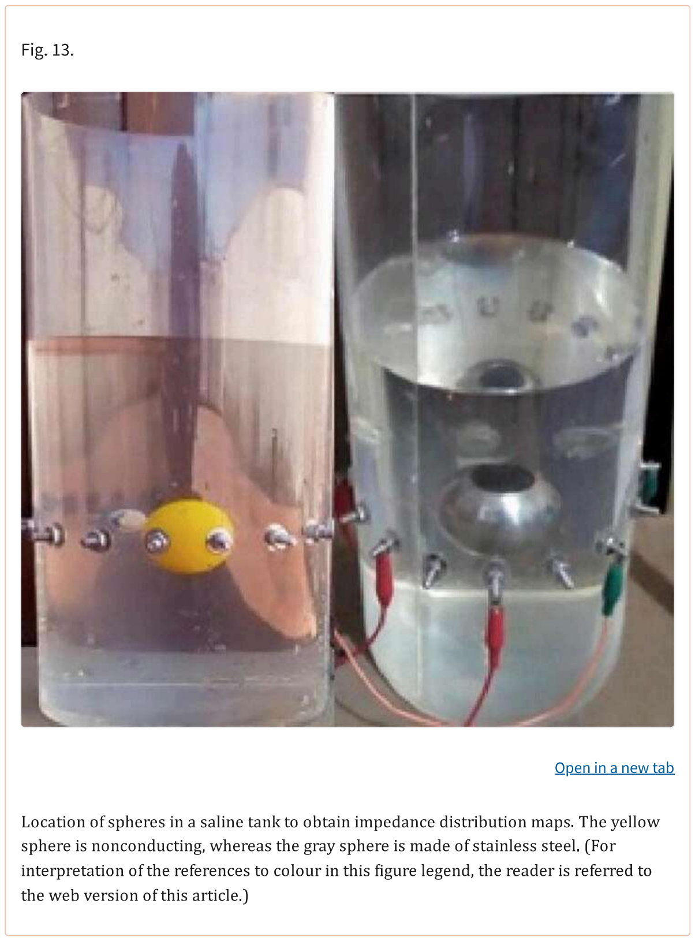
[picture p92: page 28]

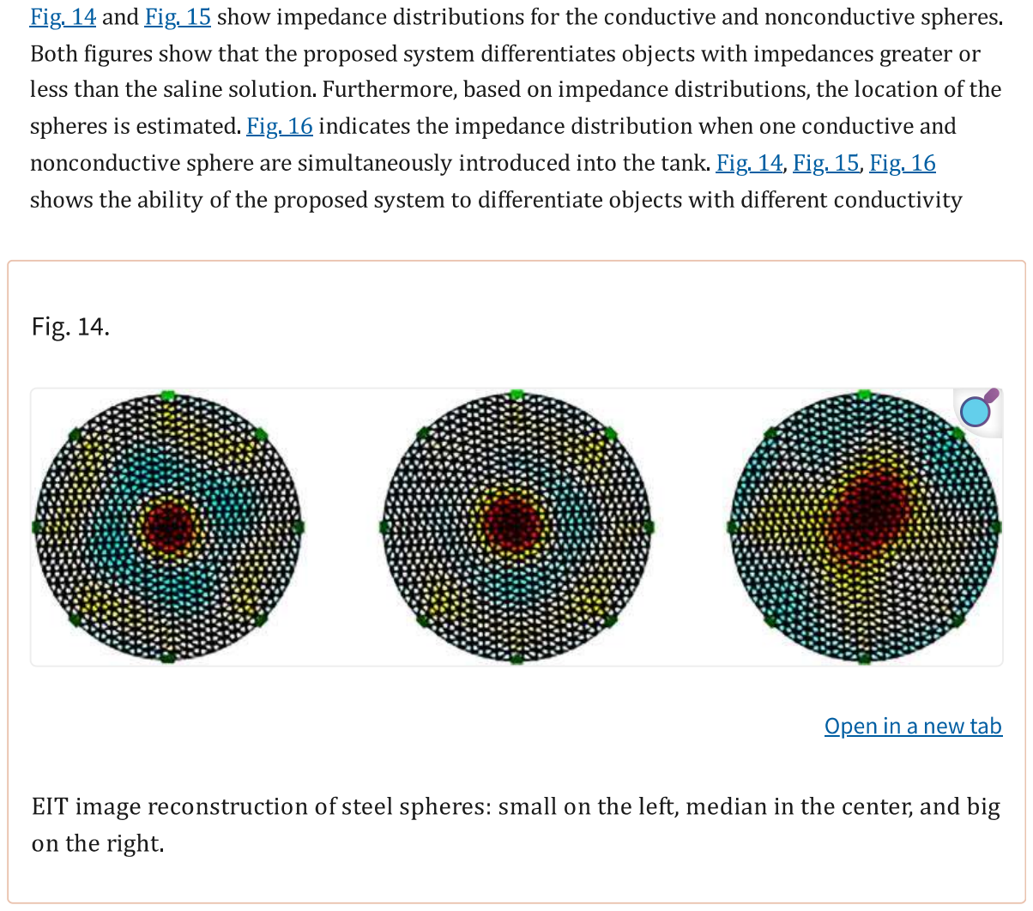
[picture p93: page 29]

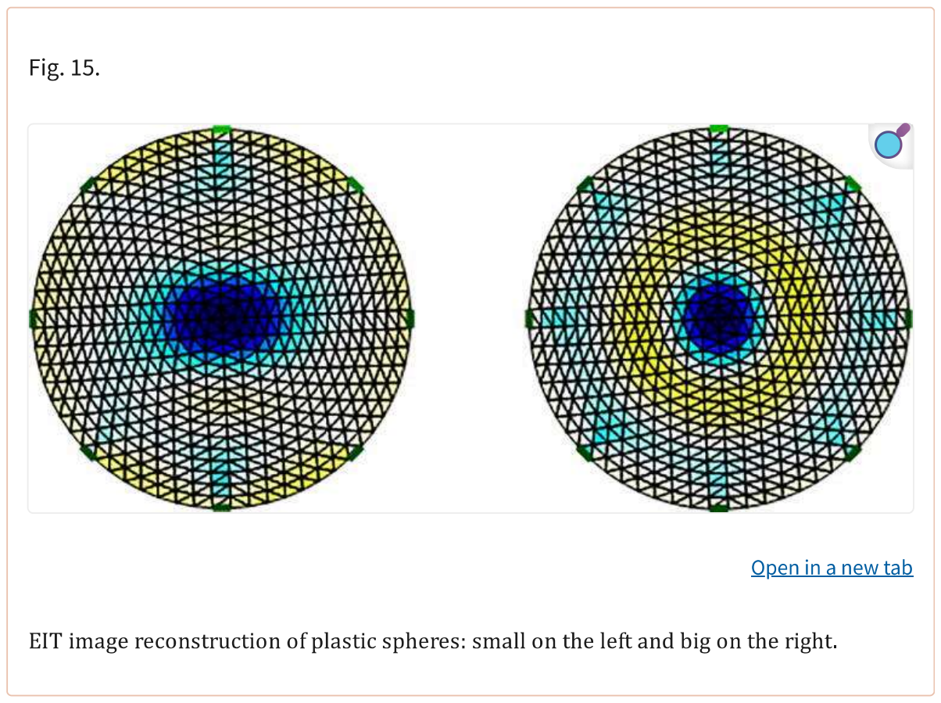
[picture p94: page 30]

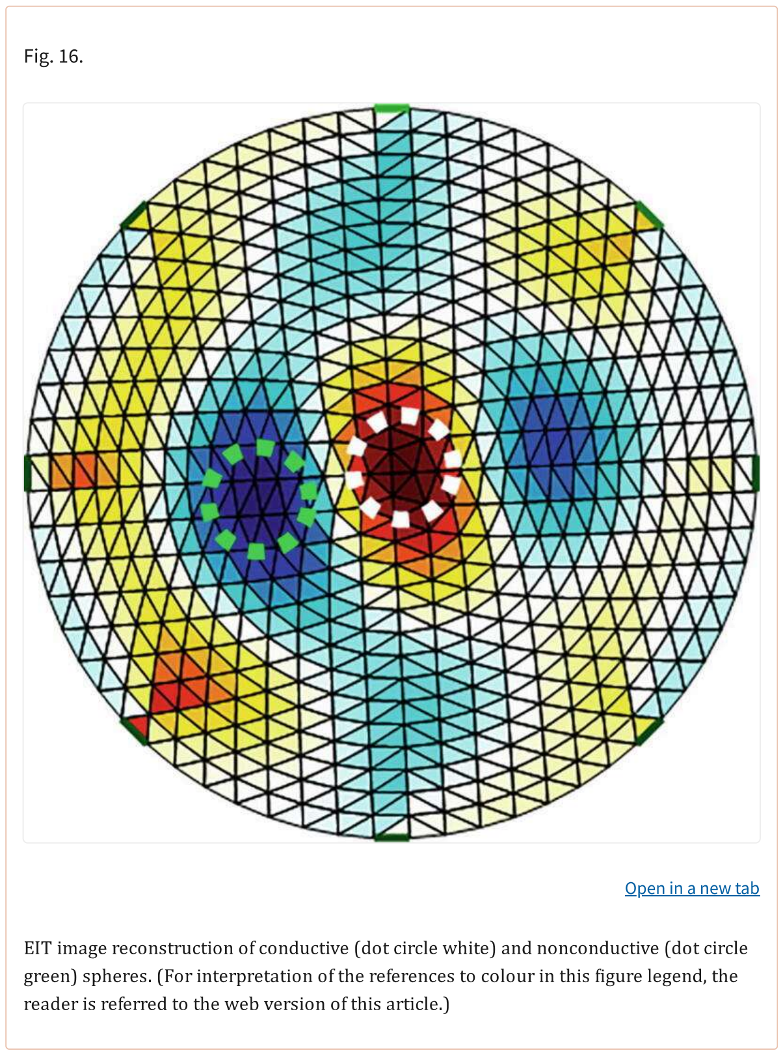
[picture p95: page 31]

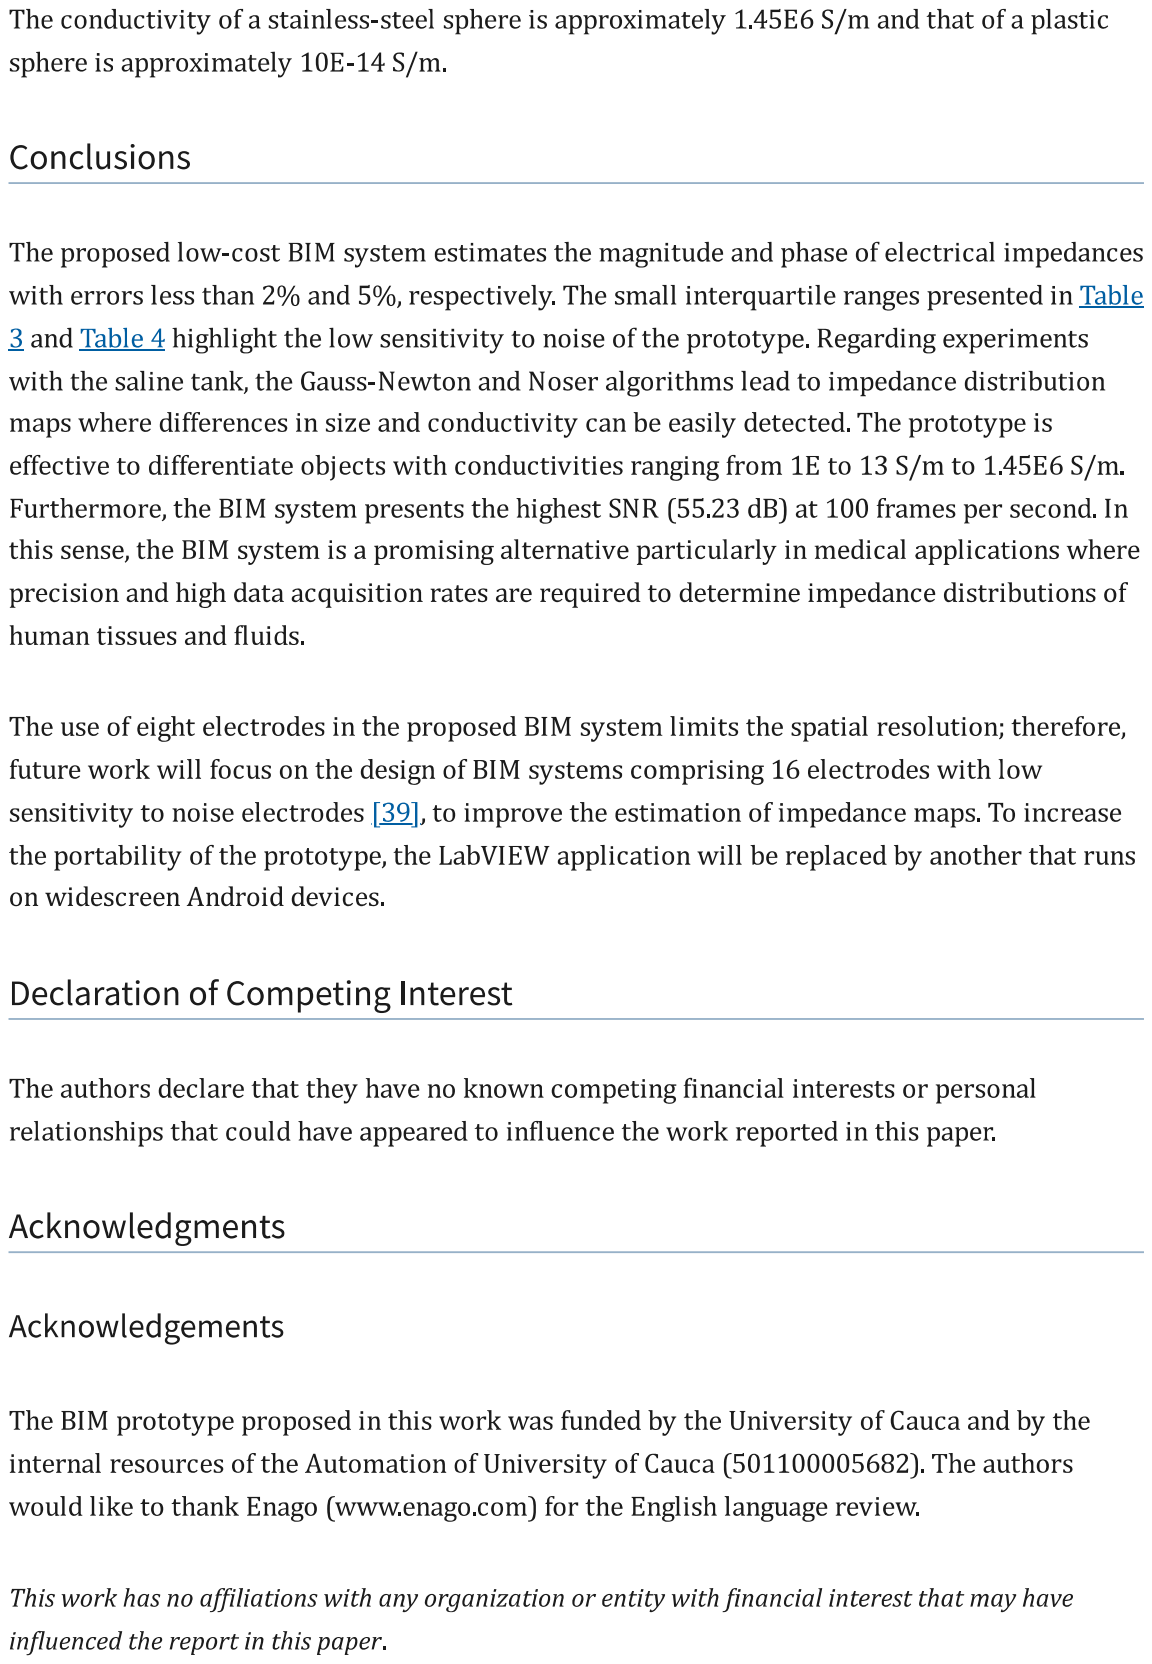
[picture p96: page 32]

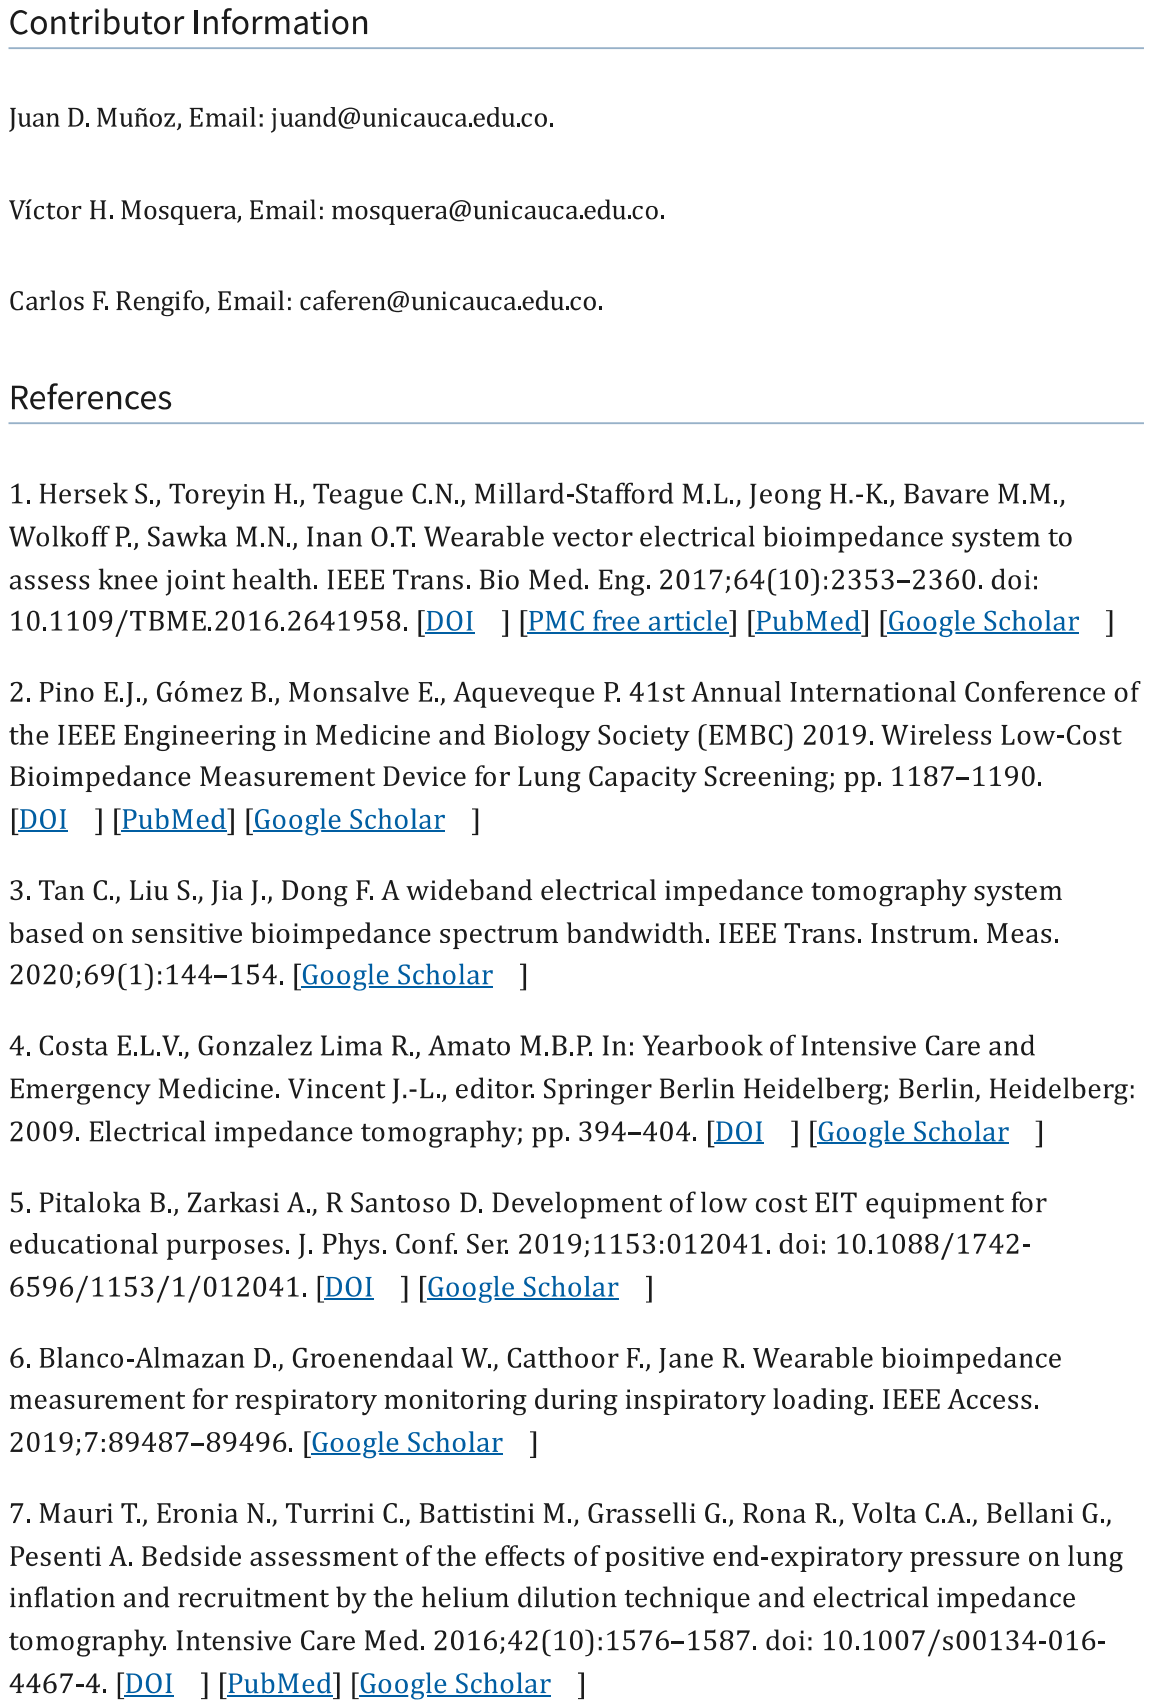
[picture p97: page 33]

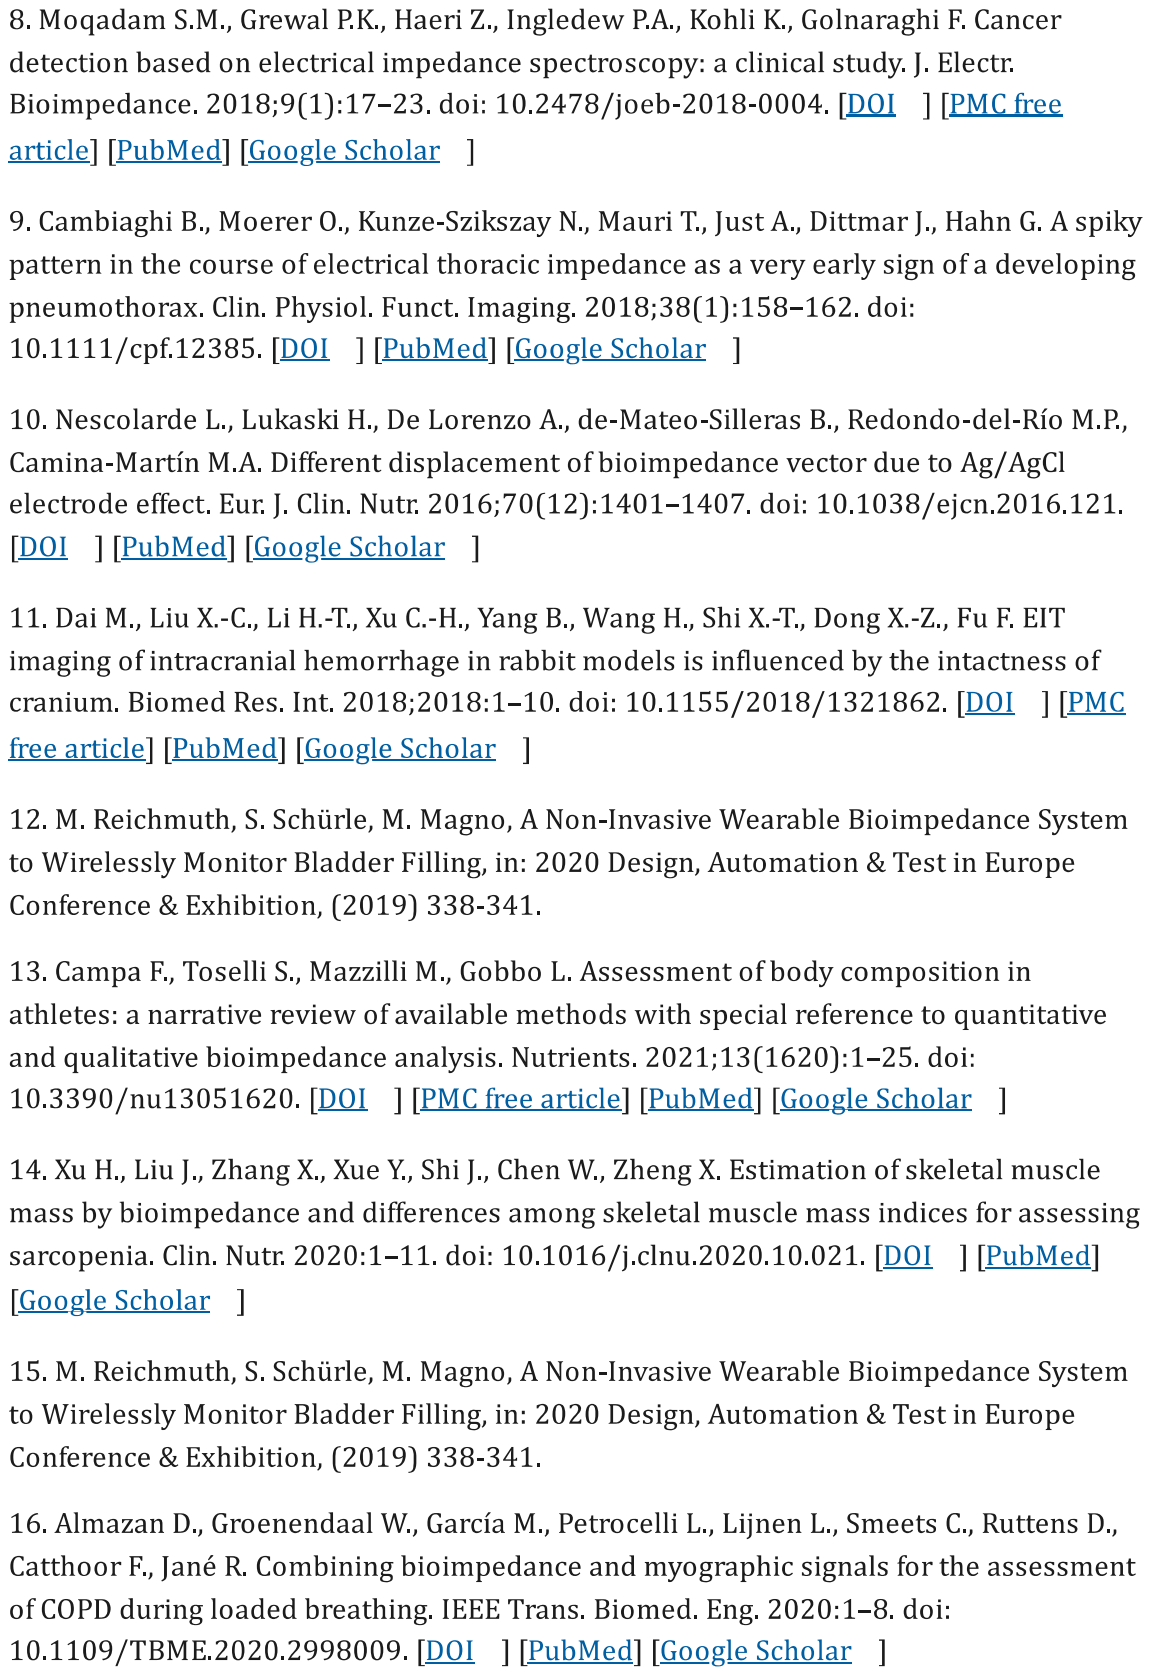
[picture p98: page 34]

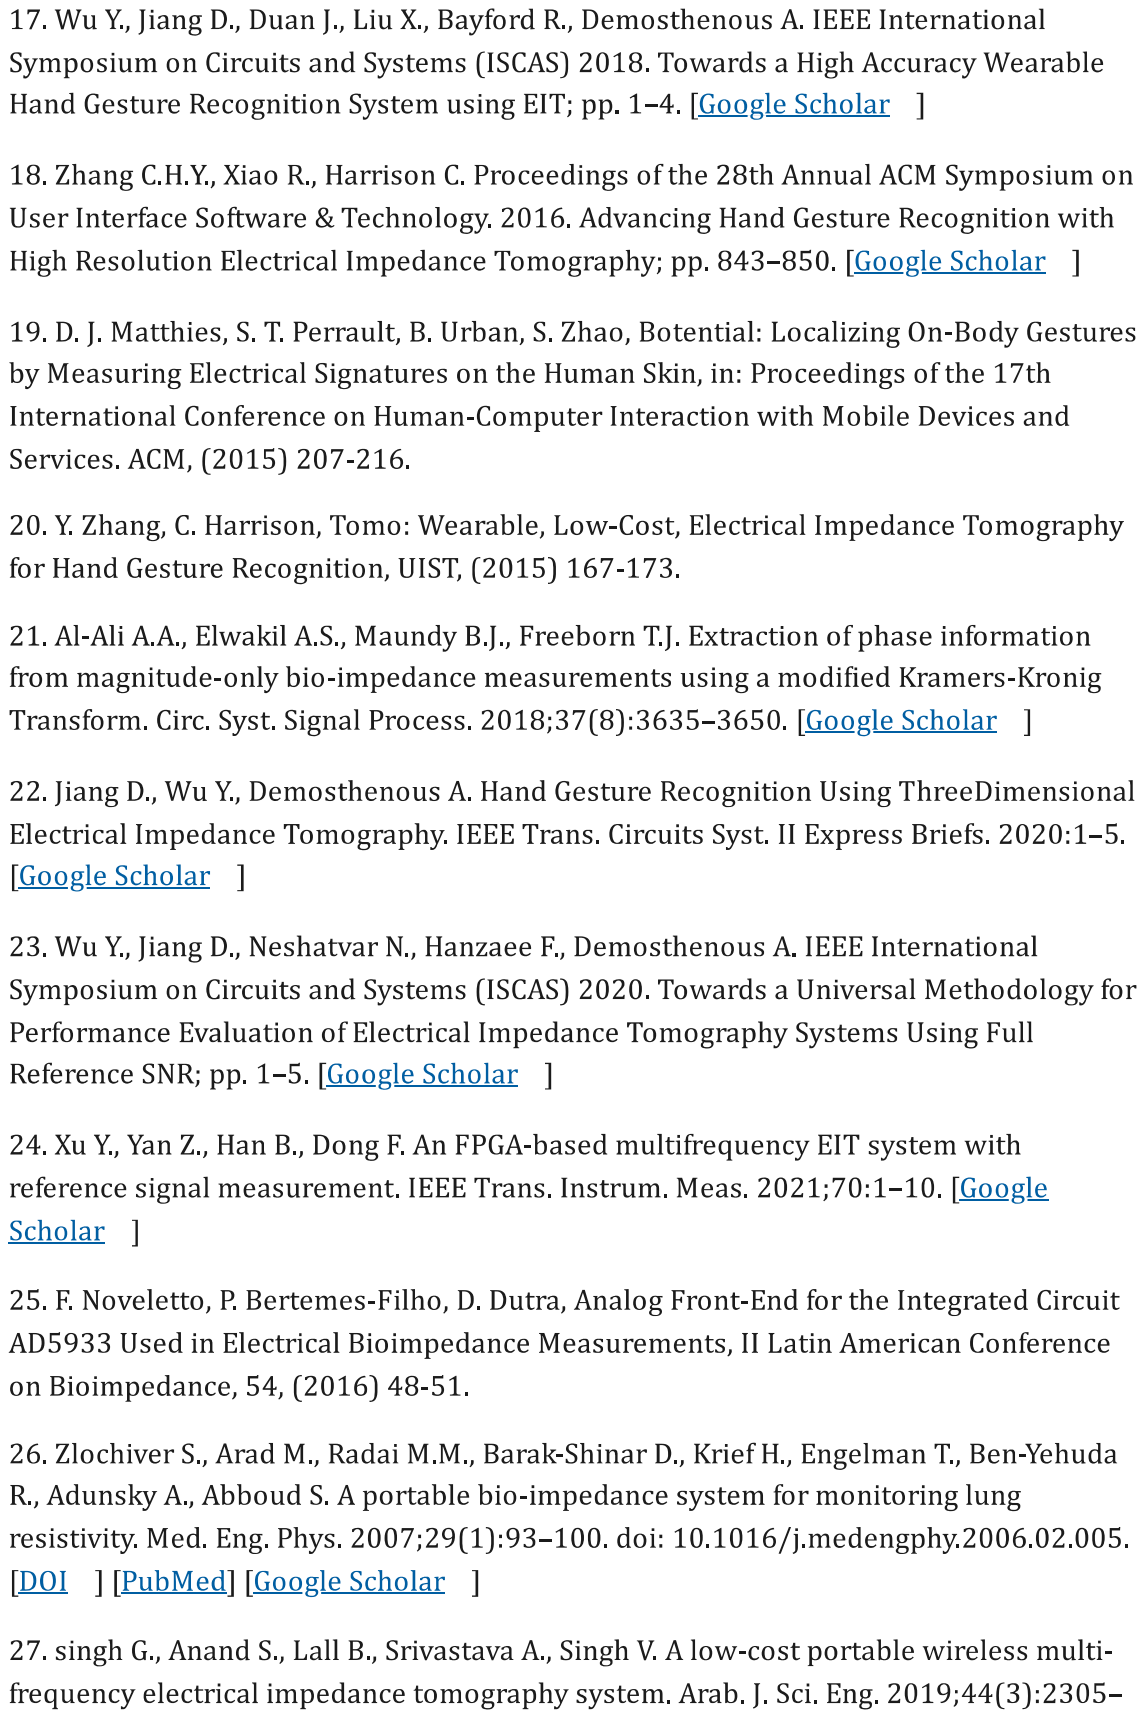
[picture p99: page 35]

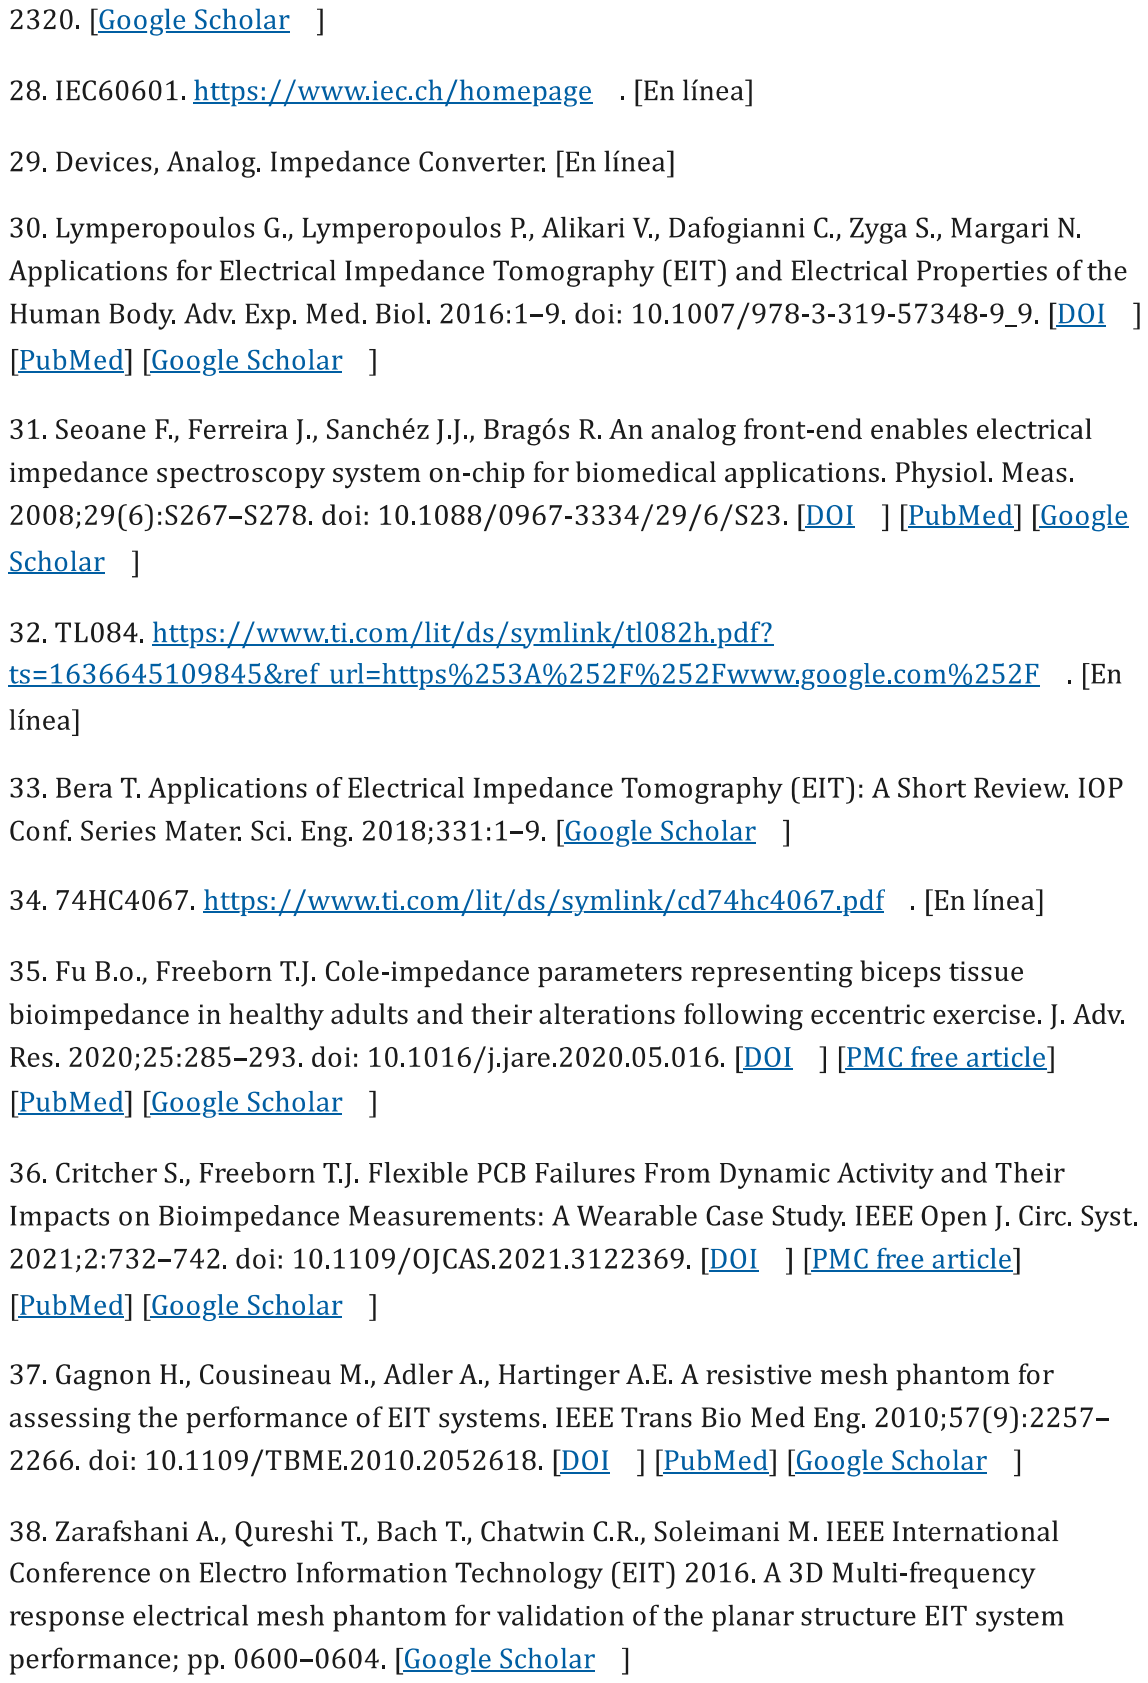
[picture p100: page 36]

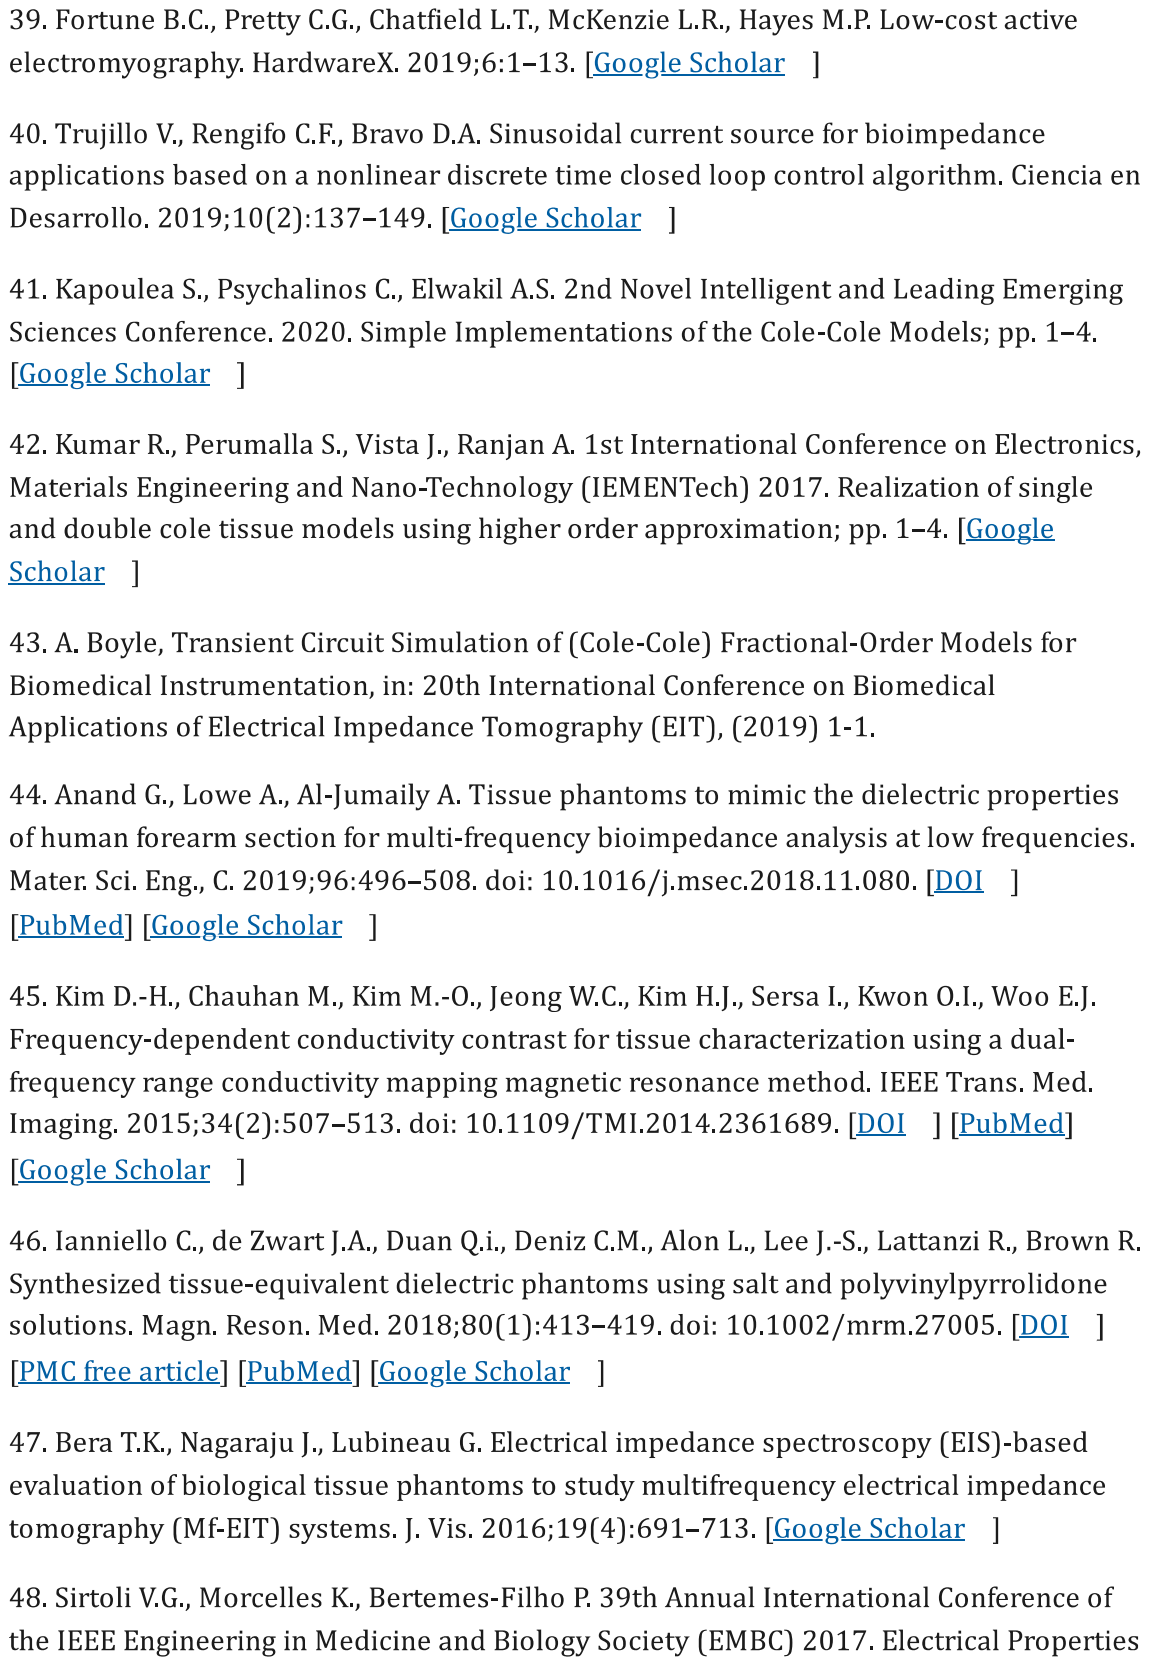
[picture p101: page 37]

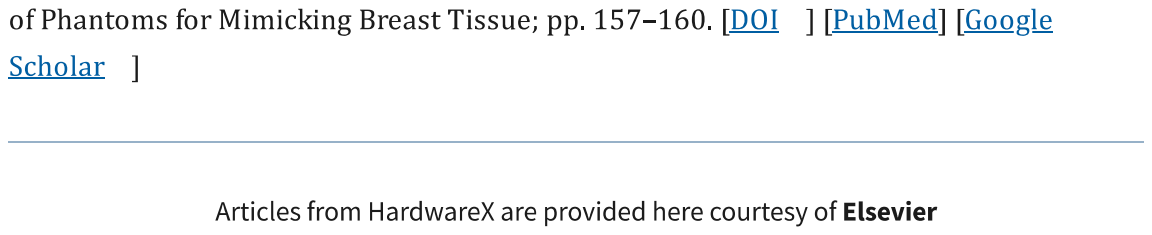
[picture p102: page 38]
