pablomattos/projeto-tcc-2026/(list of files, drawings)

Other design files:
AD5933/PCB/pcb-sensor-AD5933_2/pcb-sensor-AD5933.PcbDoc
AD5933/PCB/pcb-sensor-AD5933_2/pcb-sensor-AD5933_2/esquematico-sensor-AD5933.SchDoc
AD5933/PCB/pcb-sensor-AD5933_2/pcb-sensor-AD5933_2/pcb-sensor-AD5933.PcbDoc
AD5933/PCB/pcb-sensor-AD5933_2/pcb-sensor-AD5933_2/pcb-sensor-AD5933_2 3/pcb-sensor-AD5933_2 3/pcb-sensor-AD5933_2/esquematico-sensor-AD5933.SchDoc
AD5933/PCB/pcb-sensor-AD5933_2/pcb-sensor-AD5933_2/pcb-sensor-AD5933_2 3/pcb-sensor-AD5933_2 3/pcb-sensor-AD5933_2/pcb-sensor-AD5933.PcbDoc
AD5933/PCB/pcb-sensor-AD5933_2/pcb-sensor-AD5933_2/pcb-sensor-AD5933_2 3/pcb-sensor-AD5933_2 3/pcb-sensor-AD5933_2/pcb-sensor-AD5933_2.PrjPcb
AD5933/PCB/pcb-sensor-AD5933_2/pcb-sensor-AD5933_2/pcb-sensor-AD5933_2 3/pcb-sensor-AD5933_2 3/pcb-sensor-AD5933_2/pcb-sensor-AD5933_2/esquematico-sensor-AD5933.SchDoc
AD5933/PCB/pcb-sensor-AD5933_2/pcb-sensor-AD5933_2/pcb-sensor-AD5933_2 3/pcb-sensor-AD5933_2 3/pcb-sensor-AD5933_2/pcb-sensor-AD5933_2/pcb-sensor-AD5933.PcbDoc
AD5933/PCB/pcb-sensor-AD5933_2/pcb-sensor-AD5933_2/pcb-sensor-AD5933_2 3/pcb-sensor-AD5933_2 3/pcb-sensor-AD5933_2/pcb-sensor-AD5933_2/pcb-sensor-AD5933_2.PrjPcb
AD5933/PCB/pcb-sensor-AD5933_2/pcb-sensor-AD5933_2/pcb-sensor-AD5933_2.PrjPcb
AD5941/PCB_Project/PCB1.PcbDoc
AD5941/PCB_Project/PCB_Project.PrjPcb
AD5941/PCB_Project/Sheet2.SchDoc
AD5941/PCB_Project/Sheet3.SchDoc
AD5941/PCB_Project/Sheet4.SchDoc
