pablomattos/projeto-tcc-2026/AD5933/codes/teste-bancada.py

import numpy as np
import matplotlib.pyplot as plt
import pandas as pd
import io

# ======================================================
# LEITURA DOS DADOS COPIADOS DA BANCADA
# ======================================================
dados_bancada = """Freq(Hz),Impedancia(Ohm),Fase(°)
1000,2160.00,0.00
1200,2192.23,-0.33
1400,2221.16,0.31
1600,2222.78,3.24
1800,1971.64,-0.93
2000,2128.29,-4.99
2200,2045.09,-7.14
2400,2013.17,-12.65
2600,2110.32,-9.26
2800,2160.00,0.00
3000,1964.01,-4.58
3200,1990.11,-5.50
3400,1982.09,-6.05
3600,1941.88,-4.26
3800,1950.92,-4.99
4000,1963.75,-8.26
4200,1975.63,-3.51
4400,1989.89,-8.86
4600,1797.24,-3.68
4800,1975.63,-3.51
5000,1813.79,-3.37
5200,1813.79,-3.37
5400,1826.89,-8.72
5600,1813.79,-3.37
5800,1813.79,-3.37
6000,1813.79,-3.37
6200,1813.79,-3.37
6400,1826.89,-8.72
6600,1813.79,-3.37
6800,1813.79,-3.37
7000,1680.24,-3.25
7200,1680.24,-3.25
7400,1692.37,-8.60
7600,1692.37,-8.60
7800,1692.37,-8.60
8000,1692.37,-8.60
8200,1692.37,-8.60
8400,1692.37,-8.60
8600,1692.37,-8.60
8800,1692.37,-8.60
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

df = pd.read_csv(io.StringIO(dados_bancada))

# ======================================================
# CONVERSÃO PARA COMPONENTES DA IMPEDÂNCIA COMPLEXA
# ======================================================
fase_rad = np.radians(df['Fase(°)'])
df['Z_real'] = df['Impedancia(Ohm)'] * np.cos(fase_rad)
df['Z_imag'] = df['Impedancia(Ohm)'] * np.sin(fase_rad)

# Reorganizando as colunas conforme solicitado
df_final = df[['Freq(Hz)', 'Z_real', 'Z_imag', 'Fase(°)']]
df_final.columns = ['frequencia', 'Z_real', 'Z_imag', 'fase']

# Salvando no arquivo CSV
csv_filename = "resultado_bancada_final.csv"
df_final.to_csv(csv_filename, index=False, encoding="utf-8")
print(f"✅ Arquivo compilado e salvo com sucesso em: {csv_filename}")

# ======================================================
# PLOTAGEM DOS GRÁFICOS
# ======================================================
fig = plt.figure(figsize=(16, 5))
fig.patch.set_facecolor('#f4f4f4')

# 1. Bode - Magnitude
ax1 = fig.add_subplot(1, 3, 1)
ax1.plot(df_final['frequencia'], df['Impedancia(Ohm)'], color='#0066cc', marker='o', markersize=3, linewidth=1.5)
ax1.set_title("Diagrama de Bode - Magnitude", fontsize=12, fontweight='bold')
ax1.set_xlabel("Frequência (Hz)")
ax1.set_ylabel("Magnitude |Z| (Ω)")
ax1.grid(True, which="both", ls="--")

# 2. Bode - Fase
ax2 = fig.add_subplot(1, 3, 2)
ax2.plot(df_final['frequencia'], df_final['fase'], color='#cc3333', marker='o', markersize=3, linewidth=1.5)
ax2.set_title("Diagrama de Bode - Fase", fontsize=12, fontweight='bold')
ax2.set_xlabel("Frequência (Hz)")
ax2.set_ylabel("Fase (°)")
ax2.set_ylim(-15, 5)
ax2.grid(True, which="both", ls="--")

# 3. Diagrama de Nyquist
ax3 = fig.add_subplot(1, 3, 3)
# Em Nyquist de impedância, costuma-se plotar -Z_imag no eixo Y para manter orientação capacitiva padrão
ax3.plot(df_final['Z_real'], -df_final['Z_imag'], color='#660099', marker='o', markersize=4, linewidth=1.5)
ax3.set_title("Diagrama de Nyquist", fontsize=12, fontweight='bold')
ax3.set_xlabel("Z' (Real [Ω])")
ax3.set_ylabel("-Z'' (Imaginário [Ω])")
ax3.grid(True, which="both", ls="--")
ax3.set_aspect('equal', adjustable='datalim')

plt.tight_layout()
plt.show()
