pablomattos/projeto-tcc-2026/AD5933/codes/teste-bancada-2.py

import numpy as np
import matplotlib.pyplot as plt
import pandas as pd
import io
from scipy.signal import savgol_filter

# ======================================================
# LEITURA DOS DADOS COPIADOS DA BANCADA
# ======================================================
dados_bancada = """Freq(Hz),Impedancia(Ohm),Fase(°)
1000,2160.00,0.00
2000,2128.29,-4.99
3000,1964.01,-4.58
4000,1963.75,-8.26
5000,1813.79,-3.37
6000,1813.79,-3.37
7000,1680.24,-3.25
8000,1692.37,-8.60
9000,1574.64,-8.49
10000,1574.64,-8.49
11000,1574.74,-5.83
12000,1478.11,-5.90
13000,1478.11,-5.90
14000,1478.11,-5.90
15000,1496.81,-7.57
16000,1496.81,-7.57
17000,1496.81,-7.57
18000,1426.15,-4.24
19000,1426.15,-4.24
20000,1426.15,-4.24
21000,1444.54,-5.84
22000,1444.54,-5.84
23000,1326.09,-7.45
24000,1326.09,-7.45
25000,1309.43,-4.32
26000,1309.43,-4.32
27000,1309.43,-4.32
28000,1288.79,-1.19
29000,1383.08,-5.30
30000,1383.08,-5.30
31000,1383.08,-5.30
32000,1356.27,-2.22
33000,1356.27,-2.22
34000,1356.27,-2.22
35000,1356.27,-2.22
36000,1213.85,-1.40
37000,1271.94,-6.32
38000,1339.44,-4.92
39000,1339.44,-4.92
40000,1297.87,-1.49
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

df = pd.read_csv(io.StringIO(dados_bancada))

# ======================================================
# CONVERSÃO PARA COMPONENTES DA IMPEDÂNCIA COMPLEXA
# ======================================================
fase_rad = np.radians(df['Fase(°)'])
df['Z_real'] = df['Impedancia(Ohm)'] * np.cos(fase_rad)
df['Z_imag'] = df['Impedancia(Ohm)'] * np.sin(fase_rad)

# ======================================================
# GERAÇÃO DAS CURVAS DE TENDÊNCIA (SUAVIZAÇÃO MATEMÁTICA)
# ======================================================
# Filtro Savitzky-Golay: ajusta polinômios locais eliminando ruídos sem distorcer o sinal
window_size = 15  # Janela de amostragem (deve ser ímpar)
poly_order = 2   # Grau do polinômio de ajuste

df['Mag_Tendencia'] = savgol_filter(df['Impedancia(Ohm)'], window_size, poly_order)
df['Fase_Tendencia'] = savgol_filter(df['Fase(°)'], window_size, poly_order)
df['Z_real_Tendencia'] = savgol_filter(df['Z_real'], window_size, poly_order)
df['Z_imag_Tendencia'] = savgol_filter(df['Z_imag'], window_size, poly_order)

# ======================================================
# PLOTAGEM DOS GRÁFICOS COM LINHAS DE TENDÊNCIA
# ======================================================
fig = plt.figure(figsize=(18, 5.5))
fig.patch.set_facecolor('#f4f4f4')

# 1. Bode - Magnitude
ax1 = fig.add_subplot(1, 3, 1)
ax1.scatter(df['Freq(Hz)'], df['Impedancia(Ohm)'], color='#0066cc', alpha=0.4, s=15, label='Medido (Bancada)')
ax1.plot(df['Freq(Hz)'], df['Mag_Tendencia'], color='#003399', linewidth=2.5, label='Curva de Tendência')
ax1.set_title("Bode - Magnitude com Tendência", fontsize=12, fontweight='bold')
ax1.set_xlabel("Frequência (Hz)")
ax1.set_ylabel("Magnitude |Z| (Ω)")
ax1.grid(True, which="both", ls="--")
ax1.legend()

# 2. Bode - Fase
ax2 = fig.add_subplot(1, 3, 2)
ax2.scatter(df['Freq(Hz)'], df['Fase(°)'], color='#cc3333', alpha=0.4, s=15, label='Medido (Bancada)')
ax2.plot(df['Freq(Hz)'], df['Fase_Tendencia'], color='#990000', linewidth=2.5, label='Curva de Tendência')
ax2.set_title("Bode - Fase com Tendência", fontsize=12, fontweight='bold')
ax2.set_xlabel("Frequência (Hz)")
ax2.set_ylabel("Fase (°)")
ax2.set_ylim(-15, 5)
ax2.grid(True, which="both", ls="--")
ax2.legend()

# 3. Diagrama de Nyquist
ax3 = fig.add_subplot(1, 3, 3)
# Plotando -Z_imag para manter orientação capacitiva padrão no eixo Y
ax3.scatter(df['Z_real'], -df['Z_imag'], color='#660099', alpha=0.4, s=15, label='Medido (Bancada)')
ax3.plot(df['Z_real_Tendencia'], -df['Z_imag_Tendencia'], color='#440066', linewidth=2.5, label='Curva de Tendência')
ax3.set_title("Diagrama de Nyquist com Tendência", fontsize=12, fontweight='bold')
ax3.set_xlabel("Z' (Real [Ω])")
ax3.set_ylabel("-Z'' (Imaginário [Ω])")
ax3.grid(True, which="both", ls="--")
ax3.set_aspect('equal', adjustable='datalim')
ax3.legend()

plt.tight_layout()
plt.show()
