pablomattos/projeto-tcc-2026/(commit log)

2026-05-07 Add de pesquisa AD5933 e seus projetos, inicio TCC
    [BIM_System_Components.xlsx]
2026-05-08 Organização de arquivos
2026-05-18 repository content organization
    [BIM_System_Components.xlsx]
2026-05-22 Add arquivos apresentação e conteúdo do código do sensor
    [AD5933_Bode_20260519_1421.csv, AD5933_Bode_20260519_1424.csv, AD5933_Bode_20260519_1504.csv, AD5933_Bode_20260519_1518.csv, AD5933_Bode_20260519_1521.csv, AD5933_Bode_20260519_1524.csv, AD5933_Bode_20260519_1610.csv, AD5933_Bode_20260519_1632.csv]
2026-05-25 add new sensor presentation
2026-05-26 Add code resistor-test
2026-06-10 Add conteudo
    [AD5933_Bode_20260519_1421.csv, AD5933_Bode_20260519_1424.csv, AD5933_Bode_20260519_1504.csv, AD5933_Bode_20260519_1518.csv, AD5933_Bode_20260519_1521.csv, AD5933_Bode_20260519_1524.csv, AD5933_Bode_20260519_1610.csv, AD5933_Bode_20260519_1632.csv]
2026-06-10 Adicao de arquivo do esquema eletrico
    [esp32_ad5933_tempo_real.csv]
2026-06-10 lista de materiais
2026-06-11 formatacao da documentacao
    [BIM_System_Components.xlsx, esp32_ad5933_tempo_real.csv]
2026-06-11 Arquivo comparative analysis
    [BIM_System_Components.xlsx]
2026-06-12 Tabela de projetos
2026-06-12 correcao na tabela de projetos
2026-07-03 alteracao na tabela de materiais
    [dados_impedancia.csv, dados_tendencia_bode.csv, resultado_bancada_final.csv, simulacao_teorica.csv, simulacao_teorica_linear.csv]
2026-09-09 atualizacao pcbAD5933
    [pcb-sensor-AD5933.PcbDoc, pcb-sensor-AD5933_2.PrjPcb]
2026-09-10 Adicao resumo TCC
    [esquematico-sensor-AD5933.SchDoc, pcb-sensor-AD5933.PcbDoc, simulacao_teorica_linear.csv]
2026-09-11 Atualizacao do resumo e adicao de imagens das curvas
    [pcb-sensor-AD5933_2.PrjPcb]
2026-09-25 novo codigo compara testes
    [AD5933_Bode_20260924_144053.csv, AD5933_Bode_20260925_090109.csv, PCB1.PcbDoc, PCB_Project.PrjPcb, Sheet2.SchDoc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]
